holgiw/ESP32-netspeaker/stations/README.md

# Senderlisten / Station lists

## Deutsch

Fertige Listen für den Tab *Webradio*. Im Abschnitt *Senderlisten* bei *Fertige Liste* eine Liste wählen und *Von GitHub laden* drücken, oder die Datei herunterladen und mit *Liste laden* einlesen. **Das Laden ersetzt die ganze Senderliste**; vorher mit *Liste speichern* sichern. RSA wird nur dann vorn eingetragen, wenn die Senderliste vorher leer war; bei allen Änderungen danach wird er nicht wieder eingetragen (die Listen hier enthalten ihn nicht). Vorn stehen deine Favoriten (Tab *Webradio*), dann die Sender der Liste ohne Doppelte; was über die 30 Plätze hinausgeht, entfällt.

Die Auswahl im Tab stammt aus der Datei `index.txt` in diesem Ordner (eine Zeile je Liste: `name|Beschreibung deutsch|Beschreibung englisch`). **Eine neue Liste braucht kein neues Flashen:** Datei `name.txt` und eine Zeile in `index.txt` auf GitHub ablegen, dann erscheint sie nach dem Neuladen der Seite. Ohne Internet im Browser bleiben die vier ersten Listen im Auswahlfeld.

| Datei | Inhalt |
|---|---|
| `aac-auswahl` | 29 Sender: Sender als AAC/HE-AAC |
| `mp3-auswahl` | 29 Sender: Beliebte deutsche Sender als MP3 |
| `rock` | 25 Sender: Rock, Metal, Punk und Klassiker |
| `entspannung` | 24 Sender: Ruhe, Klassik, Jazz und Chillout |
| `schlager` | 24 Sender: Deutscher Schlager und Volksmusik |
| `country` | 24 Sender: Country, Bluegrass und Western |
| `folk` | 24 Sender: Folk, Irish, Celtic und Akustik |
| `jazz` | 24 Sender: Jazz, Smooth Jazz, Blues und Lounge |
| `klassik` | 24 Sender: Klassik, Oper und Barock |
| `pop-charts` | 24 Sender: Pop, Charts und Hitradios aus Deutschland |
| `jahrzehnte` | 24 Sender: Oldies, 60er bis 90er |
| `dance` | 24 Sender: Dance, Electro, House und Techno |
| `hiphop` | 24 Sender: Hip-Hop, Rap und R&B |
| `irland` | 24 Sender: Beliebte Sender aus Irland |
| `usa` | 24 Sender: Beliebte Sender aus den USA |
| `australien` | 24 Sender: Beliebte Sender aus Australien |
| `grossbritannien` | 24 Sender: Beliebte Sender aus Großbritannien |
| `frankreich` | 24 Sender: Beliebte Sender aus Frankreich |
| `weihnachten` | 24 Sender: Weihnachtslieder und Weihnachtsradios |

Alle Streams waren beim Anlegen erreichbar (Audiodaten abgerufen; die AAC-Sender zusätzlich auf dem Gerät abgespielt). Sender ändern ihre Adressen von Zeit zu Zeit; ein toter Eintrag lässt sich im Tab ersetzen.

## English

Ready-made lists for the *Webradio* tab. In the section *Senderlisten* pick a list at *Fertige Liste* and press *Von GitHub laden*, or download the file and read it in with *Liste laden*. **Loading replaces the whole station list**; save it first with *Liste speichern*. RSA is put at the front only if the station list was empty before; with all changes after that it is not entered again (the lists here do not contain it). Your favorites (*Webradio* tab) come first, then the stations of the list without duplicates; whatever exceeds the 30 slots is dropped.

The selection in the tab comes from the file `index.txt` in this folder (one line per list: `name|description German|description English`). **A new list needs no new flashing:** put the file `name.txt` and one line in `index.txt` on GitHub, and it appears after the page is reloaded. Without internet in the browser the first four lists stay in the selection field.

| File | Content |
|---|---|
| `aac-auswahl` | 29 stations: Stations as AAC/HE-AAC |
| `mp3-auswahl` | 29 stations: Popular German stations as MP3 |
| `rock` | 25 stations: Rock, metal, punk and classics |
| `entspannung` | 24 stations: Calm, classical, jazz and chillout |
| `schlager` | 24 stations: German Schlager and folk music |
| `country` | 24 stations: Country, bluegrass and western |
| `folk` | 24 stations: Folk, Irish, Celtic and acoustic |
| `jazz` | 24 stations: Jazz, smooth jazz, blues and lounge |
| `klassik` | 24 stations: Classical, opera and baroque |
| `pop-charts` | 24 stations: Pop, charts and hit radio from Germany |
| `jahrzehnte` | 24 stations: Oldies, 60s to 90s |
| `dance` | 24 stations: Dance, electro, house and techno |
| `hiphop` | 24 stations: Hip hop, rap and R&B |
| `irland` | 24 stations: Popular stations from Ireland |
| `usa` | 24 stations: Popular stations from the USA |
| `australien` | 24 stations: Popular stations from Australia |
| `grossbritannien` | 24 stations: Popular stations from the UK |
| `frankreich` | 24 stations: Popular stations from France |
| `weihnachten` | 24 stations: Christmas songs and Christmas radios |

All streams were reachable when the lists were made (audio data retrieved; the AAC stations were also played on the device). Stations change their addresses from time to time; a dead entry can be replaced in the tab.
