holgiw/ESP32-netspeaker/docs/screenshots/07-doku.jpg

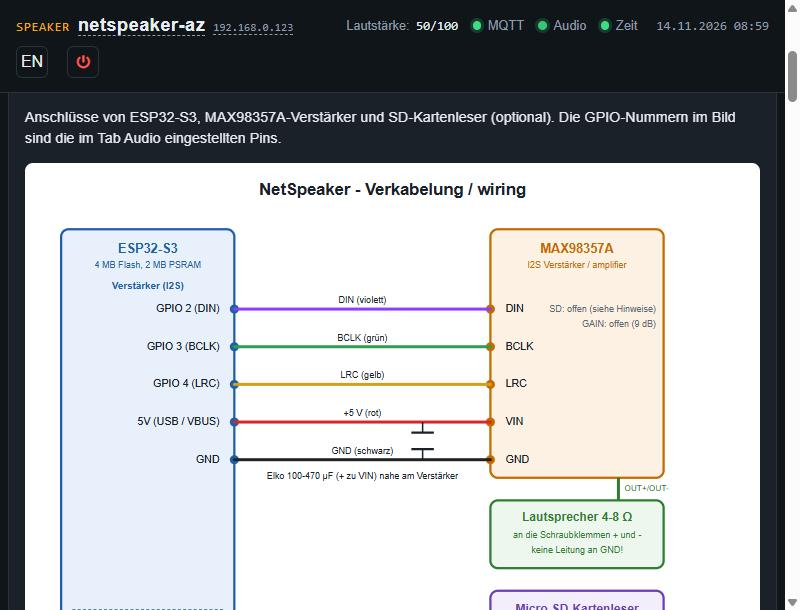
docs/screenshots/07-doku.jpg
