holgiw/ESP32-netspeaker/docs/screenshots/08-webradio-english.jpg

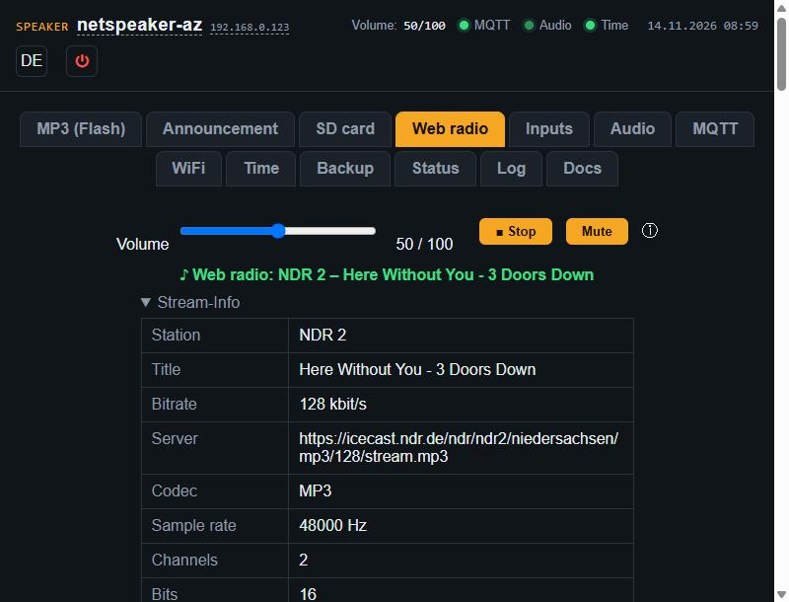
docs/screenshots/08-webradio-english.jpg
