holgiw/ESP32-netspeaker/docs/screenshots/09-sicherung.jpg

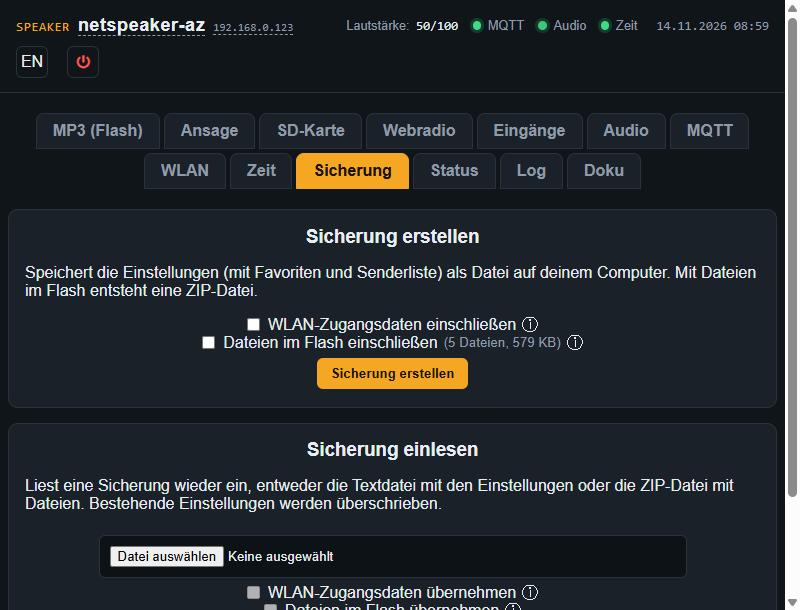
docs/screenshots/09-sicherung.jpg
