holgiw/ESP32-netspeaker/CHANGELOG.md

# Changelog

## 2026-11-14 - Version 1.6.11

**Deutsch**

- Neu: Das MQTT-Passwort steht jetzt in der Sicherung (verschlüsselt wie die WLAN-Passwörter und der VoiceRSS-Schlüssel, nur beim Export aus dem lokalen Netz) und wird beim Import wieder eingelesen, ebenfalls nur aus dem lokalen Netz. Es erscheint nur, wenn ein Benutzer und ein Passwort gespeichert sind.

**English**

- New: the MQTT password is now part of the backup (encrypted like the WiFi passwords and the VoiceRSS key, only when exporting from the local network) and is read again on import, also only from the local network. It appears only if a user and a password are stored.

## 2026-11-14 - Version 1.6.10

**Deutsch**

- Neu: Der VoiceRSS-Schlüssel steht jetzt in der Sicherung (verschlüsselt wie die WLAN-Passwörter, nur beim Export aus dem lokalen Netz) und wird beim Import wieder eingelesen. Das MQTT-Passwort bleibt weiter draußen.

**English**

- New: the VoiceRSS key is now part of the backup (encrypted like the WiFi passwords, only when exporting from the local network) and is read again on import. The MQTT password stays out.

## 2026-11-14 - Version 1.6.9

**Deutsch**

- Geändert: Die WLAN-Passwörter stehen in der Sicherung (Export mit `wifi=1`) nicht mehr im Klartext, sondern verschlüsselt (AES-256, Format `enc:<IV>:<Daten>`). Der Schlüssel steckt in der Firmware und ist in allen Geräten gleich, eine Sicherung lässt sich also auf jedem Gerät einspielen. Alte Sicherungen mit Klartext-Passwörtern lassen sich weiter einlesen.

**English**

- Changed: the WiFi passwords in the backup (export with `wifi=1`) are no longer in plain text but encrypted (AES-256, format `enc:<IV>:<data>`). The key is part of the firmware and the same in all devices, so a backup can be restored on any device. Old backups with plain-text passwords can still be imported.

## 2026-11-14 - Version 1.6.8

**Deutsch**

- Geändert: Die englische Übersetzung ist in die Firmware eingebaut und nach dem Flashen sofort da; `makeLangHeader.ps1` erzeugt sie beim Bauen aus `lang/en.json`. Das Hochladen und das Laden von GitHub entfallen samt der zugehörigen Aufrufe (`/upload?target=lang`, `POST /api/lang` mit `fetch`/`delete`); `/lang.json?l=en` und `GET /api/lang` bleiben. Gespeicherte Sprachdateien früherer Versionen löscht das Gerät beim Start.

**English**

- Changed: the English translation is built into the firmware and available right after flashing; `makeLangHeader.ps1` creates it from `lang/en.json` at build time. Uploading and loading from GitHub are gone together with the related calls (`/upload?target=lang`, `POST /api/lang` with `fetch`/`delete`); `/lang.json?l=en` and `GET /api/lang` stay. The device deletes stored language files of earlier versions at start.

## 2026-11-14 - Version 1.6.7

**Deutsch**

- Neu: Kommt ein MP3-Aufruf, während nur noch die zweite Datei läuft (die erste ist zu Ende), wird der neue Sound sofort die neue Hauptdatei, mit allen Effekten, und die zweite läuft ohne Lücke weiter. Ein dritter gleichzeitiger Sound wartet weiter in der Warteschlange.

**English**

- New: if an MP3 call arrives while only the second file is still running (the first has ended), the new sound immediately becomes the new main file, with all effects, and the second one keeps playing without a gap. A third simultaneous sound still waits in the queue.

## 2026-11-14 - Version 1.6.6

**Deutsch**

- Neu: Dateiaufrufe über REST und MQTT nehmen die Stereo-Position an: `pan` (`off`, `left` links, `right` rechts, `lr` links nach rechts, `rl` rechts nach links, `pp` hin und her) und `pansec` (Dauer eines Durchgangs in Sekunden), auch für Ordner. Ohne Angabe gilt die Einstellung im Tab *Ansage*. Die Knöpfe *URL* und *curl* in den Tabs *MP3 (Flash)* und *SD-Karte* kopieren `pan=off&pansec=3` mit.
- Neu: Eine gespeicherte Ansage mit Effektangaben im Namen (zum Beispiel `…_522f18df_halle34.mp3`) spielt beim direkten Abspielen als Datei mit diesen Werten (Hall, Echo, Bässe, Höhen, Wandern); `pan` und `pansec` des Aufrufs haben Vorrang. Normale Dateien bleiben ohne Hall und Echo.

**English**

- New: file calls via REST and MQTT accept the stereo position: `pan` (`off`, `left`, `right`, `lr` left to right, `rl` right to left, `pp` back and forth) and `pansec` (duration of one pass in seconds), also for folders. Without it the setting in the *Ansage* tab applies. The *URL* and *curl* buttons in the *MP3 (Flash)* and *SD-Karte* tabs copy `pan=off&pansec=3`.
- New: a saved announcement with effect values in its name (for example `…_522f18df_halle34.mp3`) plays with these values (reverb, echo, bass, treble, sweep) when played directly as a file; `pan` and `pansec` of the call take precedence. Normal files stay without reverb and echo.

## 2026-11-13 - Version 1.6.5

**Deutsch**

- Behoben: Endet die erste von zwei gleichzeitig laufenden Dateien früher, spielt die zweite bis zu ihrem Ende weiter (bisher wurde sie mit abgebrochen). Dabei läuft sie lückenlos weiter: die Audio-Bibliothek hält die Ausgabe nach dem Ende der ersten Datei mit Stille offen, bis die zweite fertig ist.

**English**

- Fixed: if the first of two files playing together ends earlier, the second one keeps playing to its end (before it was cut off). It continues without a gap: after the end of the first file the audio library keeps the output open with silence until the second one is finished.

## 2026-11-13 - Version 1.6.4

**Deutsch**

- Geändert: Im Flash gespeicherte Texte (*Text speichern* ohne SD-Karte) liegen jetzt im Unterordner `ansagen` des MP3-Ordners, nicht mehr zwischen den eigenen MP3-Dateien. Im Tab *MP3 (Flash)* erscheinen sie als `ansagen/…`; Abspielen, Löschen, Umbenennen, Sicherung und Wiederherstellen kennen den Unterordner. Ältere Texte im MP3-Ordner werden weiter gefunden.
- Neu: MP3-Dateien über REST oder MQTT laufen gleichzeitig übereinander statt nacheinander: kommt ein Aufruf, während schon eine Datei (oder ein Text über dem Radio) läuft, startet die zweite sofort auf der freien Mischspur, zum Beispiel Vogelgezwitscher mit einer Glocke darüber. Höchstens zwei Klänge zugleich (das Webradio zählt nicht mit), ein dritter wartet in der Warteschlange; Texte laufen weiter nacheinander. Beide Dateien laufen mit ihrer eigenen Lautstärke weiter, die laufende Datei wird nicht abgesenkt; nur ein Webradio senkt sich wie bei Ansagen nach der Einstellung *Radio bei* im Tab *Audio* (Texte über einer Datei senken diese weiter ab).
- Neu: Effekt *Wandern* im Tab *Ansage* (Karte *Klangeffekte*): der Ton wandert zwischen links und rechts (links → rechts, rechts → links, hin und her) mit einstellbarer *Dauer* (0,5 bis 20 s je Durchgang). Wirkt auf Ansagen und Dateien, nie auf Webradio; mit Hall und Klangreglern kombinierbar; hörbar nur im Stereo-Aufbau mit zwei Verstärkermodulen. REST `pan` (`off`, `lr`, `rl`, `pp`) und `pansec`, Export `panm`, `pand`; die Werte stehen auch im Dateinamen gespeicherter Texte (`_wl30`).
- Geändert: Die Knöpfe *URL* und *curl* (Tabs *MP3 (Flash)*, *SD-Karte*) sowie die REST-Aufrufe bei Sendern und Favoriten kopieren Beispielwerte für alle Parameter: `…/api/file?file=…&vol=60&shuffle=0&loop=0`, `…/api/station?n=3&vol=60`, `…/api/play` mit `vol=60`; bei Sendern und Favoriten zusätzlich die MQTT-Nutzlast als JSON.
- Geändert: Der Tab *Sprechen* heißt jetzt *Ansage* (Adresse `?tab=ansage`; `?tab=sprechen` aus alten Lesezeichen führt weiter dorthin). Die Tabs *MP3 (Flash)* und *SD-Karte* laden ihre Liste bei jedem Öffnen neu.
- Neu: Der Tab *MP3 (Flash)* zeigt die Dateien wie der Tab *SD-Karte*: Ordner als Zeilen (Unterordner `ansagen`) zum Öffnen, `..` zurück, je Ordner *▶ Ordner*, *🔀 Zufall*, *URL*, *curl* und Löschen, je Datei Abspielen, Herunterladen, *URL*, *curl*, Umbenennen, Löschen. Neue Routen `GET /api/flash?dir=`; ein Name mit `/` am Ende (`ansagen/`, `/`) spielt den Ordner, `/api/delete` löscht den Unterordner `ansagen` samt Inhalt.
- Neu: Das Log nennt bei jeder Ansage den Effekt (`announcement effect: …`); `/api/effect` zeigt mit `annMode` und `annLoad` die Werte der letzten Ansage.
- Behoben: Eine Datei, die über ein Radio gemischt wird (SD-Datei als Overlay), setzte die Effektwerte einer laufenden Ansage zurück.
- Behoben: Englische Texte: Doku-Karte *Sicherung* und ein Tooltip im SD-Tab waren unübersetzt; doppelte Einträge entfernt.

**English**

- Changed: texts saved in flash (*Text speichern* without an SD card) now lie in the subfolder `ansagen` of the MP3 folder, no longer between your own MP3 files. In the *MP3 (Flash)* tab they appear as `ansagen/…`; playing, deleting, renaming, backup and restore know the subfolder. Older texts in the MP3 folder are still found.
- New: MP3 files via REST or MQTT play on top of each other instead of one after another: if a call arrives while a file (or a text over the radio) is already running, the second starts at once on the free mix track, for example birdsong with a bell over it. At most two sounds at a time (the web radio does not count), a third waits in the queue; texts still run one after another. Both files keep playing at their own volume, the running file is not lowered; only a web radio is lowered like for announcements according to the setting *Radio bei* in the *Audio* tab (texts over a file still lower it).
- New: effect *Wandern* (sweep) in the *Ansage* tab (card *Klangeffekte*): the sound moves between left and right (left → right, right → left, back and forth) with an adjustable *Dauer* (duration, 0.5 to 20 s per pass). Acts on announcements and files, never on web radio; can be combined with reverb and tone control; audible only in the stereo setup with two amplifier modules. REST `pan` (`off`, `lr`, `rl`, `pp`) and `pansec`, export `panm`, `pand`; the values are also in the file name of saved texts (`_wl30`).
- Changed: the buttons *URL* and *curl* (tabs *MP3 (Flash)*, *SD card*) and the REST calls for stations and favorites copy example values for all parameters: `…/api/file?file=…&vol=60&shuffle=0&loop=0`, `…/api/station?n=3&vol=60`, `…/api/play` with `vol=60`; for stations and favorites also the MQTT payload as JSON.
- Changed: the tab *Sprechen* is now called *Ansage* (address `?tab=ansage`; `?tab=sprechen` from old bookmarks still leads there). The tabs *MP3 (Flash)* and *SD card* reload their list every time they are opened.
- New: the *MP3 (Flash)* tab shows the files like the *SD card* tab: folders as rows (subfolder `ansagen`) to open, `..` back, per folder *▶ Ordner*, *🔀 Zufall*, *URL*, *curl* and delete, per file play, download, *URL*, *curl*, rename, delete. New route `GET /api/flash?dir=`; a name ending in `/` (`ansagen/`, `/`) plays the folder, `/api/delete` deletes the subfolder `ansagen` with its content.
- New: the log names the effect for every announcement (`announcement effect: …`); `/api/effect` shows the values of the last announcement with `annMode` and `annLoad`.
- Fixed: a file mixed over a radio (SD file as overlay) reset the effect values of a running announcement.
- Fixed: English texts: the *Sicherung* docs card and a tooltip in the SD tab were untranslated; duplicate entries removed.

## 2026-11-13 - Version 1.6.3

**Deutsch**

- Geändert: Hall und Echo wirken nicht mehr auf abgespielte Dateien (zu hohe Rechenlast, besonders bei zwei Spuren), nur noch auf Ansagen; Klangregler und Wandern wirken weiter auch auf Dateien.
- Behoben: Zwei MP3-Dateien zugleich klangen abgehackt. Die Dekodier-Tasks der Mischspuren laufen jetzt auf dem zweiten Kern, und der Mischer lässt die Audio-Bibliothek in seinen Wartezeiten weiterlaufen; das Log meldet je Spur Aussetzer und Dekodierzeit (`[MIX] track N ended: …`).
- Geändert: Webradio läuft immer ohne Klangeffekt. Die Effekte wirken nur noch auf Ansagen und abgespielte Dateien. Der Haken *Auch auf Ansagen anwenden* und der Parameter `ann` entfallen.
- Neu: Ansagen über REST (`/api/say`) und MQTT (`/say`, JSON) haben den Parameter `fx` (Standard 1); mit `fx=0` läuft die einzelne Ansage ohne Klangeffekt, auch wenn der Text mit Effekt gespeichert ist. Mit `save=1` wird der Text dann trocken gespeichert.
- Neu: Hinweis zu Stereo in den Verkabelungsbildern und in der README: ein zweites MAX98357A-Modul am selben I2S-Bus, der SD-Pin wählt den Kanal (links direkt an VIN, rechts über etwa 470 kΩ an VIN, bei 5 V).
- Behoben: Die Hinweise zum SD-Pin des Verstärkers in den Verkabelungsbildern (Doku-Tab und README) waren ungenau. Jetzt steht dort die Pegeltabelle des MAX98357A (unter 0,16 V aus, 0,16–0,77 V Mono-Mix, 0,77–1,4 V rechter, über 1,4 V linker Kanal) und der Hinweis, dass ein offener SD-Pin je nach Modul Mono-Mix (Adafruit, 1 MΩ nach VIN) oder aus bedeutet.

**English**

- Changed: reverb and echo no longer act on played files (too much computing load, especially with two tracks), only on announcements; tone control and sweep still also act on files.
- Fixed: two MP3 files at the same time sounded choppy. The decoder tasks of the mix tracks now run on the second core, and the mixer lets the audio library keep running during its waiting times; the log reports dropouts and decode time per track (`[MIX] track N ended: …`).
- Changed: web radio always plays without sound effect. The effects now act only on announcements and played files. The checkbox *Auch auf Ansagen anwenden* and the parameter `ann` are removed.
- New: announcements via REST (`/api/say`) and MQTT (`/say`, JSON) have the parameter `fx` (default 1); with `fx=0` the single announcement plays without sound effect, even if the text is saved with an effect. With `save=1` the text is then saved dry.
- New: note about stereo in the wiring pictures and in the README: a second MAX98357A module on the same I2S bus, the SD pin selects the channel (left directly to VIN, right through about 470 kΩ to VIN, at 5 V).
- Fixed: the notes about the SD pin of the amplifier in the wiring pictures (Docs tab and README) were imprecise. They now give the voltage table of the MAX98357A (below 0.16 V off, 0.16–0.77 V mono mix, 0.77–1.4 V right, above 1.4 V left channel) and the note that an open SD pin means mono mix (Adafruit, 1 MΩ to VIN) or off depending on the module.

## 2026-11-13 - Version 1.6.2

**Deutsch**

- Neu: Tab *Sicherung*: Die Einstellungen (mit Favoriten und Senderliste) lassen sich als Datei sichern und wieder einlesen, wahlweise mit WLAN-Passwörtern (nur aus dem lokalen Netz) und mit den Dateien im Flash (MP3, auch gespeicherte Texte) als ZIP-Datei; die SD-Karte ist nie dabei. Beim Einlesen lassen sich WLAN und Dateien getrennt abwählen. Neue Routen: `GET /export?wifi=1`, `GET /api/fileget?file=…`; `/import` nimmt auch `pass1` bis `pass3`.
- Neu: Die Statusseite zeigt die Release-Nummer mit Link zum Release (`/api/status` hat `version`).
- Geändert: Export und Import sind nicht mehr als Symbole in der Statusleiste; sie stehen im Tab *Sicherung*.
- Behoben: Die Meldung nach dem Einlesen zeigte "Werte þrnommen" statt "übernommen". Ein unveränderter SD-Pin löst keinen Neustart-Hinweis mehr aus.

**English**

- New: *Sicherung* (backup) tab: the settings (with favorites and station list) can be saved to a file and read in again, optionally with WiFi passwords (only from the local network) and with the files in flash (MP3, including saved texts) as a ZIP file; the SD card is never included. When restoring, WiFi and files can be deselected separately. New routes: `GET /export?wifi=1`, `GET /api/fileget?file=…`; `/import` also accepts `pass1` to `pass3`.
- New: the status page shows the release number with a link to the release (`/api/status` has `version`).
- Changed: export and import are no longer icons in the status bar; they are in the *Sicherung* tab.
- Fixed: the message after restoring showed "Werte þrnommen" instead of "übernommen". An unchanged SD pin no longer triggers the restart hint.

## 2026-11-13 - Version 1.6.1

**Deutsch**

- Neu: Die grüne Leiste zeigt bei einer Ansage, woher der Text kommt: `♪ Ansage (VoiceRSS)`, `(gespeichert auf SD-Karte)`, `(gespeichert im Flash)` oder `(Zwischenspeicher)`. Das gilt auch, wenn die Ansage über ein Radio gemischt wird. Der Status liefert dazu `speechOn`, `speechSrc` und `speechSeq`.
- Geändert: Der Haken *Text speichern* im Tab *Sprechen* verschwindet erst nach der Ansage, nicht schon beim Absenden.

**English**

- New: the green bar shows where the text of an announcement comes from: `♪ Ansage (VoiceRSS)`, `(gespeichert auf SD-Karte)` (saved on SD card), `(gespeichert im Flash)` (saved in flash) or `(Zwischenspeicher)` (cache). This also applies when the announcement is mixed over a radio. The status provides `speechOn`, `speechSrc` and `speechSeq` for this.
- Changed: the checkbox *Text speichern* in the *Sprechen* tab is cleared only after the announcement, not when it is submitted.

## 2026-11-13 - Version 1.6.0

**Deutsch**

- Neu: **Klangeffekte** im Tab *Sprechen* (Karte *Klangeffekte*): Hall (*Zimmer*, *Halle*, *Kirche*), *Echo* und Klangregler (*Bässe* und *Höhen*, je ±12 dB), mit *Anteil* und dem Haken *Auch auf Ansagen anwenden*. Die Effekte wirken auf den ganzen Ausgang, gelten sofort und bleiben gespeichert. REST `GET`/`POST /api/effect` (`mode`, `wet`, `ann`, `bass`, `treble`; `GET` zeigt auch die Rechenlast `load`), Export `fxmode`, `fxwet`, `fxann`, `eqb`, `eqt`. Der Hall belastet den Audio-Kern mit rund 40 %, Echo etwa 6 %, die Klangregler etwa 3 %; der Speicher (rund 136 KB) liegt im PSRAM.
- Neu: Die Adresszeile zeigt den aktuellen Tab (`?tab=<name>`); Neuladen und Lesezeichen bleiben im Tab.
- Neu: *Text speichern* legt die aktuellen Effektwerte mit dem Text ab (im Dateinamen, zum Beispiel `Achtung_auf_Gleis_3_3fa9c2e1_halle40_b3_t-2.mp3`). Ein gespeicherter Text wird später mit genau diesen Werten über eine eigene Effekt-Instanz gespielt, unabhängig von den allgemeinen Einstellungen; Radio und Dateien behalten ihre. Speichert man denselben Text mit anderen Werten erneut, ersetzt die neue Datei die alte.
- Behoben: Die Dateiverwaltung im Flash kürzte Dateinamen über 40 Zeichen; gespeicherte Texte ließen sich dadurch nicht löschen oder abspielen. Die Grenze liegt jetzt bei 100 Zeichen.
- Behoben: Englische Texte zu mehreren Tooltips und Meldungen ergänzt.

**English**

- New: **sound effects** in the *Sprechen* (speak) tab (card *Klangeffekte*): reverb (*Zimmer* room, *Halle* hall, *Kirche* church), *Echo* and tone control (*Bässe* bass and *Höhen* treble, each ±12 dB), with *Anteil* (amount) and the checkbox *Auch auf Ansagen anwenden* (also apply to announcements). The effects act on the whole output, apply at once and are saved. REST `GET`/`POST /api/effect` (`mode`, `wet`, `ann`, `bass`, `treble`; `GET` also shows the processing load `load`), export `fxmode`, `fxwet`, `fxann`, `eqb`, `eqt`. The reverb loads the audio core with about 40 %, echo about 6 %, the tone control about 3 %; the memory (about 136 KB) lives in PSRAM.
- New: the address bar shows the current tab (`?tab=<name>`); reloading and bookmarks stay in the tab.
- New: *Text speichern* (save text) stores the current effect values with the text (in the file name, for example `Achtung_auf_Gleis_3_3fa9c2e1_halle40_b3_t-2.mp3`). A saved text is later played with exactly these values through an effect instance of its own, regardless of the general settings; radio and files keep theirs. Saving the same text again with other values replaces the old file with the new one.
- Fixed: the file management in flash shortened file names over 40 characters; saved texts could not be deleted or played because of this. The limit is now 100 characters.
- Fixed: English texts added for several tooltips and messages.

## 2026-11-13 - Version 1.5.3

**Deutsch**

- Geändert: Die Tabs der Weboberfläche werden einzeln nachgeladen (`/panel?tab=<name>`). Die Startseite enthält nur Rahmen, Statusleiste und den aktiven Tab; jeder weitere Tab holt sich beim ersten Anklicken seinen Inhalt. Das spart Arbeitsspeicher und Zeit beim Öffnen der Seite und belastet die Hauptschleife weniger.
- Neu: Genre *Weihnachten* bei *Von radio-browser laden* (Tab *Webradio*): holt die beliebtesten Weihnachtssender des gewählten Landes.
- Neu: Fertige Senderliste `weihnachten` (24 Sender mit Weihnachtsliedern) im Ordner `stations/`; sie erscheint nach dem Neuladen der Seite bei *Fertige Liste*, ohne neues Flashen.
- Neu: Einstellung *Ansagen auf der SD-Karte zwischenspeichern* (Tab *Audio*, Sprachausgabe, Standard aus): Ein von VoiceRSS geholter Text wird als MP3 im Ordner `/tts` der SD-Karte abgelegt (Name: Texthinweis und Prüfsumme, zum Beispiel `Achtung_auf_Gleis_3_3fa9c2e1.mp3`) und beim nächsten Mal von dort gespielt, auch ohne Internet. Höchstens 500 Dateien; Knopf *Zwischenspeicher leeren*, REST `GET`/`POST /api/ttscache`, Export `ttsc`. Im Log steht bei eingeschaltetem Zwischenspeicher, ob der Text aus dem Cache oder von VoiceRSS kommt. Im Tab *Sprechen* speichert der Haken *Text speichern* die Sprachdatei des nächsten Sprechens dauerhaft (bevorzugt SD-Karte, Ordner `/ansagen`, sonst Flash, sichtbar im Tab *MP3 (Flash)*) und entfernt sich danach selbst; gespeicherte Texte werden vor VoiceRSS verwendet (REST: `save=1` bei `/api/say`, MQTT-JSON `save`). Der Tab *SD-Karte* hat einen Knopf *Aktualisieren* und je Datei und Ordner die Knöpfe *URL* und *curl* zum Kopieren des REST-Aufrufs.

**English**

- Changed: the tabs of the web interface are loaded one by one (`/panel?tab=<name>`). The start page only contains the frame, the status bar and the active tab; every other tab fetches its content the first time it is clicked. This saves memory and time when opening the page and puts less load on the main loop.
- New: genre *Christmas* for *Von radio-browser laden* (*Webradio* tab): fetches the most popular Christmas stations of the chosen country.
- New: ready-made station list `weihnachten` (24 stations with Christmas songs) in the `stations/` folder; it appears after reloading the page under *Fertige Liste*, no flashing needed.
- New: setting *Cache announcements on the SD card* (*Audio* tab, speech output, default off): a text fetched from VoiceRSS is stored as MP3 in the folder `/tts` of the SD card (name: text hint and checksum, for example `Achtung_auf_Gleis_3_3fa9c2e1.mp3`) and played from there next time, even without internet. At most 500 files; button *Zwischenspeicher leeren* (clear cache), REST `GET`/`POST /api/ttscache`, export `ttsc`. With the cache on, the log shows whether the text comes from the cache or from VoiceRSS. In the *Sprechen* tab the checkbox *Text speichern* (save text) saves the speech file of the next utterance permanently (preferably SD card, folder `/ansagen`, otherwise flash, visible in the *MP3 (Flash)* tab) and clears itself afterwards; saved texts are used before VoiceRSS (REST: `save=1` on `/api/say`, MQTT JSON `save`). The *SD card* tab has a *Refresh* button and, for every file and folder, the buttons *URL* and *curl* to copy the REST call.

## 2026-11-11 - Version 1.5.2

**Deutsch**

- Behoben: Die englische Übersetzung (`en.json`) war im Tab *WLAN* und in der Karte *More calls* des Tabs *Doku* teilweise beschädigt (falsche Umlaute) und lückenhaft. Repariert; neu übersetzt sind "Verbunden mit", der Hinweis zu SSID und Passwort und die Länderliste.
- Behoben: Im Tab *Eingänge* stand "Sender zuräck" statt "Sender zurück" und im Platzhalter "Die Tär ist offen" statt "Die Tür ist offen".
- Hinweis: Die Sprachdatei wird beim Flashen nicht erneuert. Im Tab *Status* in der Karte *Sprache / Language* mit **Von GitHub laden** die neue `en.json` holen.

**English**

- Fixed: the English translation (`en.json`) was partly damaged (wrong umlauts) and incomplete in the *WiFi* tab and in the *More calls* card of the *Docs* tab. Repaired; newly translated are "Connected to", the hint about SSID and password and the list of countries.
- Fixed: in the *Inputs* tab "Sender zuräck" was shown instead of "Sender zurück" and the placeholder said "Die Tär ist offen" instead of "Die Tür ist offen".
- Note: flashing does not renew the language file. In the *Status* tab, card *Sprache / Language*, use **Von GitHub laden** to get the new `en.json`.

## 2026-11-11 - Version 1.5.1

**Deutsch**

- Behoben: In der Verkabelungsansicht (Tab *Doku*, README) stimmte die Pin-Reihenfolge des SD-Kartenlesers nicht. Jetzt: 3V3, CS, MOSI, SCK, MISO, GND; die vier Signalpins liegen den ESP-Pins GP13, GP12, GP11 und GP10 direkt gegenüber.

**English**

- Fixed: in the wiring view (*Doku* tab, README) the pin order of the SD card reader was wrong. Now: 3V3, CS, MOSI, SCK, MISO, GND; the four signal pins sit directly opposite the ESP pins GP13, GP12, GP11 and GP10.

## 2026-11-11 - Version 1.5.0

**Deutsch**

- Neu: Einstellung *Vorpuffer Webradio* (Tab *Audio*, 0 bis 30 Sekunden, Standard 5): Das Radio beginnt erst zu spielen, wenn so viele Sekunden Ton im Puffer liegen. Ein größerer Wert überbrückt kurze Aussetzer des Streams (Meldung `slow stream` im Log); dafür kommt der Ton nach dem Start eines Senders entsprechend später. Der Wert gilt sofort und steht im Export (`prebuf`).
- Behoben: Ein Webzugriff konnte die Hauptschleife und damit das Nachladen des Tons mehrere Sekunden anhalten (hörbar als `slow stream`). Log, Export, Favoriten- und Sender-Download und große JSON-Antworten werden jetzt in Stücken zu 1 KB gesendet; dazwischen lädt die Firmware den Audio-Puffer nach.
- Neu: Dauert ein Durchlauf der Hauptschleife länger als 500 ms, steht im Log `[LOOP] stall ... ms in <Schritt>` (Suche nach Blockaden).
- Geändert: Der Tab *WLAN* ist wie bei der Uhr aufgebaut: Status "Verbunden mit", Hostname mit eigenem Speichern-Knopf, `Netzwerke neu scannen` (die Suche läuft im Hintergrund und blockiert den Ton nicht; die Auswahllisten zeigen Signalstärke und Verschlüsselung), alle belegten Plätze plus ein leerer, je Platz `Verbinden` (bringt das Netz an die erste Stelle, Neustart) und `Löschen`, beides mit Rückfrage und nur aus dem lokalen Netz, Hinweis im Access-Point-Modus. Leere Plätze rücken beim Speichern nach oben. Neue Routen: `/sethostname`, `/deletewifi`, `/api/connectWifi`, `/api/scanwifi`, `/api/rescanwifi`.
- Geändert: **Stumm** (REST, MQTT, Pin) gilt jetzt für Webradio, Text-Ansagen (Uhrzeit, Mail ...) und MP3 von der SD-Karte. MP3 aus dem Flash bleiben hörbar. Vorher blieben auch Text-Ansagen hörbar.
- Neu: Im Tab *Doku* und in der README steht zusätzlich eine Verkabelungsansicht mit den Bauteilen (`verkabelung_ansicht.svg`): links Verstärker und Lautsprecher, rechts SD-Kartenleser, in der Mitte der Waveshare ESP32-S3-Zero.

**English**

- New: setting *Web radio prebuffer* (*Audio* tab, 0 to 30 seconds, default 5): the radio only starts playing when this many seconds of sound are in the buffer. A larger value bridges short dropouts of the stream (message `slow stream` in the log); the sound comes correspondingly later after a station starts. The value applies at once and is part of the export (`prebuf`).
- Fixed: a web request could hold the main loop, and with it the refilling of the sound, for several seconds (audible as `slow stream`). Log, export, favorites and station downloads and large JSON answers are now sent in pieces of 1 KB; in between the firmware refills the audio buffer.
- New: if one pass of the main loop takes longer than 500 ms, the log shows `[LOOP] stall ... ms in <step>` (hunting for blockades).
- Changed: the *WiFi* tab is built like the one of the clock: status "Connected to", hostname with its own Save button, `Rescan networks` (the scan runs in the background and does not block the sound; the selection lists show signal strength and encryption), all used slots plus one empty one, per slot `Connect` (moves the network to the first place, restart) and `Delete`, both with a prompt and only from the local network, a hint in access point mode. Empty slots move up when saving. New routes: `/sethostname`, `/deletewifi`, `/api/connectWifi`, `/api/scanwifi`, `/api/rescanwifi`.
- Changed: **mute** (REST, MQTT, pin) now applies to web radio, text announcements (time, mail ...) and MP3 from the SD card. MP3 from the flash stay audible. Before, text announcements stayed audible as well.
- New: the *Doku* tab and the README now also show a wiring view with the components (`verkabelung_ansicht.svg`): amplifier and speaker on the left, SD card reader on the right, the Waveshare ESP32-S3-Zero in the middle.

## 2026-11-06 - Version 1.4.13

**Deutsch**

- Neu: Die Pins (Tab Pins) können jetzt auch das Radio steuern: Radio starten (zuletzt gespielter Sender), Sender vor, Sender zurück, Lauter, Leiser (Schrittweite im Feld Lautstärke, Standard 5), Stumm (umschalten) und Stopp. Über REST: `type=radio|next|prev|volup|voldown|mute|stop`.
- Geändert: Die Tabelle im Tab Pins zeigt nur Pins mit Aktion und darunter eine Zeile mit Auswahl des nächsten freien GPIO. Ein gemeinsamer Speichern-Knopf oben rechts speichert alle Änderungen; danach kann der nächste freie Pin gewählt werden. "Keine Aktion" entfernt einen Pin aus der Liste. Bei "Keine Aktion" und bei Steuer-Aktionen sind nicht benötigte Felder ausgeblendet; bei Lauter/Leiser steht die Schrittweite 5 schon im Feld, mit ⓘ-Hinweis.

**English**

- New: the pins can now also control the radio: start radio (last played station), next station, previous station, louder, quieter (step size in the volume field, default 5), mute (toggle) and stop. Via REST: `type=radio|next|prev|volup|voldown|mute|stop`.
- Changed: the table in the Pins tab shows only pins with an action, followed by one row to pick the next free GPIO. One common Save button at the top right saves all changes; afterwards the next free pin can be chosen. "No action" removes a pin from the list. Fields that are not needed are hidden for "No action" and for control actions; for Louder/Quieter the step 5 is already in the field, with an ⓘ hint.

## 2026-11-06 - Version 1.4.12

**Deutsch**

- Behoben: Die NTP-Servernamen standen nur in lokalen Variablen, der SNTP-Dienst merkt sich aber nur den Zeiger. Dadurch fragte das Gerät später Müll oder einen leeren Namen im DNS ab (Abfragen ohne Domain im Pi-hole, etwa alle 22 Sekunden) und die Zeitsynchronisation war unzuverlässig. Die Namen liegen jetzt in dauerhaften Puffern.

**English**

- Fixed: the NTP server names only lived in local variables, but the SNTP service keeps just the pointer. As a result the device later asked the DNS for garbage or an empty name (queries without a domain in Pi-hole, about every 22 seconds) and time synchronisation was unreliable. The names now live in persistent buffers.

## 2026-11-05 - Version 1.4.11

**Deutsch**

- Favoriten löschen: Statt der Checkbox *Löschen freigeben* fragt jeder ✕-Knopf in der Favoritenliste einzeln nach ("Favorit ... löschen?"). Die REST-Schnittstelle bleibt unverändert.

**English**

- Deleting favorites: instead of the checkbox *Löschen freigeben*, every ✕ button in the favorites list asks individually ("Delete favorite ...?"). The REST interface is unchanged.

## 2026-11-05 - Version 1.4.10

**Deutsch**

- Der voreingestellte Sender wird nur noch dann eingetragen, wenn die Senderliste leer ist (neues Gerät); bei allen Änderungen danach wird er nicht wieder eingetragen, auch nicht beim Laden einer Liste oder nach dem Löschen. Die Listen in `stations/` enthalten ihn nicht mehr (jetzt 24 bis 29 Sender).

**English**

- The preset station is now entered only if the station list is empty (new device); with all changes after that it is not entered again, neither when a list is loaded nor after deleting. The lists in `stations/` no longer contain it (now 24 to 29 stations).

## 2026-11-05 - Version 1.4.9

**Deutsch**

- Neu im Tab *Audio* (Karte *Sprachausgabe (VoiceRSS)*): Knopf *Stimme testen*. Er spricht einen kurzen Beispielsatz in der gewählten Sprache, Stimme und mit dem eingestellten Tempo, auch ohne vorher zu speichern (der API-Schlüssel muss gespeichert sein).

**English**

- New in the *Audio* tab (card *Sprachausgabe (VoiceRSS)*): button *Stimme testen* (test voice). It speaks a short example sentence in the chosen language and voice and at the set tempo, even without saving first (the API key has to be saved).

## 2026-11-04 - Version 1.4.8

**Deutsch**

- Favoriten löschen ist abgesichert: Die ✕-Knöpfe in der Favoritenliste sind erst nach dem Haken *Löschen freigeben* bedienbar; nach jedem gelöschten Favoriten springt der Haken zurück. Die REST-Schnittstelle bleibt unverändert.
- Neu im Tab *Webradio* (Bereich *Senderlisten*): *Sender meines Landes* mit Länder- und Genre-Auswahl und dem Knopf *Von radio-browser laden*. Der Browser holt die beliebtesten Sender des Landes aus radio-browser.info (nur MP3 oder AAC, zuletzt erreichbar, höchstens 30, Namen auf 24 Byte gekürzt) und schickt sie als Senderliste an das Gerät; Die Favoriten stehen danach vorn.
- Stumm: Wird stumm geschaltet, während ein Webradio noch lädt, oder läuft gerade Sprache oder eine Flash-MP3, gilt der Zustand sofort; vorher blendete das Radio danach unnötig hörbar ein oder aus.
- Beispiele für openHAB (Schalter *Stumm*) und Node-RED (Knopf *Stumm umschalten*) ergänzt; in der README steht für `…/volume` jetzt der Bereich 0–100.

**English**

- Deleting favorites is protected: the ✕ buttons in the favorites list only work after ticking *Löschen freigeben* (allow delete); after every deleted favorite the checkbox jumps back. The REST interface is unchanged.
- New in the *Webradio* tab (section *Senderlisten*): *Sender meines Landes* (stations of my country) with a country and genre selection and the button *Von radio-browser laden*. The browser fetches the most popular stations of the country from radio-browser.info (only MP3 or AAC, reachable last time, at most 30, names shortened to 24 bytes) and sends them to the device as a station list; The favorites are at the front afterwards.
- Mute: if mute is switched while a web radio is still loading, or speech or a flash MP3 is playing, the state applies at once; before, the radio faded in or out audibly afterwards without need.
- Examples for openHAB (switch *Stumm*) and Node-RED (button *Stumm umschalten*) added; the README now gives the range 0–100 for `…/volume`.

## 2026-11-04 - Version 1.4.7

**Deutsch**

- Neu: MP3-Dateien im Gerät (Tab *MP3 (Flash)*) lassen sich umbenennen: Knopf ✎ in der Dateiliste, REST `POST /api/rename` (`file`, `to`; ".mp3" wird bei Bedarf angehängt). Pins, die diese Datei abspielen, folgen dem neuen Namen; läuft die Datei gerade, wird sie gestoppt.
- Geändert: **Stumm** wirkt jetzt nur noch auf Webradio und MP3 von der SD-Karte (auch als Mischspur über dem Radio). Ansagen (Sprache) und MP3-Dateien aus dem Flash bleiben bei Stumm hörbar, z. B. ein Klingelton, während das Radio wegen eines Anrufs stumm ist. Vorher wirkte Stumm als letzte Verstärkung auf alles.

**English**

- New: MP3 files in the device (tab *MP3 (Flash)*) can be renamed: button ✎ in the file list, REST `POST /api/rename` (`file`, `to`; ".mp3" is appended if missing). Pins that play this file follow the new name; if the file is playing it is stopped.
- Changed: **Mute** now acts only on web radio and MP3 from the SD card (also as a mix track over the radio). Announcements (speech) and MP3 files from the flash stay audible while muted, e.g. a ring tone while the radio is muted because of a phone call. Before, mute acted as a last gain on everything.

## 2026-11-04 - Version 1.4.6

**Deutsch**

- Behoben: Das MQTT-Thema `<Basis>/mute` wurde beim Verbinden nicht abonniert, Stumm-Befehle per MQTT (und der Schalter in Home Assistant oder openHAB) blieben wirkungslos; REST `/api/mute` und die Tasten in der Oberfläche funktionierten schon.

**English**

- Fixed: the MQTT topic `<base>/mute` was not subscribed when connecting, so mute commands via MQTT (and the switch in Home Assistant or openHAB) had no effect; REST `/api/mute` and the buttons in the web UI already worked.

## 2026-11-04 - Version 1.4.5

**Deutsch**

- Neu: Stumm-Taste. *Stopp* und *Stumm* stehen jetzt hinter dem Lautstärkeregler ganz oben in den Tabs *MP3 (Flash)*, *Sprechen*, *SD-Karte* und *Webradio* (die Knöpfe in den Zeilen *Läuft gerade*, *Sprechen* und *URL abspielen* entfallen). *Stumm* blendet den Ton sanft auf 0 aus und wieder ein (Dauer: die Lautstärke-Rampe, mindestens 300 ms); die eingestellte Lautstärke bleibt unverändert. REST `/api/mute` (`on=1|0`, `toggle=1`, ohne Angabe nur Zustand), MQTT `<Basis>/mute` (`on`, `off`, `toggle`) mit Zustand in `<Basis>/muted`, `muted` in `/api/status` und `/api/volume`, Schalter *Stumm* in Home Assistant.
- Die Favoriten werden per MQTT gemeldet: `<Basis>/favorites` (retained, JSON `{"max":40,"favorites":[{"n":1,"name":"…","url":"…"}]}`), beim Verbinden und nach jeder Änderung der Liste; eine Anfrage an `<Basis>/list` sendet Senderliste und Favoriten erneut. Ein Favorit lässt sich mit seiner URL über `<Basis>/play` abspielen. Damit können Hausautomationen (z. B. openHAB) die Favoriten anzeigen.

**English**

- New: mute button. *Stopp* and *Stumm* are now behind the volume slider at the very top of the tabs *MP3 (Flash)*, *Sprechen*, *SD-Karte* and *Webradio* (the buttons in the rows *Läuft gerade*, *Sprechen* and *URL abspielen* are gone). *Stumm* fades the sound out to 0 gently and back in (duration: the volume ramp, at least 300 ms); the set volume stays unchanged. REST `/api/mute` (`on=1|0`, `toggle=1`, without a parameter only the state), MQTT `<base>/mute` (`on`, `off`, `toggle`) with the state in `<base>/muted`, `muted` in `/api/status` and `/api/volume`, switch *Stumm* in Home Assistant.
- The favorites are reported via MQTT: `<base>/favorites` (retained, JSON `{"max":40,"favorites":[{"n":1,"name":"…","url":"…"}]}`), when connecting and after every change of the list; a request to `<base>/list` sends the station list and the favorites again. A favorite can be played with its URL via `<base>/play`. Home automations (e.g. openHAB) can show the favorites this way.

## 2026-11-01 - Version 1.4.4

**Deutsch**

- Der Ton beim Start spielt immer mit Lautstärke 50, unabhängig von der allgemeinen Lautstärke (auch bei Lautstärke 0).
- Favoriten gingen nach einem Neustart verloren, weil der knappe NVS-Speicher der Einstellungen voll war; sie liegen jetzt in einer Datei im Dateisystem (`/favorites.dat`), Favoriten einer älteren Firmware werden beim ersten Start übernommen. `/api/status` meldet `nvsUsed` und `nvsFree` (Einträge im NVS).
- Neu im Tab *Audio*: *Webradio-Lautstärke angleichen* (Standard: aus) mit *Zielpegel*; das Gerät führt die Verstärkung des Webradios langsam nach, damit laute und leise Sender ähnlich klingen. `/api/status` meldet `agcDb`; Export und Import kennen `agc` und `agcdb`.
- Neu im Tab *Webradio*: eine Favoritenliste (bis zu 40 Sender) (anlegen mit dem Knopf *+* in der Senderliste), Anhören, Entfernen und *Als Senderliste übernehmen*. REST `/api/favorites`, `/api/favoriteadd`, `/api/favoritedelete`, `/api/favoritestolist`. Der gerade laufende Sender ist in der Favoritenliste mit ♪ und fett markiert. Die Favoriten stehen im Export der Einstellungen und lassen sich mit *Favoriten speichern* / *Favoriten laden* als eigene Datei sichern (`/favorites.txt`, `POST /importfavorites`).
- Favoriten stehen nach dem Laden einer Senderliste (Datei oder GitHub) vorn in der Senderliste: erst die Favoriten, dann die Sender der Liste ohne Doppelte. In der Senderliste hat jeder Platz einen Knopf *+*, der den Sender zu den Favoriten legt.
- Jeder Platz der Senderliste und jeder Favorit hat einen Knopf *API*, der den Aufruf per REST (`/api/station?n=Platz` bzw. `?name=`, bei Favoriten `/api/play`) und per MQTT (Thema `<Basis>/station` mit Platznummer oder Name, bei Favoriten `<Basis>/play` mit der URL) anzeigt und kopierbar macht; er ersetzt den Knopf *URL*.

**English**

- The start tone always plays at volume 50, regardless of the general volume (even at volume 0).
- Favorites were lost after a restart because the scarce NVS memory of the settings was full; they now live in a file in the file system (`/favorites.dat`), favorites of an older firmware are taken over at the first start. `/api/status` reports `nvsUsed` and `nvsFree` (entries in the NVS).
- New in the *Audio* tab: *Match web radio volume* (default: off) with *target level*; the device slowly follows the gain of the web radio so loud and quiet stations sound alike. `/api/status` reports `agcDb`; export and import know `agc` and `agcdb`.
- New in the *Webradio* tab: a favorites list (up to 40 stations) (add with the *+* button in the station list), listening, removing and *Als Senderliste übernehmen* (use as station list). REST `/api/favorites`, `/api/favoriteadd`, `/api/favoritedelete`, `/api/favoritestolist`. The station that is playing right now is marked with ♪ and bold in the favorites list. The favorites are part of the settings export and can be saved / loaded as a file of their own with *Favoriten speichern* / *Favoriten laden* (`/favorites.txt`, `POST /importfavorites`).
- After a station list (file or GitHub) is loaded the favorites are at the front of the station list: first the favorites, then the stations of the list without duplicates. Every slot in the station list has a *+* button that puts the station into the favorites.
- Every slot of the station list and every favorite has an *API* button that shows the call via REST (`/api/station?n=slot` or `?name=`, for favorites `/api/play`) and via MQTT (topic `<base>/station` with slot number or name, for favorites `<base>/play` with the URL) and makes it copyable; it replaces the *URL* button.

## 2026-11-01 - Version 1.4.3

**Deutsch**

- AAC-Aussetzer bei geöffneter Weboberfläche behoben: Die Audio-Bibliothek läuft jetzt auch zwischen den Teilen der Webseite, in der Dateiliste und in der Senderliste; die Belegung von LittleFS und SD-Karte wird nur alle 15 s neu gelesen (und nach Löschen oder Hochladen), weil `usedBytes()` die Schleife bis zu mehrere Hundert Millisekunden anhält. `/api/status` meldet zusätzlich `decErr` (Dekodierfehler).
- Nach dem Laden einer Senderliste (Datei oder GitHub) bleibt die Seite im Tab *Webradio*.
- Der Lautstärkeregler steht ganz oben in den Tabs *MP3*, *Sprechen*, *SD-Karte* und *Webradio*; alle vier zeigen denselben Wert.
- Die Senderlisten in `stations/` haben jetzt je mehr als 20 Sender. Neue Listen nach Genre (`schlager`, `country`, `folk`, `jazz`, `klassik`, `pop-charts`, `jahrzehnte`, `dance`, `hiphop`) und Land (`irland`, `usa`, `australien`, `grossbritannien`, `frankreich`).
- Die Auswahl *Fertige Liste* im Tab *Webradio* kommt aus `stations/index.txt` auf GitHub (vom Browser geladen): Neue Listen erscheinen ohne neues Flashen. Ohne Internet im Browser bleiben die ersten vier Listen.

**English**

- Fixed AAC dropouts while the web interface is open: the audio library now also runs between the parts of the web page, in the file list and in the station list; the usage of LittleFS and the SD card is re-read only every 15 s (and after deleting or uploading), because `usedBytes()` holds up the loop for up to several hundred milliseconds. `/api/status` also reports `decErr` (decoder errors).
- After a station list is loaded (file or GitHub) the page stays on the *Webradio* tab.
- The volume slider is at the very top of the tabs *MP3*, *Sprechen*, *SD-Karte* and *Webradio*; all four show the same value.
- The station lists in `stations/` now have more than 20 stations each. New lists by genre (`schlager`, `country`, `folk`, `jazz`, `klassik`, `pop-charts`, `jahrzehnte`, `dance`, `hiphop`) and country (`irland`, `usa`, `australien`, `grossbritannien`, `frankreich`).
- The selection *Fertige Liste* in the *Webradio* tab comes from `stations/index.txt` on GitHub (loaded by the browser): new lists appear without flashing again. Without internet in the browser the first four lists remain.

## 2026-10-31 - Version 1.4.2

**Deutsch**

- Tab *Webradio*: Die Listenknöpfe stehen jetzt in einem eigenen Abschnitt *Senderlisten* mit den Zeilen *Eigene Liste* (speichern, laden) und *Fertige Liste* (Auswahl und *Von GitHub laden*).
- AAC-Sender stockten etwas: Die Firmware wird jetzt auf Geschwindigkeit statt auf Größe übersetzt (`-O2`), und die Hauptschleife ruft die Audio-Bibliothek zweimal je Durchlauf auf, damit der Ausgabepuffer nach einem Webzugriff (40 bis 60 ms) gleich wieder gefüllt wird. `/api/status` meldet dazu `audioLoopMs`, `loopMs`, `bufKb` und `bufMinKb` (längste Zeit von `audio->loop()` und der Schleife in den letzten 5 s, Füllstand des Eingangspuffers).

**English**

- *Webradio* tab: the list buttons are now in their own section *Senderlisten* (station lists) with the rows *Eigene Liste* (own list: save, load) and *Fertige Liste* (ready-made list: selection and *Von GitHub laden*).
- AAC stations stuttered a little: the firmware is now compiled for speed instead of size (`-O2`), and the main loop calls the audio library twice per pass so that the output buffer is refilled right after a web request (40 to 60 ms). `/api/status` now reports `audioLoopMs`, `loopMs`, `bufKb` and `bufMinKb` (longest time of `audio->loop()` and of the loop in the last 5 s, fill level of the input buffer).

## 2026-10-31 - Version 1.4.1

**Deutsch**

- Fertige Senderlisten im Ordner `stations/`: `mp3-auswahl` (die bisherigen 30 Sender), `aac-auswahl` (15 AAC/HE-AAC-Sender), `rock` und `entspannung`. Im Tab *Webradio* lädt *Liste von GitHub laden* eine davon (REST `POST /api/stationlist` mit `list=`); das ersetzt die gespeicherte Liste.

**English**

- Ready-made station lists in the folder `stations/`: `mp3-auswahl` (the former 30 stations), `aac-auswahl` (15 AAC/HE-AAC stations), `rock` and `entspannung`. In the *Webradio* tab *Liste von GitHub laden* (load list from GitHub) loads one of them (REST `POST /api/stationlist` with `list=`); this replaces the stored list.

## 2026-10-31 - Version 1.4.0

**Deutsch**

- **Achtung beim Update per USB:** Die App-Partition ist von 2 auf 3 MB gewachsen (Schema *Huge APP*), das Dateisystem von 1,9 auf 0,9 MB geschrumpft. Beim ersten Flashen werden **MP3-Dateien im Flash und die Sprachdatei `en.json` gelöscht**; danach neu hochladen (MQTT-, WLAN- und andere Einstellungen bleiben). Die SD-Karte ist nicht betroffen.
- AAC ist wieder da, auch HE-AAC/AAC+ (SBR und PS): Webradios in AAC spielen jetzt, zum Beispiel die lokalen Nostalgie-Sender und bigFM.
- Home Assistant: Im Tab *MQTT* schaltet *Home Assistant Discovery* (REST `ha=1`) die automatische Anmeldung per MQTT-Discovery ein. Status, Titel, Lautstärke, Ansage, Stopp und Senderauswahl erscheinen als Entitäten des Geräts.
- Beispiele für Node-RED (`docs/integration/node-red-flow.json`) und openHAB (`docs/integration/openhab/`).
- Uhrzeit: Liefert der SNTP-Dienst des Stacks 25 s nach dem Verbinden keine Zeit (in einem Netz kam sie gar nicht), fragt das Gerät alle 15 s einen der eingetragenen NTP-Server direkt per UDP ab und stellt die Uhr selbst.

**English**

- **Attention when updating via USB:** the app partition grew from 2 to 3 MB (scheme *Huge APP*), the file system shrank from 1.9 to 0.9 MB. On the first flash the **MP3 files in the flash and the language file `en.json` are deleted**; upload them again afterwards (MQTT, WiFi and other settings stay). The SD card is not affected.
- AAC is back, including HE-AAC/AAC+ (SBR and PS): web radios in AAC now play, for example the local Nostalgie stations and bigFM.
- Home Assistant: in the *MQTT* tab *Home Assistant Discovery* (REST `ha=1`) switches on the automatic registration via MQTT discovery. Status, title, volume, announcement, stop and station selection appear as entities of the device.
- Examples for Node-RED (`docs/integration/node-red-flow.json`) and openHAB (`docs/integration/openhab/`).
- Clock: if the SNTP service of the stack delivers no time 25 s after connecting (in one network it never came), the device queries one of the entered NTP servers directly via UDP every 15 s and sets the clock itself.

## 2026-10-30 - Version 1.3.9

**Deutsch**

- Der Opus-Dekoder ist ausgebaut: Die Firmware wird um rund 160 KB kleiner (1,93 statt 2,09 MB) und lässt wieder Platz für Neues. Webradios und Dateien im Opus-Format spielen nicht mehr; MP3 und Vorbis laufen wie bisher.
- Zwei Mischspuren: Läuft eine SD-Datei über dem Radio, kommt eine Flash-MP3 oder ein Text auf eine zweite Spur darüber. SD-Datei und Radio werden abgesenkt und spielen danach weiter; die SD-Datei wird nicht mehr durch die Ansage ersetzt.
- Die Tabs stehen in der Reihenfolge der Rangfolge: MP3 (Flash), Sprechen, SD-Karte, Webradio, danach die übrigen. Beim Öffnen der Seite ist der erste Tab, MP3 (Flash), aktiv.

**English**

- The Opus decoder is removed: the firmware gets about 160 KB smaller (1.93 instead of 2.09 MB) and leaves room for new features again. Web radios and files in Opus format no longer play; MP3 and Vorbis work as before.
- Two mix tracks: if an SD file runs over the radio, a flash MP3 or a text goes onto a second track above it. SD file and radio are lowered and continue afterwards; the SD file is no longer replaced by the announcement.
- The tabs follow the playback priority: MP3 (Flash), Sprechen, SD-Karte, Webradio, then the others. When the page opens, the first tab, MP3 (Flash), is active.

## 2026-10-30 - Version 1.3.8

**Deutsch**

- Rangfolge der Wiedergabe von hoch nach niedrig: 1. MP3 aus dem Flash, 2. Sprechen, 3. MP3 von der SD-Karte, 4. Webradio. Flash-MP3 und Sprechen spielen nacheinander in der Reihenfolge des Aufrufs und senken SD-Datei und Radio ab; ein Text springt nicht mehr vor eine Flash-MP3, die allein läuft. Läuft eine SD-Datei als Mischspur über dem Radio, ersetzt eine Flash-MP3 oder ein Text diese Spur (kurz ausgeblendet), das Radio bleibt abgesenkt und kehrt danach zurück.
- Absturz behoben: Der erste Namensabruf nach dem Start (zum Beispiel beim ersten Senderstart) konnte das Gerät mit einem Fehler in `sys_untimeout` neu starten, wenn gerade die Zeitabfrage lief. Jetzt wird vor der Zeitabfrage einmal abgerufen.

**English**

- Playback priority from high to low: 1. MP3 from the flash, 2. speech, 3. MP3 from the SD card, 4. web radio. Flash MP3 and speech play one after the other in the order of the calls and lower the SD file and the radio; a text no longer jumps ahead of a flash MP3 that plays alone. If an SD file runs as a mix layer over the radio, a flash MP3 or a text replaces that layer (faded out briefly), the radio stays lowered and returns afterwards.
- Crash fixed: the first name lookup after the start (for example the first station start) could restart the device with an error in `sys_untimeout` if the time query was running at that moment. Now one lookup is done before the time query.

## 2026-10-30 - Version 1.3.7

**Deutsch**

- Webradio: bis zu 30 statt 15 gespeicherte Plätze (Tab *Webradio*, REST `/api/station`, MQTT `…/station`, Eingänge). Bereits gespeicherte Plätze bleiben erhalten; der MQTT-Puffer ist für die längere Senderliste auf 8 KB gewachsen.
- Senderliste sichern und laden: Im Tab *Webradio* speichern *Liste speichern* und *Liste laden* die Liste als Textdatei (`/stations.txt`, `POST /importstations`); das Laden ersetzt die ganze Liste.
- Eine MP3-Datei aus dem Flash, die während einer Datei der SD-Karte aufgerufen wird, startet sofort: Die SD-Datei wird abgesenkt (wie bei einer Ansage), die Flash-Datei läuft darüber und danach wird die SD-Datei wieder aufgeblendet. Bisher wartete sie, bis die SD-Datei zu Ende war. Auch beim Sprechen sinkt das Radio oder die Datei jetzt schon beim Aufruf und nicht erst, wenn der Text geladen ist; die Ansage ist dadurch früher zu hören.
- Dateisuche: Ein Dateiname ohne `sd:` (REST und MQTT) wird zuerst im Flash gesucht, dann auf der SD-Karte (Pfad ab Wurzel).

**English**

- Web radio: up to 30 instead of 15 stored slots (*Webradio* tab, REST `/api/station`, MQTT `…/station`, inputs). Already stored slots are kept; the MQTT buffer grew to 8 KB for the longer station list.
- Saving and loading the station list: in the *Webradio* tab *Liste speichern* (save list) and *Liste laden* (load list) store the list as a text file (`/stations.txt`, `POST /importstations`); loading replaces the whole list.
- An MP3 file from the flash called while a file of the SD card is playing starts right away: the SD file is lowered (like for an announcement), the flash file plays over it and afterwards the SD file is faded back up. Before, it waited until the SD file had ended. Speaking works the same way: the radio or file is lowered when the call comes in, not only when the text has been loaded, so the announcement is heard earlier.
- File lookup: a file name without `sd:` (REST and MQTT) is looked up in the flash first and then on the SD card (path from the root).

## 2026-10-30 - Version 1.3.6

**Deutsch**

- MQTT: bis zu 5 zusätzliche Abos (Gruppen-Topics) im Tab *MQTT*, Standard `netspeaker/all`, immer ein leeres Feld sichtbar. Das Gerät nimmt unter `<Topic>/#` dieselben Befehle an wie unter dem Basis-Topic (`say`, `play`, `url`, `file`, `station`, `list`, `stop`, `volume`, `restart`), so erreicht ein Befehl mehrere Geräte. Export und Import der Einstellungen enthalten die Felder (`mq_g1` bis `mq_g5`); per REST setzt `/api/mqtt` sie mit `group1` bis `group5` und liefert sie als `groups`. Doku-Seite, README und `en.json` sind ergänzt.
- Sprachdatei von GitHub laden: Das Eingabefeld ist mit `en.json` vorbelegt und breiter; ein angehängtes `.json` wird vor dem Laden entfernt.
- Das Repository-ZIP enthält die Firmware in `build_netspeaker/esp32s3/`; das Werkzeug-ZIP enthält den Lizenztext von `esptool`.

**English**

- MQTT: up to 5 additional subscriptions (group topics) in the *MQTT* tab, default `netspeaker/all`, one empty field always shown. Under `<topic>/#` the device accepts the same commands as under the base topic (`say`, `play`, `url`, `file`, `station`, `list`, `stop`, `volume`, `restart`), so one command reaches several devices. Export and import of the settings contain the fields (`mq_g1` to `mq_g5`); via REST `/api/mqtt` sets them with `group1` to `group5` and returns them as `groups`. Documentation page, README and `en.json` are updated.
- Loading a language file from GitHub: the input field is prefilled with `en.json` and wider; a trailing `.json` is removed before loading.
- The repository ZIP contains the firmware in `build_netspeaker/esp32s3/`; the tools ZIP contains the license text of `esptool`.

## 2026-10-30 - Version 1.3.5

**Deutsch**

- Das ZIP des Repositorys reicht zum Flashen: Fehlt `esptool.exe` (keine Arduino IDE), lädt `voicesetup.ps1` es aus `netspeaker_flash.zip` des neuesten Releases (SHA-256 geprüft, neu: `netspeaker_flash.sha256`) und legt es neben das Skript. Das Repository-ZIP enthält jetzt auch die Firmware in `build_netspeaker/esp32s3/` (ohne `merged.bin`, die liegt am Release). `netspeaker_flash.zip` enthält zusätzlich den Lizenztext von `esptool` (`esptool-LICENSE.txt`, GPL-2.0+); die README ist angepasst. Die Firmware ist unverändert.
- `build_netspeaker/cleanup_history.ps1` entfernt die Firmware nach einem neuen Build aus allen älteren Commits (nur der neueste Commit behält sie), damit das Repository nicht um ~2 MB je Version wächst.

**English**

- The ZIP of the repository is enough for flashing: if `esptool.exe` is missing (no Arduino IDE), `voicesetup.ps1` downloads it from `netspeaker_flash.zip` of the newest release (SHA-256 checked, new: `netspeaker_flash.sha256`) and puts it next to the script. The repository ZIP now also contains the firmware in `build_netspeaker/esp32s3/` (without `merged.bin`, which is attached to the release). `netspeaker_flash.zip` additionally contains the `esptool` license text (`esptool-LICENSE.txt`, GPL-2.0+); the README is adjusted. The firmware is unchanged.
- `build_netspeaker/cleanup_history.ps1` removes the firmware from all older commits after a new build (only the newest commit keeps it), so the repository does not grow by ~2 MB per version.

## 2026-10-30 - Version 1.3.4

**Deutsch**

- Flash-Werkzeuge wie bei der Uhr: `flashESP.bat` und `voicesetup.ps1` liegen jetzt im Ordner `build_netspeaker/` des Repositorys (nur die Werkzeuge, die Binärdateien bleiben ausgeschlossen). Fehlt ein lokaler Build, lädt `flashESP.bat` das Paket `netspeaker-esp32s3.zip` vom neuesten Release und prüft die SHA-256-Summe. Neu: `publish_builds.ps1` erzeugt die Pakete (`netspeaker-esp32s3.zip`, `.sha256` und `netspeaker_flash.zip` mit `esptool.exe`) und lädt sie mit `-Upload` ins Release. Neuer README-Abschnitt *Fertige Firmware flashen*. Die Firmware ist unverändert.

**English**

- Flash tools as with the clock: `flashESP.bat` and `voicesetup.ps1` now live in the folder `build_netspeaker/` of the repository (only the tools, the binaries stay excluded). Without a local build `flashESP.bat` downloads the package `netspeaker-esp32s3.zip` from the newest release and checks the SHA-256 sum. New: `publish_builds.ps1` creates the packages (`netspeaker-esp32s3.zip`, `.sha256` and `netspeaker_flash.zip` with `esptool.exe`) and uploads them to the release with `-Upload`. New README section *Flashing the finished firmware*. The firmware is unchanged.

## 2026-10-30 - Version 1.3.3

**Deutsch**

- `flashAll.bat` fragt nach dem Flashen eines Geräts am USB auch das WLAN ab (Netze zur Auswahl, WLAN des PCs mit gespeichertem Passwort zum Übernehmen), wie bisher nur `flashESP.bat`; mit `-Yes` entfällt die Frage. Die README beschreibt die WLAN-Einrichtung beim Flashen. Die Firmware ist unverändert.

**English**

- `flashAll.bat` now also asks for the WiFi after flashing a device on USB (networks to choose from, the WiFi of the PC with its stored password to take over), as only `flashESP.bat` did before; with `-Yes` the question is skipped. The README describes setting up the WiFi while flashing. The firmware is unchanged.

## 2026-10-30 - Version 1.3.2

**Deutsch**

- Tab *Sprechen*: Was gerade läuft (Sender oder Datei, mit Fortschrittsbalken und Stopp-Knopf) steht jetzt oben wie in den anderen Tabs.
- Tab *Zeit*: Bis zu 5 NTP-Server; es wird immer ein leeres Feld mit angezeigt. Das Gerät fragt die ersten drei belegten und wechselt nach 45 s ohne Zeit zu den weiteren. Export und Import enthalten `ntp1` bis `ntp5`.
- Die Tabs *SD-Karte* und *MP3 (Flash)* zeigen den belegten Speicher einheitlich oben unter der Überschrift: „Belegt X von Y (Z %)“ mit einem Balken.
- Sprachdateien lassen sich vom Projekt auf GitHub laden (Karte *Sprache / Language* im Tab *Status*, Knopf *Von GitHub laden*; `fetch=en` bei `/api/lang`). Die Adresse ist fest, nur der Sprachcode kommt von außen. Übersetzte HTML-Teile werden im Browser auf Hervorhebungen (`code`, `em`, `strong`, `b`, `kbd`) beschränkt.
- Screenshots der Weboberfläche im Ordner `docs/screenshots/` und in der README. Die englische Sprachdatei übersetzt jetzt auch die Zeilen der Stream-Info (Station, Title, Description, Sample rate, Channels …).

**English**

- *Sprechen* tab: what is playing right now (station or file, with progress bar and stop button) is now shown at the top like in the other tabs.
- *Zeit* tab: up to 5 NTP servers; one empty field is always shown. The device asks the first three used ones and switches to the others after 45 s without time. Export and import contain `ntp1` to `ntp5`.
- The *SD-Karte* and *MP3 (Flash)* tabs show the used memory in the same way at the top under the heading: "Belegt X von Y (Z %)" with a bar.
- Language files can be loaded from the project on GitHub (card *Sprache / Language* in the *Status* tab, button *Von GitHub laden*; `fetch=en` at `/api/lang`). The address is fixed, only the language code comes from outside. Translated HTML parts are limited in the browser to emphasis tags (`code`, `em`, `strong`, `b`, `kbd`).
- Screenshots of the web interface in the folder `docs/screenshots/` and in the README. The English language file now also translates the rows of the stream info (Station, Title, Description, Sample rate, Channels …).

## 2026-10-30 - Version 1.3.1

**Deutsch**

- Das Schreiben des Logs in die Datei schaltet sich nach einer einstellbaren Zeit selbst aus (Tab *Log*, Standard 60 Minuten, 0 = nie), damit der Flash geschont wird. Die Zeit läuft ab dem Einschalten oder ab dem Start des Geräts; im Log steht eine Zeile `[LOG] … switched off automatically`.
- MQTT: Im Tab *MQTT* lassen sich optional Benutzer und Passwort für den Broker eintragen; leer = ohne Anmeldung. Das Passwort wird nicht angezeigt, nicht exportiert und nie über die API ausgegeben; ein leeres Feld behält das gespeicherte. `/api/mqtt` nimmt optional `user` und `pass`.
- Tab *Eingänge*: „GPIO 47“ und der Zustand werden nicht mehr umgebrochen.
- GPIO 33-37 gelten als freie Pins (Tab *Audio*, Tab *Eingänge*), weil der ESP32-S3FH4R2 Quad-PSRAM hat und diese Pins nur bei Octal-PSRAM belegt sind. Welche Pins das Board herausführt, hängt vom Board ab.
- Tab *Eingänge*: Als Aktion lässt sich auch ein gespeicherter Webradio-Sender wählen (Auswahl der gespeicherten Sender, Name oder Platznummer); `type=station` in `/api/pins`.
- Tab *MQTT* kompakter: Broker und Port stehen in einer Zeile, Benutzer und Passwort in der nächsten.
- Doku ergänzt und berichtigt: Die Lautstärke geht überall von 0 bis 100 (statt 0-21); neu sind die Karten *Eingänge (Pins)* und *Sprachen*, die Felder von `/api/status` (Fortschritt, Stream-Info, `gainDb`) und die JSON-Formen von MQTT `/url` und `/file`.

**English**

- Writing the log to the file switches itself off after an adjustable time (*Log* tab, default 60 minutes, 0 = never) to spare the flash. The time runs from switching on or from the start of the device; the log gets a line `[LOG] … switched off automatically`.
- MQTT: in the *MQTT* tab a user and password for the broker can optionally be entered; empty = no login. The password is not shown, not exported and never output by the API; an empty field keeps the saved one. `/api/mqtt` optionally takes `user` and `pass`.
- *Eingänge* tab: "GPIO 47" and the state are no longer wrapped.
- GPIO 33-37 count as free pins (*Audio* tab, *Eingänge* tab), because the ESP32-S3FH4R2 has quad PSRAM and these pins are only taken with octal PSRAM. Which pins the board brings out depends on the board.
- *Eingänge* tab: a saved web radio station can now also be chosen as the action (list of the saved stations, name or slot number); `type=station` in `/api/pins`.
- *MQTT* tab more compact: broker and port are in one line, user and password in the next.
- Docs completed and corrected: the volume goes from 0 to 100 everywhere (instead of 0-21); new are the cards *Eingänge (Pins)* and *Sprachen*, the fields of `/api/status` (progress, stream info, `gainDb`) and the JSON forms of MQTT `/url` and `/file`.

## 2026-10-29 - Version 1.3.0

**Deutsch**

- Die Weboberfläche lässt sich in weiteren Sprachen anzeigen. Eine Sprachdatei (`lang/en.json` für Englisch) wird im Tab *Status* in der Karte *Sprache / Language* hochgeladen, liegt im Speicher des Geräts und wird im Browser angewendet; in der Statuszeile wechselt ein Knopf (EN/DE) die Sprache. Die Firmware wird dafür nur um wenige KB größer, die Übersetzung selbst braucht keinen Platz in der App-Partition. Anleitung und Prüfwerkzeug für fehlende Übersetzungen: `lang/README.md`.
- Nicht eingestellte Pins (alle zugelassenen außer Verstärker, SD-Karte, Strapping-Pins und Status-LED) bekommen einen Pull-up (High), damit offene Pins nicht schweben.
- Neuer Tab *Eingänge*: Je freiem Pin lässt sich eine Aktion festlegen; bei einer MP3-Datei bietet eine Auswahl die Dateien im Flash und auf der SD-Karte an. Bekommt der Pin Kontakt nach GND (zum Beispiel durch eine Taste), spielt das Gerät eine Ansage (VoiceRSS) oder eine MP3-Datei, einen Ordner der SD-Karte oder eine URL. REST: `/api/pins`.
- Der Fortschrittsbalken unter dem Namen wird bei Webradio ausgeblendet, weil ein Stream keine Länge hat.
- Im Tab *Sprechen* steht neben dem Lautstärkeregler der Wert (zum Beispiel 60 / 100); er folgt dem Regler und der tatsächlichen Lautstärke.
- Tab *Status*: Die SD-Karte zeigt jetzt Zustand, Größe, belegt (mit Prozent), frei, ob sie eingeschaltet ist und die vier Pins (CS, SCK, MOSI, MISO).

**English**

- The web interface can be shown in further languages. A language file (`lang/en.json` for English) is uploaded in the *Status* tab, in the card *Sprache / Language*, is stored in the memory of the device and applied in the browser; a button (EN/DE) in the status bar switches the language. The firmware only grows by a few KB, the translation itself needs no space in the app partition. Instructions and a tool for finding missing translations: `lang/README.md`.
- Pins that are not configured (all allowed ones except amplifier, SD card, strapping pins and status LED) get a pull-up (high) so that open pins do not float.
- New tab *Eingänge*: an action can be set per free pin; for an MP3 file a list offers the files in flash and on the SD card. When the pin gets contact to GND (for example through a button), the device plays an announcement (VoiceRSS) or an MP3 file, a folder of the SD card or a URL. REST: `/api/pins`.
- The progress bar under the name is hidden for web radio, because a stream has no length.
- In the *Sprechen* tab the value is shown next to the volume slider (for example 60 / 100); it follows the slider and the actual volume.
- *Status* tab: the SD card now shows state, size, used (with percent), free, whether it is enabled and the four pins (CS, SCK, MOSI, MISO).

## 2026-10-29 - Version 1.2.1

**Deutsch**

- Der Titel eines Webradios wird erst angezeigt (und für die Titelregel gemeldet), wenn die dazu gehörende Musik zu hören ist: Er wird um die Dauer des gepufferten Tons verzögert. Im Log steht bei jedem neuen Titel die Verzögerung (`[TITLE] ... shown in ... ms`).
- Titelregel: Mit *höchstens … s* im Tab *Audio* endet die angehobene Lautstärke nach einer festen Zeit (zum Beispiel 210 s), weil ein Sender das Ende eines Titels nicht meldet und Werbung danach sonst laut bleibt. 0 = bis zum nächsten Titel (Standard).
- Der Tab *MP3* heißt jetzt *MP3 (Flash)*, zur Abgrenzung von der SD-Karte. In der Statuszeile steht als Marke jetzt *SPEAKER* statt *VOICE*.
- *Stream-Info* zeigt zusätzlich Codec, Abtastrate und Kanäle; sie stehen auch im Status als `codec`, `rate`, `ch` und `bits`.
- Kurzer Ton („buub“) beim Start in der eingestellten Lautstärke; nach einem Neustart per MQTT, nach eigenen Neustarts des Geräts (WLAN lange weg, Speicher knapp), nach einem Absturz und im abgesicherten Modus bleibt er aus. Haken *Kurzer Ton beim Start* im Tab *Audio* (Standard: an).

**English**

- The title of a web radio is only shown (and passed to the title rule) when the matching music is audible: it is delayed by the duration of the buffered sound. The log shows the delay for every new title (`[TITLE] ... shown in ... ms`).
- Title rule: with *höchstens … s* in the *Audio* tab the raised volume ends after a fixed time (for example 210 s), because a station does not report the end of a title and ads after it would otherwise stay loud. 0 = until the next title (default).
- The tab *MP3* is now called *MP3 (Flash)*, to tell it apart from the SD card. The brand in the status bar is now *SPEAKER* instead of *VOICE*.
- *Stream-Info* additionally shows codec, sample rate and channels; they are also in the status as `codec`, `rate`, `ch` and `bits`.
- Short tone ("buub") at the start at the set volume; it stays off after a restart via MQTT, after restarts the device triggers itself (WiFi lost for long, low memory), after a crash and in safe mode. Checkbox *Kurzer Ton beim Start* in the *Audio* tab (default: on).

## 2026-10-29 - Version 1.2.0

**Deutsch**

- Eine Ansage stoppt eine laufende MP3-Datei (auch aus einem Ordner der SD-Karte) nicht mehr, sondern wird leise darübergemischt; die Datei läuft abgesenkt weiter. Voraussetzung ist der Haken *Radio unter Ansagen weiterlaufen lassen* im Tab *Audio*. Mehrere Ansagen laufen nacheinander und kommen vor den wartenden Dateien dran.
- Bei laufender MP3-Datei zeigt die Oberfläche unter dem Namen einen Fortschrittsbalken (Position und Länge in der Statusabfrage: `pos`, `dur` in Sekunden). Zufall und Ordner-Knopf gibt es nun auch im Hauptverzeichnis der SD-Karte.
- MP3-Dateien werden beim Start ein- und am Ende ausgeblendet (Dauer: *Radio aus-/einblenden*); Ansagen werden nie ein- oder ausgeblendet.
- MP3-Dateien werden in der Lautstärke angeglichen: Beim ersten Abspielen misst das Gerät im Hintergrund die Lautheit der Datei und speichert den Ausgleich (`/loudness.bin`); Ansagen und Radio bleiben unverändert. Haken *MP3-Lautstärke angleichen* im Tab *Audio* (Standard: an).
- Tab *Webradio*: aufklappbarer Bereich *Stream-Info* mit Sender, Titel, Genre, Beschreibung, Webseite, Logo-Adresse, Bitrate und Server, soweit der Sender sie liefert; die Werte stehen auch im Status.

**English**

- An announcement no longer stops a running MP3 file (including one from a folder of the SD card): it is mixed quietly over it and the file keeps playing, lowered. This needs the checkbox *Radio unter Ansagen weiterlaufen lassen* in the *Audio* tab. Several announcements play one after another and come before the waiting files.
- While an MP3 file plays, the web interface shows a progress bar under the name (position and length in the status query: `pos`, `dur` in seconds). Random and the folder button are now also available in the root of the SD card.
- MP3 files fade in at the start and out at the end (duration: *Radio aus-/einblenden*); announcements are never faded in or out.
- The volume of MP3 files is matched: on the first play the device measures the loudness of the file in the background and stores the correction (`/loudness.bin`); announcements and radio stay unchanged. Checkbox *MP3-Lautstärke angleichen* in the *Audio* tab (default: on).
- *Webradio* tab: collapsible *Stream-Info* area with station, title, genre, description, website, logo address, bitrate and server as far as the station delivers them; the values are also in the status.

## 2026-10-29 - Version 1.1.0

**Deutsch**

- Ordner der SD-Karte spielen mit `shuffle=1` in zufälliger Reihenfolge: jede Datei einmal je Sitzung, die Reihenfolge ist jedes Mal eine andere und beginnt nie mit der Datei der letzten Sitzung dieses Ordners. `loop=1` (Häkchen *Endlos*) startet danach eine neue, neu gemischte Runde ohne die zuletzt gespielte Datei am Anfang. Knopf *Zufall* im Tab *SD-Karte*, Parameter in REST und MQTT (JSON).
- Ordner werden jetzt einzeln nachgeladen statt auf einmal in die Warteschlange gelegt: es gibt keine Grenze von 8 Dateien mehr.
- Ansagen und Dateien werden nie mehr ein- oder ausgeblendet, auch nicht ohne Radio; nur das Radio blendet weiterhin aus, ein und wird abgesenkt.

**English**

- Folders of the SD card play in random order with `shuffle=1`: every file once per session, the order is different every time and never starts with the file the last session of this folder started with. `loop=1` (checkbox *Endlos*) then starts a new, reshuffled round without the file played last at the start. Button *Zufall* in the *SD-Karte* tab, parameters in REST and MQTT (JSON).
- Folders are now fed in one file at a time instead of all at once into the queue: the limit of 8 files is gone.
- Announcements and files are never faded in or out any more, not even without radio; only the radio still fades out, fades in and is ducked.

## 2026-10-28 - Version 1.0.0

**Deutsch**

- Erste Veröffentlichung als **NetSpeaker**: Netzwerk-Lautsprecher für den ESP32-S3 (4 MB Flash, 2 MB PSRAM) mit MAX98357A.
- Ansagen per VoiceRSS, Webradio, MP3-Dateien im Gerät und von der optionalen SD-Karte (mit Dateimanager).
- Ansagen und Dateien laufen in einer Warteschlange; mit Webradio werden sie über das abgesenkte Radio gemischt, ohne Radio ein- und ausgeblendet.
- Lautstärke 0-100 mit sanften Änderungen, Titelregel mit mehreren Stichworten, Autostart und Wiederherstellen des letzten Zustands.
- Weboberfläche (Tabs Sprechen, Webradio, SD-Karte, MP3, Audio, MQTT, WLAN, Zeit, Status, Log, Doku) mit ``-Hinweisen und Verkabelungsplan, HTTP-API und MQTT.
- Export und Import der Einstellungen ohne WLAN-Passwörter und ohne API-Schlüssel; die Exportdatei trägt den Hostnamen im Namen.
- Lizenz GPL-3.0, Drittkomponenten in der README.

**English**

- First release as **NetSpeaker**: network speaker for the ESP32-S3 (4 MB flash, 2 MB PSRAM) with MAX98357A.
- Announcements via VoiceRSS, web radio, MP3 files in the device and from the optional SD card (with file manager).
- Announcements and files run in a queue; with web radio they are mixed over the ducked radio, without radio they fade in and out.
- Volume 0-100 with smooth changes, title rule with several keywords, autostart and restoring the last state.
- Web interface (tabs Sprechen, Webradio, SD-Karte, MP3, Audio, MQTT, WLAN, Zeit, Status, Log, Doku) with `` hints and wiring diagram, HTTP API and MQTT.
- Export and import of the settings without WiFi passwords and without API key; the export file carries the hostname in its name.
- License GPL-3.0, third-party components in the README.
