holgiw/ESP32-netspeaker/netspeaker.ino

// NetSpeaker: Texte per VoiceRSS ansagen und MP3 abspielen (ESP32-S3 + MAX98357A I2S-Verstaerker).
// NetSpeaker: speak texts via VoiceRSS and play MP3 (ESP32-S3 + MAX98357A I2S amplifier).
//
// Board: ESP32-S3 mit 4 MB Flash und 2 MB PSRAM. Flash 4MB, Partitionsschema "No OTA (2MB APP/2MB SPIFFS)",
// PSRAM (QSPI) und USB CDC On Boot aktivieren. Es gibt keine OTA-Partition, Updates nur per USB.
// Board: ESP32-S3 with 4 MB flash and 2 MB PSRAM. Flash 4MB, partition scheme "No OTA (2MB APP/2MB SPIFFS)",
// enable PSRAM (QSPI) and USB CDC On Boot. There is no OTA partition, updates only via USB.
//
// Bibliotheken: "ESP32-audioI2S" von schreibfaul1 (Version 4.0.0; audio->loop() muss regelmaessig aus loop() laufen)
// und "PubSubClient" von Nick O'Leary.
// Libraries: "ESP32-audioI2S" by schreibfaul1 (version 4.0.0; audio->loop() must run regularly from loop())
// and "PubSubClient" by Nick O'Leary.
//
// Verdrahtung / wiring: BCLK -> GPIO3, LRC -> GPIO4, DIN -> GPIO2 (aenderbar / changeable), VIN -> 5 V, GND -> GND.

#include <WiFi.h>
#include <WiFiUdp.h>
#include <WiFiClientSecure.h>
#include <WebServer.h>
#include <ESPmDNS.h>
#include <Preferences.h>
#include <nvs_flash.h>
#include <LittleFS.h>
#include <SPI.h>
#include <SD.h>
#include <algorithm>
#include <vector>
#include <HTTPClient.h>
#include <PubSubClient.h>
#include <Audio.h>
#include <atomic>
#include "mp3_decoder/mp3_decoder.h"
#include <esp_task_wdt.h>
#include <mbedtls/aes.h>
#include <mbedtls/sha256.h>
#include <driver/i2s_std.h>
#include <time.h>

#include "config.h"
#include "effects.h"

// ---------------------------------------------------------------------------
// Einstellungen / settings

struct Settings {
    String host;
    String ssid[3];
    String pass[3];
    String ntp[5];
    String tz;
    String vkey;
    String vlang;
    String vvoice;
    String vfmt;
    String mqttServer;
    String mqttUser;
    String mqttPass;
    String mqttBase;
    String mqttGroup[5];
    bool haDisc;
    int vrate;
    int vol;
    int bclk;
    int lrc;
    int din;
    int mqttPort;
    bool logEnabled;
    int logAutoMin;
    String radioName[RADIO_SLOTS];
    String radioUrl[RADIO_SLOTS];
    int radioVol[RADIO_SLOTS];
    int fadeMs;
    int switchFadeMs;
    bool autoStart;
    bool bootTone;
    bool mixAnn;
    bool loudNorm;
    bool radioAgc;
    int agcDb;
    int prebufSec;
    bool ttsCache;
    int fxMode;
    int fxWet;
    int eqBass;
    int eqTreble;
    int panMode;
    int panDs;
    int duckPct;
    int volRampMs;
    bool resumeLast;
    String lastUrl;
    int lastVol;
    bool sdOn;
    int sdCs;
    int sdSck;
    int sdMosi;
    int sdMiso;
    String titleMatch;
    int titleVol;
    int titleMaxS;
};

Settings cfg;

// Laengste Zeit (Millisekunden) von audio->loop() und von einem ganzen Durchlauf der Hauptschleife in den letzten 5 s; steht in /api/status.
// Longest time (milliseconds) of audio->loop() and of a whole pass of the main loop in the last 5 s; shown in /api/status.

volatile uint32_t diagAudioMs = 0;
volatile uint32_t diagLoopMs = 0;
volatile uint32_t diagBufMinKb = 0;
volatile uint32_t diagBufKb = 0;
volatile uint32_t diagDecErr = 0;
Preferences prefs;

// ---------------------------------------------------------------------------
// Laufzeitzustand / runtime state

enum PlayState { PS_IDLE, PS_LOADING, PS_PLAYING };
// Eine Mischspur: Ringpuffer, Zeiger und Zustand (siehe Mischer weiter unten); Spur 0 = Datei der SD-Karte ueber dem Radio, Spur 1 = Ansage.
// One mix track: ring buffer, pointers and state (see mixer further down); track 0 = file of the SD card over the radio, track 1 = announcement.

#define MIX_LAYER 0
#define MIX_ANN 1

static inline void audioPump();

struct MixTrack {
    int16_t* ring = nullptr;
    std::atomic<uint32_t> wr{0};
    std::atomic<uint32_t> rd{0};
    volatile bool active = false;
    volatile bool inUse = false;
    volatile bool producerDone = false;
    volatile bool abortFlag = false;
    volatile bool taskRunning = false;
    volatile bool drained = false;
    volatile bool inHook = false;
    volatile uint32_t srcRate = 0;
    volatile uint32_t outRate = 44100;
    volatile uint32_t phase = 0;
    volatile int32_t gainQ15 = 0;
    int32_t baseGainQ15 = 0;
    String path;
    bool onSd = false;
    int vol = 0;
    volatile bool muteIt = false;
    volatile uint32_t underFrames = 0;   // Frames ohne Daten (Aussetzer) / frames without data (dropouts)
    volatile uint32_t maxDecUs = 0;      // laengste Dekodierzeit eines Frames / longest decode time of a frame
    volatile uint32_t maxRdUs = 0;       // laengstes Lesen aus der Datei (mit Warten auf die Sperre) / longest read from the file (including waiting for the lock)
    volatile uint32_t firstUnderAt = 0;  // Zeitpunkt des ersten Aussetzers / time of the first dropout
    bool pending = false;
    unsigned long activateAt = 0;
    uint32_t lastRd = 0;
    unsigned long lastProgress = 0;
};

enum PendingType { PEND_NONE, PEND_SAY, PEND_URL, PEND_FILE, PEND_STOP };

struct Pending {
    PendingType type = PEND_NONE;
    String text;
    String lang;
    String voice;
    int rate = 99;
    int vol = -1;
    bool resume = false;
    bool force = false;
    bool save = false;
    bool noFx = false;   // Ansage ohne Klangeffekt / announcement without sound effect
    int pan = -1;        // Stereo-Position einer Datei: -1 allgemeine Einstellung, 0 aus, 1 lr, 2 rl, 3 pp, 4 links, 5 rechts / stereo position of a file: -1 general setting, 0 off, 1 lr, 2 rl, 3 pp, 4 left, 5 right
    int panDs = -1;      // Dauer eines Durchgangs in 0,1 s, -1 allgemeine Einstellung / duration of one pass in 0.1 s, -1 general setting
};

// Fundort einer Sprachdatei (steht hier oben, damit die automatischen Funktionsdeklarationen den Typ kennen).
// Location of a speech file (placed up here so the automatic function declarations know the type).

struct TtsLoc {
    int kind;
    String path;
    String suffix;   // Effektangaben im Dateinamen hinter der Pruefsumme, zum Beispiel _halle40_b3_t-2 / effect part of the file name behind the checksum
};

// Effektwerte einer Ansage (Hall/Echo/Klangregler) und die eigene Effekt-Instanz fuer gespeicherte Texte.
// Effect values of an announcement (reverb/echo/tone control) and the own effect instance for saved texts.

struct FxParams {
    int mode;
    int wet;
    int bass;
    int treble;
    int pan = 0;      // Wandern: 0 aus, 1 links->rechts, 2 rechts->links, 3 hin und her / sweep
    int panDs = 30;   // Dauer eines Durchgangs in 0,1 s / duration of one pass in 0.1 s
};

FxEngine annFx;

// Herkunft der zuletzt gesprochenen Ansage (voicerss, sd, flash, cache) und Zaehler, der bei jeder Ansage steigt; die Statusanzeige nutzt beides.
// Source of the announcement spoken last (voicerss, sd, flash, cache) and a counter that rises with every announcement; the status display uses both.

String speechFrom;
volatile uint32_t speechSeq = 0;

// Meldung, wenn ein Text nicht gespeichert werden konnte; die Seite zeigt sie als roten Hinweis (Zaehler zaehlt jede neue Meldung).
// Message when a text could not be saved; the page shows it as a red banner (the counter counts every new message).

String ttsSaveErr;
uint32_t ttsSaveErrN = 0;

Pending pending;

// Eintrag einer Ordnerliste der SD-Karte und aufgeloester Dateiname; die Typen stehen oben, weil die Arduino-IDE Funktionsprototypen vor die Funktionen setzt.
// Entry of a folder list of the SD card and a resolved file name; the types are up here because the Arduino IDE puts function prototypes before the functions.

struct SdEntry {
    String name;
    bool dir;
    uint32_t size;
};

struct FileRef {
    bool ok = false;
    bool sd = false;
    String path;
    String shown;
};

// Warteschlange fuer Ansagen und MP3-Dateien: sie werden nacheinander abgespielt, Stopp leert sie.
// Queue for announcements and MP3 files: they are played one after another, stop empties it.

Pending annQueue[ANN_QUEUE_LEN];
int annCount = 0;

bool annPush(const Pending& p) {
    if (annCount >= ANN_QUEUE_LEN) return false;
    annQueue[annCount++] = p;
    return true;
}

bool annTake(int idx, Pending& out) {
    if (idx < 0 || idx >= annCount) return false;
    out = annQueue[idx];
    for (int i = idx + 1; i < annCount; i++) annQueue[i - 1] = annQueue[i];
    annCount--;
    annQueue[annCount] = Pending();
    return true;
}

bool annPop(Pending& out) {
    if (annCount == 0) return false;
    out = annQueue[0];
    for (int i = 1; i < annCount; i++) annQueue[i - 1] = annQueue[i];
    annCount--;
    annQueue[annCount] = Pending();
    return true;
}

// Ordner-Sitzung: die MP3-Dateien eines Ordners der SD-Karte werden nacheinander in die Warteschlange gegeben, sobald sie leer ist. Mit shuffle
// ist die Reihenfolge je Sitzung zufaellig und jede Datei kommt einmal vor; mit loop beginnt danach eine neue Runde.
// Folder session: the MP3 files of a folder on the SD card are put into the queue one after another as soon as it is empty. With shuffle the
// order is random per session and every file appears once; with loop a new round starts afterwards.

struct DirSession {
    bool active = false;
    bool shuffle = false;
    bool loop = false;
    int vol = -1;
    int pan = -1;
    int panDs = -1;
    String dir;
    std::vector<String> names;
    size_t pos = 0;
    String lastPlayed;
    unsigned long lastFeed = 0;
};

DirSession dirSess;

void annClear() {
    for (int i = 0; i < ANN_QUEUE_LEN; i++) annQueue[i] = Pending();
    annCount = 0;
    dirSess.active = false;
    dirSess.names.clear();
}
volatile PlayState playState = PS_IDLE;
volatile bool silenceCarrier = false;   // Ausgabe laeuft mit Stille weiter, solange die zweite Datei allein spielt / output keeps running with silence while the second file plays alone
String lastError;
unsigned long playStartMillis = 0;
bool voiceBusy = false;
bool voiceEver = false;
bool voiceLastOk = false;

bool fsReady = false;
bool apActive = false;
unsigned long lastMqttTry = 0;

// Verbindungsueberwachung: Zaehler und Zeitpunkte fuer WLAN und MQTT.
// Connection supervision: counters and timestamps for WiFi and MQTT.

volatile bool gotIpFlag = false;
volatile uint8_t lastDisconnectReason = 0;
unsigned long wifiLostAt = 0;
unsigned long wifiNextTry = 0;
unsigned long wifiBackoff = WIFI_BACKOFF_START_MS;
unsigned long wifiTryStart = 0;
unsigned long wifiReconnects = 0;
int wifiTryIdx = -1;
unsigned long mqttBackoff = MQTT_BACKOFF_START_MS;
unsigned long mqttReconnects = 0;
bool mqttWasConnected = false;
IPAddress mqttIp;
bool mqttIpValid = false;
String mqttIpFor;
unsigned long loadStartMillis = 0;

// Webradio, das laufen soll: wird nach einem Abriss automatisch neu verbunden (nur Live-Streams, nicht nach Stopp).
// Web radio that should be running: reconnected automatically after a drop (live streams only, not after a stop).

String wantRadioUrl;
String lastRadioUrl;
int wantRadioVol = -1;
bool wantRadioLive = true;
bool streamWaitingReady = false;
unsigned long streamWaitSince = 0;
uint32_t streamLastFill = 0;
int streamStalls = 0;
unsigned long radioRetryAt = 0;
unsigned long radioRetryDelay = RADIO_RETRY_START_MS;

// Selbstschutz.
// Self protection.

bool safeMode = false;
int bootCrashes = 0;
bool bootMarkedStable = false;
unsigned long heapLowSince = 0;
bool mqttEverConnected = false;
String lastPublishedState;

SemaphoreHandle_t logMutex = nullptr;
WebServer webserver(80);
Audio* audio = nullptr;
WiFiClient mqttNet;
PubSubClient mqttClient(mqttNet);

// ---------------------------------------------------------------------------
// Log / log

// Die serielle Ausgabe laeuft immer; in die Logdatei wird nur geschrieben, wenn das Log eingeschaltet ist (Standard: aus).
// The serial output always runs; the log file is written only when logging is switched on (default: off).

void logLine(const String& msg) {
    char stamp[40];
    time_t now = time(nullptr);

    // Ohne gueltige Zeit (vor dem ersten NTP-Abgleich) zaehlt die Zeit seit dem Start.
    // Without a valid time (before the first NTP sync) the time since boot is used.

    if (now > 1700000000L) {
        struct tm timeinfo;
        localtime_r(&now, &timeinfo);
        strftime(stamp, sizeof(stamp), "[%Y-%m-%d %H:%M:%S", &timeinfo);
        snprintf(stamp + strlen(stamp), sizeof(stamp) - strlen(stamp), ".%03lu] ", millis() % 1000);
    } else {
        snprintf(stamp, sizeof(stamp), "[%lu ms] ", millis());
    }
    String line = String(stamp) + msg;
    Serial.println(line);
    if (!cfg.logEnabled || !fsReady || !logMutex) return;
    if (xSemaphoreTake(logMutex, pdMS_TO_TICKS(200)) != pdTRUE) return;
    File f = LittleFS.open(LOG_FILE, FILE_APPEND);
    if (f) {
        if (f.size() > LOG_MAX_BYTES) {
            f.close();
            LittleFS.remove(LOG_OLD_FILE);
            LittleFS.rename(LOG_FILE, LOG_OLD_FILE);
            f = LittleFS.open(LOG_FILE, FILE_WRITE);
        }
        if (f) {
            f.println(line);
            f.close();
        }
    }
    xSemaphoreGive(logMutex);
}

void clearLogFiles() {
    if (!fsReady || !logMutex) return;
    if (xSemaphoreTake(logMutex, pdMS_TO_TICKS(500)) != pdTRUE) return;
    LittleFS.remove(LOG_FILE);
    LittleFS.remove(LOG_OLD_FILE);
    xSemaphoreGive(logMutex);
}
// ---------------------------------------------------------------------------
// Hilfsfunktionen / helpers

String defaultHost() {
    uint64_t mac = ESP.getEfuseMac();
    char buf[8];
    snprintf(buf, sizeof(buf), "%02x%02x%02x", (unsigned)((mac >> 24) & 0xff), (unsigned)((mac >> 32) & 0xff), (unsigned)((mac >> 40) & 0xff));
    return String(PROJECT_NAME) + "-" + buf;
}

// Hostname bereinigen: Kleinbuchstaben, nur a-z 0-9 und Bindestrich, hoechstens 31 Zeichen, leer = Standardname.
// Clean the hostname: lower case, only a-z 0-9 and hyphen, at most 31 characters, empty = default name.

String cleanHost(String s) {
    s.toLowerCase();
    String out;
    for (size_t i = 0; i < s.length() && out.length() < 31; i++) {
        char c = s[i];
        if ((c >= 'a' && c <= 'z') || (c >= '0' && c <= '9') || c == '-') out += c;
    }
    while (out.startsWith("-")) out.remove(0, 1);
    while (out.endsWith("-")) out.remove(out.length() - 1);
    if (out.isEmpty()) return defaultHost();
    return out;
}

String urlEncode(const String& s) {
    String out;
    char buf[4];
    for (size_t i = 0; i < s.length(); i++) {
        uint8_t c = (uint8_t)s[i];
        if ((c >= 'a' && c <= 'z') || (c >= 'A' && c <= 'Z') || (c >= '0' && c <= '9') || c == '-' || c == '_' || c == '.' || c == '~') {
            out += (char)c;
        } else {
            snprintf(buf, sizeof(buf), "%%%02X", c);
            out += buf;
        }
    }
    return out;
}

String jsonEscape(const String& s) {
    String out;
    for (size_t i = 0; i < s.length(); i++) {
        char c = s[i];
        if (c == '"' || c == '\\') {
            out += '\\';
            out += c;
        } else if (c == '\n') {
            out += "\\n";
        } else if ((uint8_t)c >= 0x20) {
            out += c;
        }
    }
    return out;
}

bool timeIsValid() {
    return time(nullptr) > 1700000000L;
}

// Minimaler JSON-Leser fuer flache Objekte: liefert den Wert zu key (Text oder Zahl), leer wenn der Schluessel fehlt.
// Minimal JSON reader for flat objects: returns the value for key (text or number), empty if the key is missing.

String jsonGet(const String& body, const String& key) {
    int k = body.indexOf("\"" + key + "\"");
    if (k < 0) return "";
    int colon = body.indexOf(':', k + key.length() + 2);
    if (colon < 0) return "";
    int p = colon + 1;
    while (p < (int)body.length() && (body[p] == ' ' || body[p] == '\t' || body[p] == '\n' || body[p] == '\r')) p++;
    String out;
    if (p < (int)body.length() && body[p] == '"') {
        for (p++; p < (int)body.length() && body[p] != '"'; p++) {
            if (body[p] == '\\' && p + 1 < (int)body.length()) {
                p++;
                out += body[p] == 'n' ? '\n' : body[p];
            } else {
                out += body[p];
            }
        }
    } else {
        for (; p < (int)body.length() && body[p] != ',' && body[p] != '}'; p++) out += body[p];
        out.trim();
    }
    return out;
}
// GPIO 33-37 sind nur frei, wenn kein Octal-PSRAM verbaut ist (der ESP32-S3FH4R2 hat Quad-PSRAM); 26-32 gehoeren dem Flash und PSRAM.
// GPIO 33-37 are only free if no octal PSRAM is fitted (the ESP32-S3FH4R2 has quad PSRAM); 26-32 belong to flash and PSRAM.

bool pinAllowed(int pin) {
#if !defined(CONFIG_SPIRAM_MODE_OCT)
    if (pin >= 33 && pin <= 37) return true;
#endif
    return (pin >= 1 && pin <= 18) || pin == 21 || (pin >= 38 && pin <= 42) || pin == 47 || pin == 48;
}

// Alle zugelassenen Pins, die nicht eingestellt sind (Verstaerker, SD-Karte), keine Strapping-Pins sind und nicht die Status-LED tragen,
// bekommen einen Pull-up (High), damit offene Pins nicht schweben.
// All allowed pins that are not configured (amplifier, SD card), are no strapping pins and do not carry the status LED get a pull-up (high)
// so that open pins do not float.

bool pinIdle(int pin) {
    if (!pinAllowed(pin) || pin == 0 || pin == 3 || pin == 45 || pin == 46) return false;
    int used[] = {cfg.din, cfg.bclk, cfg.lrc, cfg.sdCs, cfg.sdSck, cfg.sdMosi, cfg.sdMiso, -1, -1};
    int n = 7;
#if defined(RGB_BUILTIN)
    int led = RGB_BUILTIN;
    if (led >= SOC_GPIO_PIN_COUNT) led -= SOC_GPIO_PIN_COUNT;
    used[n++] = led;
#endif
#if defined(LED_BUILTIN)
    used[n++] = LED_BUILTIN;
#endif
    for (int i = 0; i < n; i++) {
        if (used[i] == pin) return false;
    }
    return true;
}

void idlePins() {
    for (int pin = 1; pin <= 48; pin++) {
        if (pinIdle(pin)) pinMode(pin, INPUT_PULLUP);
    }
}

// Eingaenge: Ein freier Pin (Pull-up) loest eine Aktion aus, sobald er Kontakt nach GND bekommt (zum Beispiel durch eine Taste).
// Die Aktion ist eine Ansage (VoiceRSS) oder eine MP3-Datei bzw. URL; sie kommt wie ein Aufruf per REST in die Warteschlange.
// Inputs: A free pin (pull-up) triggers an action as soon as it gets contact to GND (for example through a button).
// The action is an announcement (VoiceRSS) or an MP3 file or URL; it enters the queue like a call via REST.

String pinType[49];
String pinText[49];
int pinVol[49];

void loadPinActions() {
    for (int pin = 1; pin <= 48; pin++) {
        if (!pinAllowed(pin)) continue;
        pinType[pin] = prefs.getString(("pt" + String(pin)).c_str(), "");
        pinText[pin] = prefs.getString(("px" + String(pin)).c_str(), "");
        pinVol[pin] = prefs.getInt(("pv" + String(pin)).c_str(), -1);
    }
}

String commandSay(const String& textIn, const String& lang, const String& voice, int rate, int vol, bool save = false, bool useFx = true);
String commandPlayFile(const String& nameIn, int vol, bool shuffle, bool loop);
String commandPlayUrl(const String& urlIn, int vol);
String commandPlayStation(const String& selIn, int vol);
bool pinTypeIsControl(const String& t);
String commandPinControl(const String& type, const String& x, int vol);

void pinWatch() {
    static unsigned long lastScan = 0, lowSince[49], lastFire = 0;
    static bool armed[49];
    if (millis() - lastScan < 10) return;
    lastScan = millis();
    for (int pin = 1; pin <= 48; pin++) {
        if (pinType[pin].isEmpty() || !pinIdle(pin)) continue;
        if (digitalRead(pin) != LOW) {
            lowSince[pin] = 0;
            armed[pin] = true;
            continue;
        }
        if (!armed[pin]) continue;
        if (lowSince[pin] == 0) {
            lowSince[pin] = millis();
            continue;
        }
        if (millis() - lowSince[pin] < 40) continue;
        armed[pin] = false;
        if (millis() - lastFire < 300) continue;
        lastFire = millis();
        String err;
        const String& x = pinText[pin];
        if (pinTypeIsControl(pinType[pin])) err = commandPinControl(pinType[pin], x, pinVol[pin]);
        else if (pinType[pin] == "say") err = commandSay(x, "", "", 99, pinVol[pin]);
        else if (pinType[pin] == "station") err = commandPlayStation(x, pinVol[pin]);
        else if (x.startsWith("http://") || x.startsWith("https://")) err = commandPlayUrl(x, pinVol[pin]);
        else err = commandPlayFile(x, pinVol[pin], false, false);
        logLine("[PIN] GPIO " + String(pin) + " to GND -> " + pinType[pin] + " \"" + x + "\"" + (err.length() > 0 ? ": " + err : String()));
    }
}

String mqttBaseTopic() {
    if (cfg.mqttBase.length() > 0) return cfg.mqttBase;
    return String(PROJECT_NAME) + "/" + cfg.host;
}

// Gruppen-Topic i (0-4) ohne abschliessendes "/" oder "#"; leer, wenn nicht gesetzt, ungueltig (+, #) oder gleich dem Basis-Topic.
// Group topic i (0-4) without a trailing "/" or "#"; empty if unset, invalid (+, #) or equal to the base topic.

String mqttGroupTopic(int i) {
    String g = cfg.mqttGroup[i];
    g.trim();
    while (g.endsWith("#") || g.endsWith("/")) g.remove(g.length() - 1);
    if (g.indexOf('+') >= 0 || g.indexOf('#') >= 0 || g == mqttBaseTopic()) return String();
    return g;
}

// ---------------------------------------------------------------------------
// Einstellungen laden und speichern / load and save settings

void loadSettings() {
    prefs.begin(PROJECT_NVS, false);

    // Frueher lag die Lautstaerke auf der Skala 0 bis 21; gespeicherte Werte einmalig auf 0 bis VOLUME_MAX umrechnen.
    // The volume used to be on the scale 0 to 21; convert stored values once to 0 to VOLUME_MAX.

    int storedScale = prefs.getInt("vscale", 21);
    if (storedScale != VOLUME_MAX && storedScale > 0) {
        const char* volKeys[] = {"vol", "tvol"};
        for (int k = 0; k < 2; k++) {
            if (prefs.isKey(volKeys[k])) prefs.putInt(volKeys[k], (prefs.getInt(volKeys[k], 0) * VOLUME_MAX + storedScale / 2) / storedScale);
        }
        for (int i = 1; i <= RADIO_SLOTS; i++) {
            String key = "rv" + String(i);
            int old = prefs.getInt(key.c_str(), -1);
            if (old >= 0) prefs.putInt(key.c_str(), (old * VOLUME_MAX + storedScale / 2) / storedScale);
        }
        prefs.putInt("vscale", VOLUME_MAX);
    }

    // Gespeicherten Hostnamen mit ungueltigen Zeichen einmalig korrigieren und zurueckschreiben.
    // Correct a stored hostname with invalid characters once and write it back.

    String stored = prefs.getString("host", "");
    if (stored.length() > 0) {
        String cleaned = cleanHost(stored);
        if (cleaned != stored) {
            prefs.putString("host", cleaned);
            logLine("[Hostname] invalid characters corrected: \"" + stored + "\" -> \"" + cleaned + "\"");
            stored = cleaned;
        }
    }
    cfg.host = stored.length() > 0 ? stored : defaultHost();
    for (int i = 0; i < 3; i++) {
        cfg.ssid[i] = prefs.getString(("ssid" + String(i + 1)).c_str(), "");
        cfg.pass[i] = prefs.getString(("pass" + String(i + 1)).c_str(), "");
    }
    cfg.ntp[0] = prefs.getString("ntp1", "pool.ntp.org");
    cfg.ntp[1] = prefs.getString("ntp2", "time.google.com");
    for (int i = 2; i < 5; i++) cfg.ntp[i] = prefs.getString(("ntp" + String(i + 1)).c_str(), "");
    cfg.tz = prefs.getString("tz", "CET-1CEST,M3.5.0,M10.5.0/3");
    cfg.vkey = prefs.getString("vkey", "");
    cfg.vlang = prefs.getString("vlang", "de-de");
    cfg.vvoice = prefs.getString("vvoice", "");
    cfg.vfmt = prefs.getString("vfmt", "22khz_16bit_mono");
    cfg.vrate = prefs.getInt("vrate", 0);
    cfg.vol = constrain(prefs.getInt("vol", 57), 0, VOLUME_MAX);
    cfg.bclk = prefs.getInt("bclk", DEFAULT_PIN_BCLK);
    cfg.lrc = prefs.getInt("lrc", DEFAULT_PIN_LRC);
    cfg.din = prefs.getInt("din", DEFAULT_PIN_DIN);
    cfg.mqttServer = prefs.getString("mq_srv", "");
    cfg.mqttUser = prefs.getString("mq_usr", "");
    cfg.mqttPass = prefs.getString("mq_pw", "");
    cfg.mqttPort = prefs.getInt("mq_port", 1883);
    cfg.mqttBase = prefs.getString("mq_base", "");
    cfg.mqttGroup[0] = prefs.getString("mq_g1", String(PROJECT_NAME) + "/all");
    for (int i = 1; i < 5; i++) cfg.mqttGroup[i] = prefs.getString(("mq_g" + String(i + 1)).c_str(), "");
    cfg.haDisc = prefs.getBool("mq_ha", false);
    cfg.logEnabled = prefs.getBool("log", false);
    cfg.logAutoMin = constrain(prefs.getInt("logmin", 60), 0, 1440);
    cfg.fadeMs = constrain(prefs.getInt("fade", FADE_DEFAULT_MS), 0, FADE_MAX_MS);
    cfg.switchFadeMs = constrain(prefs.getInt("swfade", SWITCH_FADE_DEFAULT_MS), 0, FADE_MAX_MS);
    cfg.autoStart = prefs.getBool("autostart", false);
    cfg.bootTone = prefs.getBool("btone", true);
    cfg.ttsCache = prefs.getBool("ttsc", false);
    cfg.fxMode = constrain(prefs.getInt("fxmode", 0), 0, 4);
    cfg.fxWet = constrain(prefs.getInt("fxwet", 30), 0, 100);
    cfg.eqBass = constrain(prefs.getInt("eqb", 0), -12, 12);
    cfg.eqTreble = constrain(prefs.getInt("eqt", 0), -12, 12);
    cfg.panMode = constrain(prefs.getInt("panm", 0), 0, 3);
    cfg.panDs = constrain(prefs.getInt("pand", 30), 5, 200);
    cfg.mixAnn = prefs.getBool("mix", true);
    cfg.loudNorm = prefs.getBool("loud", true);
    cfg.radioAgc = prefs.getBool("agc", false);
    cfg.agcDb = constrain(prefs.getInt("agcdb", -18), -30, -10);
    cfg.prebufSec = constrain(prefs.getInt("prebuf", 5), 0, 30);
    cfg.duckPct = constrain(prefs.getInt("duck", 35), 0, 100);
    cfg.volRampMs = constrain(prefs.getInt("vramp", VOLUME_RAMP_DEFAULT_MS), 0, VOLUME_RAMP_MAX_MS);
    cfg.resumeLast = prefs.getBool("rlast", false);
    cfg.lastUrl = prefs.getString("rsurl", "");
    cfg.lastVol = prefs.getInt("rsvol", -1);
    cfg.sdOn = prefs.getBool("sdon", true);
    cfg.sdCs = prefs.getInt("sdcs", DEFAULT_SD_CS);
    cfg.sdSck = prefs.getInt("sdsck", DEFAULT_SD_SCK);
    cfg.sdMosi = prefs.getInt("sdmosi", DEFAULT_SD_MOSI);
    cfg.sdMiso = prefs.getInt("sdmiso", DEFAULT_SD_MISO);
    cfg.titleMatch = prefs.getString("tmatch", "Cambodia");
    cfg.titleVol = constrain(prefs.getInt("tvol", 86), 0, VOLUME_MAX);
    cfg.titleMaxS = constrain(prefs.getInt("tmax", 0), 0, 3600);
    for (int i = 0; i < RADIO_SLOTS; i++) {
        cfg.radioName[i] = prefs.getString(("rn" + String(i + 1)).c_str(), "");
        cfg.radioUrl[i] = prefs.getString(("ru" + String(i + 1)).c_str(), "");
        cfg.radioVol[i] = prefs.getInt(("rv" + String(i + 1)).c_str(), -1);
    }

    // Ist die Senderliste leer (Platz 1 leer), wird sie mit dem Standardsender vorbelegt.
    // If the station list is empty (slot 1 empty), it is preset with the default station.

    prefs.remove("rsadel");
    if (cfg.radioUrl[0].isEmpty()) {
        cfg.radioName[0] = DEFAULT_STATION_NAME;
        cfg.radioUrl[0] = DEFAULT_STATION_URL;
    }
}

// ---------------------------------------------------------------------------
// Wiedergabe / playback

void publishStatus(bool force = false);
void publishFavorites(bool force = false);
void onAudioEvent(Audio::msg_t m);
void mixStopAll();

// Die Audio-Bibliothek ruft den Rueckruf aus ihrem eigenen Task auf. Dort wird nur in eine Warteschlange geschrieben,
// die Hauptschleife arbeitet die Ereignisse ab; so greifen nie zwei Tasks auf Strings, MQTT oder den Zustand zu.
// The audio library calls the callback from its own task. There it only writes to a queue, the main loop handles the
// events; this way two tasks never touch strings, MQTT or the state at the same time.

#define AUDIO_EVT_QUEUE_LEN 40

struct AudioEvt {
    uint8_t type;
    char text[168];
};

QueueHandle_t audioEvtQueue = nullptr;

// Das Audio-Objekt belegt viel internen RAM und wird nur zum Abspielen angelegt; sonst fehlt der Platz fuer die TLS-Verbindung.
// The audio object uses a lot of internal RAM and exists only while playing; otherwise there is no room for the TLS connection.

int currentVolume = 57;
unsigned long volChangedAt = 0;
int lastPublishedVol = -1;
int lastPublishedGeneral = -1;

// MQTT-Neustart: Zeitpunkt des angeforderten Neustarts (0 = keiner) und Zeitpunkt des letzten Abonnierens.
// MQTT restart: time of the requested restart (0 = none) and time of the last subscribe.

unsigned long restartAt = 0;
unsigned long mqttSubscribedAt = 0;
const unsigned long MQTT_RESTART_IGNORE_MS = 3000;

// Laeuft ein Webradio und kommt eine Ansage oder Datei, merken wir uns Stream und Lautstaerke und setzen den Stream danach fort.
// If a web radio is playing and an announcement or file arrives, we remember stream and volume and resume the stream afterwards.

String streamUrl;
bool streamActive = false;

// Was gerade laeuft: nowKind ist "radio", "file", "speech" oder leer; nowName/nowTitle kommen aus den Stream-Metadaten.
// What is playing right now: nowKind is "radio", "file", "speech" or empty; nowName/nowTitle come from the stream metadata.

String nowKind;
String nowFile;
String nowName;
String nowTitle;
String nowGenre;
String nowDesc;
String nowWeb;
String nowLogo;
String nowHost;
uint32_t nowBitrate = 0;

// Titel des Senders kommen mit dem Datenstrom, die Musik dazu spielt erst, wenn der Eingangspuffer abgespielt ist. Darum wird ein neuer Titel
// um die Dauer des gepufferten Tons verzoegert angezeigt (und fuer die Titelregel gemeldet).
// Titles of the station come with the data stream, the music for them plays only when the input buffer has been played. So a new title is shown
// (and passed on to the title rule) delayed by the duration of the buffered sound.

#define TITLE_Q_LEN 4
struct TitlePend {
    String text;
    unsigned long due;
};
TitlePend titleQ[TITLE_Q_LEN];
int titleQn = 0;
String lastPublishedNow;
String resumeUrl;
int resumeVolume = 57;

// Einblenden nach der Fortsetzung: wartet auf "stream ready", steigt dann in fadeMs von 0 auf fadeInTarget.
// Fade-in after the resume: waits for "stream ready", then rises from 0 to fadeInTarget within fadeMs.

bool fadeInWaiting = false;
bool fadeInActive = false;
unsigned long fadeInStart = 0;
int fadeInTarget = 0;
int fadeInMs = 700;
// Sanftes Aendern der Radio-Lautstaerke (Ducking): Start, Ziel und Dauer; die Schritte macht rampStep() in der Hauptschleife.
// Gentle change of the radio volume (ducking): start, target and duration; rampStep() makes the steps in the main loop.

struct VolRamp {
    bool on = false;
    int from = 0;
    int to = 0;
    int now = 0;
    unsigned long t0 = 0;
    int ms = 0;
};
VolRamp volRamp;

// Der Radio-Pegel ist wegen einer laufenden Ansage abgesenkt.
// The radio level is lowered because of a running announcement.

bool mixDucked = false;
unsigned long mixDuckAt = 0;

void ensureAudio() {
    if (audio) return;
    audio = new Audio();
    Audio::audio_info_callback = onAudioEvent;
    audio->setPinout(pinAllowed(cfg.bclk) ? cfg.bclk : DEFAULT_PIN_BCLK, pinAllowed(cfg.lrc) ? cfg.lrc : DEFAULT_PIN_LRC, pinAllowed(cfg.din) ? cfg.din : DEFAULT_PIN_DIN);
    audio->setVolumeSteps(VOLUME_MAX * VOL_FINE);
    audio->setVolume(currentVolume * VOL_FINE);
    audio->setPrebufferSec(cfg.prebufSec);
    volRamp.on = false;
    volRamp.now = currentVolume * VOL_FINE;
    logLine("[AUDIO] created, free heap " + String(ESP.getFreeHeap()));
}

void releaseAudio() {
    mixStopAll();
    if (!audio) return;
    audio->stopSong();
    delete audio;
    audio = nullptr;
    if (audioEvtQueue) xQueueReset(audioEvtQueue);
    logLine("[AUDIO] released, free heap " + String(ESP.getFreeHeap()));
}

bool titleBoost = false;
unsigned long titleBoostSince = 0;
int titleSavedVol = 0;
int titleBoostVol = 0;

void applyVolume(int v);

// Beendet eine Lautstaerke-Anhebung durch die Titelregel.
// Ends a volume raise made by the title rule.

void titleBoostEnd() {
    if (!titleBoost) return;
    titleBoost = false;
    applyVolume(titleSavedVol);
}

void applyVolume(int v) {
    if (v < 0) v = 0;
    if (v > VOLUME_MAX) v = VOLUME_MAX;
    currentVolume = v;
    volChangedAt = millis();
    if (streamActive && nowKind == "radio" && !mixDucked) wantRadioVol = v;
    volRamp.on = false;
    volRamp.now = v * VOL_FINE;
    if (audio) audio->setVolume(v * VOL_FINE);
}

// Ziel in feinen Einheiten (Lautstaerke mal VOL_FINE).
// Target in fine units (volume times VOL_FINE).

void volRampTo(int to, int ms) {
    if (!audio) return;
    volRamp.from = volRamp.now;
    volRamp.now = volRamp.from;
    volRamp.to = to;
    volRamp.ms = ms;
    volRamp.t0 = millis();
    volRamp.on = true;
}

void volRampStep() {
    if (!volRamp.on) return;
    if (!audio) {
        volRamp.on = false;
        return;
    }
    unsigned long dt = millis() - volRamp.t0;
    int v = volRamp.to;
    if (volRamp.ms > 0 && dt < (unsigned long)volRamp.ms) v = volRamp.from + (int)((long)(volRamp.to - volRamp.from) * (long)dt / volRamp.ms);
    if (v != volRamp.now) {
        volRamp.now = v;
        audio->setVolume(v);
    }
    if (dt >= (unsigned long)volRamp.ms) volRamp.on = false;
}

// Aendert die Lautstaerke sanft: bei laufendem Ton wandert sie in ms (Standard cfg.volRampMs) zum neuen Wert, sonst gilt der Wert sofort.
// Waehrend einer Ansage bleibt das Radio entsprechend abgesenkt, beim Einblenden wird nur das Ziel geaendert.
// Changes the volume gently: while sound is playing it moves to the new value within ms (default cfg.volRampMs), otherwise the value applies at once.
// During an announcement the radio stays lowered accordingly, during a fade-in only the target changes.

void applyVolumeSmooth(int v, int ms = -1) {
    if (v < 0) v = 0;
    if (v > VOLUME_MAX) v = VOLUME_MAX;
    if (ms < 0) ms = cfg.volRampMs;
    if (ms > VOLUME_RAMP_MAX_MS) ms = VOLUME_RAMP_MAX_MS;
    if (fadeInWaiting || fadeInActive) {
        fadeInTarget = v;
        return;
    }
    if (!audio || playState != PS_PLAYING) {
        applyVolume(v);
        return;
    }
    currentVolume = v;
    volChangedAt = millis();
    if (streamActive && nowKind == "radio" && !mixDucked) wantRadioVol = v;
    volRampTo(mixDucked ? v * VOL_FINE * cfg.duckPct / 100 : v * VOL_FINE, ms);
}

// Anzeigename des Streams: gespeicherter Name des Platzes, sonst der Sendername aus den Metadaten, sonst der Host der URL.
// Display name of the stream: stored name of the slot, otherwise the station name from the metadata, otherwise the host of the URL.

String stationDisplayName() {
    for (int i = 0; i < RADIO_SLOTS; i++) {
        if (cfg.radioUrl[i].length() > 0 && cfg.radioUrl[i] == streamUrl && cfg.radioName[i].length() > 0) return cfg.radioName[i];
    }
    if (nowName.length() > 0) return nowName;
    String host = streamUrl;
    int p = host.indexOf("://");
    if (p >= 0) host = host.substring(p + 3);
    int slash = host.indexOf('/');
    if (slash >= 0) host = host.substring(0, slash);
    return host;
}

String nowText() {
    if (playState == PS_IDLE || nowKind.isEmpty()) return "";
    if (nowKind == "radio") return stationDisplayName() + (nowTitle.length() > 0 ? " - " + nowTitle : "");
    if (nowKind == "file") return nowFile;
    return "Ansage";
}

void queueResumeIfNeeded() {
    if (resumeUrl.isEmpty() || pending.type != PEND_NONE || annCount > 0) return;
    pending.type = PEND_URL;
    pending.text = resumeUrl;
    pending.vol = -1;
    pending.resume = true;
    pending.force = false;
    logLine("[PLAY] resuming stream " + resumeUrl);
}

// Im Leerlauf gilt wieder die allgemeine Lautstaerke, ausser eine Fortsetzung oder ein neuer Befehl wartet schon.
// When idle the general volume applies again, unless a resume or a new command is already waiting.

void settleVolume() {
    if (pending.type == PEND_NONE && resumeUrl.isEmpty() && annCount == 0 && currentVolume != cfg.vol) applyVolume(cfg.vol);
}

void setIdle() {
    silenceCarrier = false;
    mixStopAll();
    titleBoostEnd();
    streamWaitingReady = false;
    playState = PS_IDLE;
    nowKind = "";
    publishStatus();
    queueResumeIfNeeded();
    settleVolume();
}

void stopPlayback() {
    silenceCarrier = false;
    mixStopAll();
    titleBoostEnd();
    if (audio) audio->stopSong();
    if (audioEvtQueue) xQueueReset(audioEvtQueue);
    streamActive = false;
    streamWaitingReady = false;
    nowKind = "";
    playState = PS_IDLE;
}

void failPlayback(const String& msg) {
    lastError = msg;
    logLine("[PLAY] " + msg);
    nowKind = "";
    playState = PS_IDLE;
    publishStatus(true);
    queueResumeIfNeeded();
    settleVolume();
}

// SD-Karte (SPI): Dateien der Karte werden mit "sd:/Ordner/Datei.mp3" angesprochen, ein Name mit "/" am Ende bedeutet den ganzen Ordner.
// SD card (SPI): files of the card are addressed as "sd:/folder/file.mp3", a name ending in "/" means the whole folder.

SPIClass sdSpi(FSPI);
SemaphoreHandle_t sdMutex = nullptr;
bool sdReady = false;
String sdState = "off";

// Bindet die Karte (neu) ein; ohne Karte oder bei ausgeschaltetem SD bleibt sdReady falsch, alles andere laeuft weiter.
// Mounts the card (again); without a card or with SD switched off sdReady stays false, everything else keeps running.

void sdStopAll();

bool sdMount() {
    sdStopAll();
    if (sdMutex) xSemaphoreTake(sdMutex, pdMS_TO_TICKS(3000));
    if (sdReady) SD.end();
    sdReady = false;
    sdSpi.end();
    if (!cfg.sdOn) {
        sdState = "off";
    } else {
        sdSpi.begin(cfg.sdSck, cfg.sdMiso, cfg.sdMosi, cfg.sdCs);
        if (SD.begin(cfg.sdCs, sdSpi, 16000000) && SD.cardType() != CARD_NONE) {
            sdReady = true;
            const char* t = SD.cardType() == CARD_SD ? "SD" : (SD.cardType() == CARD_SDHC ? "SDHC" : "card");
            sdState = String(t);
            logLine("[SD] " + sdState + " mounted, " + String((unsigned long)(SD.cardSize() / 1048576ULL)) + " MB");
        } else {
            SD.end();
            sdSpi.end();
            sdState = "no card";
            logLine("[SD] no card or mount failed (CS " + String(cfg.sdCs) + ", SCK " + String(cfg.sdSck) + ", MOSI " + String(cfg.sdMosi) + ", MISO " + String(cfg.sdMiso) + ")");
        }
    }
    if (sdMutex) xSemaphoreGive(sdMutex);
    idlePins();
    return sdReady;
}

// Listet einen Ordner der Karte (nur Ordner und MP3-Dateien), Ordner zuerst, dann nach Name.
// Lists a folder of the card (only folders and MP3 files), folders first, then by name.

bool sdListDir(String dir, std::vector<SdEntry>& out) {
    if (!sdReady) return false;
    if (!dir.startsWith("/")) dir = "/" + dir;
    if (dir.length() > 1 && dir.endsWith("/")) dir.remove(dir.length() - 1);
    if (dir.indexOf("..") >= 0 || dir.length() > 160) return false;
    if (xSemaphoreTake(sdMutex, pdMS_TO_TICKS(2000)) != pdTRUE) return false;
    File d = SD.open(dir.c_str());
    bool ok = d && d.isDirectory();
    if (ok) {
        File e = d.openNextFile();
        while (e && (int)out.size() < SD_LIST_MAX) {
            String n = String(e.name());
            n = n.substring(n.lastIndexOf('/') + 1);
            bool isDir = e.isDirectory();
            bool show = !n.startsWith(".") && n != "System Volume Information";
            if (show && !isDir) {
                String l = n;
                l.toLowerCase();
                show = l.endsWith(".mp3");
            }
            if (show) out.push_back(SdEntry{n, isDir, (uint32_t)e.size()});
            e.close();
            esp_task_wdt_reset();
            e = d.openNextFile();
        }
        if (e) e.close();
    }
    if (d) d.close();
    xSemaphoreGive(sdMutex);
    std::sort(out.begin(), out.end(), [](const SdEntry& a, const SdEntry& b) {
        if (a.dir != b.dir) return a.dir;
        String x = a.name, y = b.name;
        x.toLowerCase();
        y.toLowerCase();
        return x < y;
    });
    return ok;
}

// Namen auf der Karte: Umlaute werden umschrieben, Leerzeichen werden zu Unterstrichen, sonst nur Buchstaben, Ziffern und . - _ ( ).
// Dateien muessen auf .mp3 enden (zu lange Namen behalten die Endung); leer = nicht erlaubt.
// Names on the card: umlauts are transliterated, spaces become underscores, otherwise only letters, digits and . - _ ( ).
// Files must end in .mp3 (names that are too long keep the extension); empty = not allowed.

String sdCleanName(const String& name, bool isFile) {
    String out;
    for (size_t i = 0; i < name.length() && out.length() < 120; i++) {
        uint8_t c = (uint8_t)name[i];
        if (c == 0xC3 && i + 1 < name.length()) {
            uint8_t d = (uint8_t)name[++i];
            if (d == 0xA4) out += "ae";
            else if (d == 0xB6) out += "oe";
            else if (d == 0xBC) out += "ue";
            else if (d == 0x84) out += "Ae";
            else if (d == 0x96) out += "Oe";
            else if (d == 0x9C) out += "Ue";
            else if (d == 0x9F) out += "ss";
            continue;
        }
        if ((c >= 'a' && c <= 'z') || (c >= 'A' && c <= 'Z') || (c >= '0' && c <= '9') || c == '.' || c == '-' || c == '_' || c == '(' || c == ')') out += (char)c;
        else if (c == ' ') out += '_';
    }
    while (out.startsWith(".")) out.remove(0, 1);
    if (isFile) {
        String l = out;
        l.toLowerCase();
        if (!l.endsWith(".mp3")) return "";
        if (out.length() > 100) out = out.substring(0, 96) + ".mp3";
    } else if (out.length() > 60) {
        out = out.substring(0, 60);
    }
    return out;
}

bool sdPathOk(const String& p) {
    return p.startsWith("/") && p.length() <= 160 && p.indexOf("..") < 0 && p.indexOf("//") < 0 && p.indexOf('\\') < 0;
}

// Ordner samt Inhalt loeschen; der Aufrufer haelt die Sperre.
// Delete a folder together with its content; the caller holds the lock.

bool sdRemoveTree(const String& path, int depth) {
    if (depth > 8) return false;
    File d = SD.open(path.c_str());
    if (!d) return false;
    if (!d.isDirectory()) {
        d.close();
        return SD.remove(path.c_str());
    }
    std::vector<String> names;
    File e = d.openNextFile();
    while (e) {
        String n = String(e.name());
        names.push_back(n.substring(n.lastIndexOf('/') + 1));
        e.close();
        esp_task_wdt_reset();
        e = d.openNextFile();
    }
    d.close();
    bool ok = true;
    for (size_t i = 0; i < names.size(); i++) {
        ok = sdRemoveTree(path + "/" + names[i], depth + 1) && ok;
        esp_task_wdt_reset();
    }
    return SD.rmdir(path.c_str()) && ok;
}

// Loest einen Dateinamen aus einem Befehl auf: "sd:/Pfad.mp3" liegt auf der Karte, alles andere im Ordner /mp3 des Geraets.
// Resolves a file name from a command: "sd:/path.mp3" is on the card, everything else in the /mp3 folder of the device.

FileRef resolveFile(String name) {
    FileRef r;
    name.trim();
    if (name.startsWith("sd:")) {
        r.sd = true;
        name.remove(0, 3);
        if (!name.startsWith("/")) name = "/" + name;
        r.path = name;
        r.shown = "sd:" + name;
        String l = name;
        l.toLowerCase();
        if (!sdReady || name.indexOf("..") >= 0 || name.length() > 160 || !l.endsWith(".mp3")) return r;
        if (xSemaphoreTake(sdMutex, pdMS_TO_TICKS(1000)) == pdTRUE) {
            r.ok = SD.exists(name.c_str());
            xSemaphoreGive(sdMutex);
        }
        return r;
    }
    String plain = name;
    if (plain.startsWith("/")) plain.remove(0, 1);
    if (name.startsWith("/")) name.remove(0, 1);
    if (name.startsWith("mp3/")) name.remove(0, 4);
    r.path = String(MP3_DIR) + "/" + name;
    r.shown = name;
    r.ok = fsReady && !name.isEmpty() && name.indexOf("..") < 0 && LittleFS.exists(r.path);

    // Ein Name ohne "sd:" wird zuerst im Flash gesucht, dann auf der SD-Karte (Pfad ab Wurzel).
    // A name without "sd:" is looked up in the flash first, then on the SD card (path from the root).

    if (!r.ok && sdReady && !plain.isEmpty()) {
        FileRef s = resolveFile("sd:/" + plain);
        if (s.ok) return s;
    }
    return r;
}

// Lautstaerke-Angleichung der MP3-Dateien (nicht der Ansagen): Beim ersten Abspielen misst ein Hintergrund-Task die Lautheit der ganzen
// Datei (Bloecke zu 400 ms, Gate wie bei EBU R128, aber ohne K-Filter) und merkt sich den Ausgleich in /loudness.bin; er wirkt als Faktor
// vor der Ausgabe. Das Ziel ist ein Pegel von LOUD_TARGET_DB, der Spitzenwert bleibt unter -1 dBFS.
// Loudness matching of the MP3 files (not of announcements): on the first play a background task measures the loudness of the whole file
// (blocks of 400 ms, gate as in EBU R128 but without the K filter) and stores the correction in /loudness.bin; it acts as a factor before
// the output. The goal is a level of LOUD_TARGET_DB, the peak stays below -1 dBFS.

#define LOUD_TARGET_DB -16.0f
#define LOUD_MAX_ENTRIES 400
#define LOUD_FILE "/loudness.bin"

struct LoudRec {
    uint32_t key;
    int32_t db10;
};

std::vector<LoudRec> loudCache;
bool loudCacheLoaded = false;
volatile bool fileGainOn = false;
volatile bool agcActive = false;
volatile bool muted = false;
volatile int32_t muteGainQ15 = 32768;
volatile bool agcResetReq = false;
volatile float agcGainShown = 0.0f;
volatile int32_t fileGainQ15 = 32768;
float fileGainCurDb = 0.0f;
float fileGainTargetDb = 0.0f;
bool fileGainKnown = false;
uint32_t loudCurKey = 0;
volatile bool loudBusy = false;
volatile bool loudDone = false;
String loudJobPath;
bool loudJobSd = false;
uint32_t loudJobKey = 0;
bool loudResultOk = false;
int loudResultDb10 = 0;
float loudResultRms = 0;
float loudResultPeak = 0;
bool loudPend = false;
String loudPendPath;
bool loudPendSd = false;
uint32_t loudPendKey = 0;

uint32_t loudKey(const String& path, bool sd, size_t size) {
    uint32_t h = 2166136261UL;
    for (size_t i = 0; i < path.length(); i++) h = (h ^ (uint8_t)path[i]) * 16777619UL;
    return (h ^ (uint32_t)size) * 16777619UL + (sd ? 1 : 0);
}

int32_t loudQ15(float db) {
    return (int32_t)(powf(10.0f, db / 20.0f) * 32768.0f);
}

void loudLoad() {
    if (loudCacheLoaded || !fsReady) return;
    loudCacheLoaded = true;
    File f = LittleFS.open(LOUD_FILE, FILE_READ);
    if (!f) return;
    LoudRec r;
    while (f.read((uint8_t*)&r, sizeof(r)) == sizeof(r)) loudCache.push_back(r);
    f.close();
}

bool loudFind(uint32_t key, int& db10) {
    loudLoad();
    for (size_t i = 0; i < loudCache.size(); i++) {
        if (loudCache[i].key == key) {
            db10 = loudCache[i].db10;
            return true;
        }
    }
    return false;
}

void loudAdd(uint32_t key, int db10) {
    loudLoad();
    bool found = false;
    for (size_t i = 0; i < loudCache.size(); i++) {
        if (loudCache[i].key == key) {
            loudCache[i].db10 = db10;
            found = true;
        }
    }
    if (!found) {
        if (loudCache.size() >= LOUD_MAX_ENTRIES) loudCache.erase(loudCache.begin());
        LoudRec r;
        r.key = key;
        r.db10 = db10;
        loudCache.push_back(r);
    }
    if (!fsReady) return;
    File f = LittleFS.open(LOUD_FILE, FILE_WRITE);
    if (!f) return;
    for (size_t i = 0; i < loudCache.size(); i++) f.write((const uint8_t*)&loudCache[i], sizeof(LoudRec));
    f.close();
}

int loudRead(File& f, bool sd, uint8_t* buf, size_t len) {
    if (sd) xSemaphoreTake(sdMutex, portMAX_DELAY);
    int n = f.read(buf, len);
    if (sd) xSemaphoreGive(sdMutex);
    return n;
}

void loudSeek(File& f, bool sd, uint32_t pos) {
    if (sd) xSemaphoreTake(sdMutex, portMAX_DELAY);
    f.seek(pos);
    if (sd) xSemaphoreGive(sdMutex);
}

void loudTask(void*) {
    String path = loudJobPath;
    bool sd = loudJobSd;
    File f = sd ? SD.open(path.c_str(), FILE_READ) : LittleFS.open(path, FILE_READ);
    uint8_t* in = (uint8_t*)malloc(MIX_IN_BYTES);
    int32_t* out = (int32_t*)malloc(1152 * 2 * sizeof(int32_t));
    MP3Decoder* dec = nullptr;
    std::vector<float> blocks;
    float peak = 0;
    if (f && in && out && audio) {
        dec = new MP3Decoder(*audio);
        if (!dec->init()) {
            delete dec;
            dec = nullptr;
        }
    }
    if (dec) {
        uint8_t hdr[10];
        if (loudRead(f, sd, hdr, 10) == 10 && memcmp(hdr, "ID3", 3) == 0) {
            uint32_t sz = ((uint32_t)(hdr[6] & 0x7f) << 21) | ((uint32_t)(hdr[7] & 0x7f) << 14) | ((uint32_t)(hdr[8] & 0x7f) << 7) | (uint32_t)(hdr[9] & 0x7f);
            loudSeek(f, sd, 10 + sz);
        } else {
            loudSeek(f, sd, 0);
        }
        int have = 0;
        bool eof = false;
        int errors = 0;
        uint32_t blockLen = 0;
        uint32_t inBlock = 0;
        double acc = 0;
        int frameCount = 0;
        while (audio) {
            if (have < MIX_REFILL_BELOW && !eof) {
                int n = loudRead(f, sd, in + have, MIX_IN_BYTES - have);
                if (n <= 0) eof = true;
                else have += n;
            }
            if (have < 4) break;
            int32_t sync = dec->findSyncWord(in, have);
            if (sync < 0) {
                have = 0;
                if (eof) break;
                continue;
            }
            if (sync > 0) {
                memmove(in, in + sync, have - sync);
                have -= sync;
            }
            int32_t left = have;
            int32_t res = dec->decode(in, &left, out);
            int used = have - left;
            if (res == 0) {
                uint32_t frames = dec->getOutputSamples();
                if (frames > 1152) frames = 1152;
                if (blockLen == 0 && frames > 0) blockLen = dec->getSampleRate() * 4 / 10;
                for (uint32_t i = 0; i < frames && blockLen > 0; i++) {
                    float l = (float)(out[2 * i] >> 16) / 32768.0f;
                    float r = (float)(out[2 * i + 1] >> 16) / 32768.0f;
                    float a = fabsf(l) > fabsf(r) ? fabsf(l) : fabsf(r);
                    if (a > peak) peak = a;
                    acc += 0.5 * ((double)l * l + (double)r * r);
                    if (++inBlock >= blockLen) {
                        blocks.push_back((float)(acc / blockLen));
                        acc = 0;
                        inBlock = 0;
                    }
                }
                errors = 0;
            } else if (++errors > 100) {
                break;
            }
            if (used <= 0) used = 1;
            if (used > have) used = have;
            have -= used;
            if (have > 0) memmove(in, in + used, have);
            if ((++frameCount & 3) == 0) vTaskDelay(1);
        }
    }
    if (dec) delete dec;
    if (f) f.close();
    free(in);
    free(out);

    // Gate: absolut -60 dBFS, relativ 10 dB unter dem Mittel der Bloecke ueber dem absoluten Gate.
    // Gate: absolute -60 dBFS, relative 10 dB below the mean of the blocks above the absolute gate.

    loudResultOk = false;
    if (blocks.size() >= 3 && peak > 0.0001f) {
        double sum = 0;
        int n = 0;
        for (size_t i = 0; i < blocks.size(); i++) {
            if (blocks[i] > 1e-6f) {
                sum += blocks[i];
                n++;
            }
        }
        if (n > 0) {
            double mean1 = sum / n, sum2 = 0;
            int n2 = 0;
            for (size_t i = 0; i < blocks.size(); i++) {
                if (blocks[i] > 1e-6f && blocks[i] > mean1 * 0.1) {
                    sum2 += blocks[i];
                    n2++;
                }
            }
            double mean = n2 > 0 ? sum2 / n2 : mean1;
            float rmsDb = 10.0f * log10f((float)mean);
            float peakDb = 20.0f * log10f(peak);
            float gain = LOUD_TARGET_DB - rmsDb;
            if (gain > -peakDb - 1.0f) gain = -peakDb - 1.0f;
            if (gain > 12.0f) gain = 12.0f;
            if (gain < -18.0f) gain = -18.0f;
            loudResultDb10 = (int)lroundf(gain * 10.0f);
            loudResultRms = rmsDb;
            loudResultPeak = peakDb;
            loudResultOk = true;
        }
    }
    loudDone = true;
    loudBusy = false;
    vTaskDelete(nullptr);
}

void loudStartJob(const String& path, bool sd, uint32_t key) {
    loudJobPath = path;
    loudJobSd = sd;
    loudJobKey = key;
    loudDone = false;
    loudBusy = true;
    if (xTaskCreatePinnedToCore(loudTask, "loudness", 12288, nullptr, 1, nullptr, 0) != pdPASS) loudBusy = false;
}

void loudRequest(const String& path, bool sd, uint32_t key) {
    if (loudBusy || loudDone) {
        loudPend = true;
        loudPendPath = path;
        loudPendSd = sd;
        loudPendKey = key;
        return;
    }
    loudStartJob(path, sd, key);
}

// Beim Start einer Datei: bekannten Ausgleich sofort setzen, sonst im Hintergrund messen; Ansagen und Radio bleiben ohne Ausgleich.
// At the start of a file: set a known correction at once, otherwise measure in the background; announcements and radio stay uncorrected.

void loudBegin(const String& path, bool sd) {
    fileGainOn = false;
    fileGainQ15 = 32768;
    fileGainCurDb = 0.0f;
    fileGainTargetDb = 0.0f;
    fileGainKnown = false;
    loudCurKey = 0;
    if (!cfg.loudNorm) return;
    File f = sd ? SD.open(path.c_str(), FILE_READ) : LittleFS.open(path, FILE_READ);
    size_t size = f ? f.size() : 0;
    if (f) f.close();
    if (size == 0) return;
    loudCurKey = loudKey(path, sd, size);
    int db10 = 0;
    if (loudFind(loudCurKey, db10)) {
        fileGainTargetDb = db10 / 10.0f;
        fileGainCurDb = fileGainTargetDb;
        fileGainQ15 = loudQ15(fileGainCurDb);
        fileGainOn = true;
        fileGainKnown = true;
        logLine("[LOUD] " + path + ": gain " + String(fileGainCurDb, 1) + " dB (stored)");
    } else {
        loudRequest(path, sd, loudCurKey);
    }
}

// Laeuft in der Hauptschleife: Ergebnis des Messens uebernehmen, den Ausgleich sanft nachfuehren, ausserhalb einer Datei abschalten.
// Runs in the main loop: take over the result of the measurement, follow the correction gently, switch off outside of a file.

void loudWatch() {
    if (loudDone && !loudBusy) {
        loudDone = false;
        if (loudResultOk) {
            loudAdd(loudJobKey, loudResultDb10);
            logLine("[LOUD] " + loudJobPath + ": level " + String(loudResultRms, 1) + " dBFS, peak " + String(loudResultPeak, 1) + " dBFS, gain " + String(loudResultDb10 / 10.0f, 1) + " dB");
            if (loudJobKey == loudCurKey && cfg.loudNorm) {
                fileGainTargetDb = loudResultDb10 / 10.0f;
                fileGainKnown = true;
                fileGainOn = true;
            }
        } else {
            logLine("[LOUD] " + loudJobPath + ": not measurable");
        }
    }
    if (!loudBusy && !loudDone && loudPend) {
        loudPend = false;
        loudStartJob(loudPendPath, loudPendSd, loudPendKey);
    }
    bool fileNow = nowKind == "file" && playState == PS_PLAYING;
    if (!fileNow || !cfg.loudNorm) {
        if (fileGainOn) {
            fileGainOn = false;
            fileGainQ15 = 32768;
            fileGainCurDb = 0.0f;
        }
        return;
    }
    static unsigned long last = 0;
    if (millis() - last < 40) return;
    last = millis();
    float d = fileGainTargetDb - fileGainCurDb;
    if (fabsf(d) < 0.01f) return;
    if (d > 0.25f) d = 0.25f;
    if (d < -0.25f) d = -0.25f;
    fileGainCurDb += d;
    fileGainQ15 = loudQ15(fileGainCurDb);
}

// Ein- und Ausblenden einer MP3-Datei (nicht einer Ansage), die ohne Radio ueber den Audio-Weg laeuft. Die Dauer ist die Einstellung
// "Radio aus-/einblenden", bei kurzen Dateien hoechstens ein Viertel der geschaetzten Laenge.
// Fade-in and fade-out of an MP3 file (not of an announcement) that plays through the audio path without radio. The duration is the
// setting "Radio aus-/einblenden", for short files at most a quarter of the estimated length.

int fileFadeMs = 0;
bool fileFadeOutDone = false;

void fileFadePrepare(const String& path, bool sd) {
    fileFadeOutDone = false;
    fileFadeMs = 0;
    if (cfg.fadeMs <= 0 || !audio) return;
    File f = sd ? SD.open(path.c_str(), FILE_READ) : LittleFS.open(path, FILE_READ);
    size_t size = f ? f.size() : 0;
    if (f) f.close();
    int ms = cfg.fadeMs;
    if (size > 0) {
        int cap = (int)(size / 16) / 4;
        if (cap < 80) cap = 80;
        if (ms > cap) ms = cap;
    }
    fileFadeMs = ms;
    audio->setVolume(0);
    volRamp.on = false;
    volRamp.now = 0;
}

void fileFadeStart() {
    if (fileFadeMs > 0 && audio) volRampTo(currentVolume * VOL_FINE, fileFadeMs);
}

void fileFadeWatch() {
    if (fileFadeMs <= 0 || fileFadeOutDone || !audio || playState != PS_PLAYING || nowKind != "file") return;
    if (millis() - playStartMillis < 300) return;
    uint32_t size = audio->getFileSize();
    uint32_t pos = audio->getAudioFilePosition();
    uint32_t bitrate = audio->getBitRate();
    if (size == 0 || bitrate < 8000) return;
    if (pos < size / 2) return;
    uint32_t bytesLeft = size > pos ? size - pos : 0;
    uint32_t remainMs = (uint32_t)((uint64_t)bytesLeft * 8000ULL / bitrate);
    if (remainMs <= (uint32_t)fileFadeMs) {
        fileFadeOutDone = true;
        volRampTo(0, remainMs > 60 ? (int)remainMs : 60);
    }
}

static void startFileImpl(String name, bool keepMix) {
    FileRef r = resolveFile(name);
    if (!r.ok) {
        failPlayback(String(r.sd && !sdReady ? "SD card not available: " : "File not found: ") + r.path);
        return;
    }
    String path = r.path;
    if (keepMix) {   // laufende Mischspur und Ausgabe bleiben / the running mix track and the output stay
        silenceCarrier = false;
        titleBoostEnd();
    } else {
        stopPlayback();
    }
    lastError = "";
    ensureAudio();
    fileFadePrepare(path, r.sd);
    fs::FS& useFs = r.sd ? (fs::FS&)SD : (fs::FS&)LittleFS;
    if (keepMix ? audio->connecttoFSkeep(useFs, path.c_str()) : audio->connecttoFS(useFs, path.c_str())) {
        fileFadeStart();
        loudBegin(path, r.sd);
        playStartMillis = millis();
        playState = PS_PLAYING;
        nowKind = "file";
        nowFile = r.shown;
        logLine("[PLAY] file " + (r.sd ? "sd:" : String()) + path);
        publishStatus(true);
    } else {
        failPlayback("Cannot play file " + path);
    }
}

void startFile(String name) {
    startFileImpl(name, false);
}

void startUrl(const String& url) {
    resumeUrl = "";
    if (!url.startsWith("http://") && !url.startsWith("https://")) {
        failPlayback("URL must start with http:// or https://");
        return;
    }
    if (WiFi.status() != WL_CONNECTED) {
        failPlayback("No WiFi connection");
        return;
    }
    stopPlayback();
    lastError = "";
    playState = PS_LOADING;
    loadStartMillis = millis();
    publishStatus(true);
    ensureAudio();
    if (audio->connecttohost(url.c_str())) {
        playStartMillis = millis();
        playState = PS_PLAYING;
        streamUrl = url;
        streamActive = true;
        streamWaitingReady = true;
        streamWaitSince = millis();
        streamLastFill = 0;
        nowKind = "radio";
        agcResetReq = true;
        nowName = "";
        nowTitle = "";
        nowGenre = "";
        nowDesc = "";
        nowWeb = "";
        nowLogo = "";
        nowHost = "";
        nowBitrate = 0;
        titleQn = 0;
        titleBoost = false;
        logLine("[PLAY] url " + url);
        publishStatus(true);
    } else {
        failPlayback("Cannot open URL");
    }
}

// Laedt den Sprachtext von VoiceRSS als MP3 nach TTS_FILE. VoiceRSS meldet Fehler (falscher Schluessel, Limit) als Text
// "ERROR: ..." mit HTTP 200, deshalb wird der Dateianfang geprueft.

// Downloads the speech from VoiceRSS as MP3 to TTS_FILE. VoiceRSS reports errors (wrong key, limit) as text
// "ERROR: ..." with HTTP 200, so the start of the file is checked.

bool downloadSpeech(const String& url, String& errorOut) {
    WiFiClientSecure client;
    client.setInsecure();
    HTTPClient http;

    // HTTP/1.0 vermeidet "chunked"-Antworten; so laesst sich die Datei selbst lesen, mit Zeitlimit und Watchdog.
    // HTTP/1.0 avoids "chunked" responses; this way the file can be read by hand, with a deadline and the watchdog.

    http.useHTTP10(true);
    http.setTimeout(TTS_HTTP_TIMEOUT_MS);
    http.setConnectTimeout(TTS_HTTP_TIMEOUT_MS);
    if (!http.begin(client, url)) {
        errorOut = "HTTP begin failed";
        return false;
    }
    esp_task_wdt_reset();
    int code = http.GET();
    esp_task_wdt_reset();
    if (code != HTTP_CODE_OK) {
        errorOut = "VoiceRSS HTTP " + String(code) + (code < 0 ? " (" + http.errorToString(code) + ")" : "");
        http.end();
        return false;
    }
    LittleFS.remove(TTS_FILE);
    File f = LittleFS.open(TTS_FILE, FILE_WRITE);
    if (!f) {
        errorOut = "Cannot write " TTS_FILE;
        http.end();
        return false;
    }
    int total = http.getSize();
    NetworkClient* stream = http.getStreamPtr();
    // Der Puffer liegt auf dem Heap: der Stapel der Hauptschleife wird beim TLS-Verbindungsaufbau schon stark gebraucht.
    // The buffer lives on the heap: the stack of the main loop is already heavily used during the TLS handshake.

    uint8_t* buf = (uint8_t*)malloc(1024);
    if (!buf) {
        errorOut = "Out of memory";
        f.close();
        http.end();
        return false;
    }
    size_t written = 0;
    unsigned long start = millis();
    unsigned long lastData = millis();
    bool ok = true;
    while (http.connected() || stream->available() > 0) {
        esp_task_wdt_reset();
        int avail = stream->available();
        if (avail > 0) {
            int n = stream->readBytes(buf, avail > 1024 ? 1024 : avail);
            if (n <= 0) continue;
            if (f.write(buf, n) != (size_t)n) {
                errorOut = "Flash full or write error";
                ok = false;
                break;
            }
            written += n;
            lastData = millis();
            if (written > TTS_MAX_BYTES) {
                errorOut = "Response too large";
                ok = false;
                break;
            }
            if (total >= 0 && written >= (size_t)total) break;
        } else {
            if (total >= 0 && written >= (size_t)total) break;
            if (millis() - lastData > TTS_HTTP_TIMEOUT_MS) {
                errorOut = "Download stalled";
                ok = false;
                break;
            }
            delay(5);
        }
        if (millis() - start > TTS_DEADLINE_MS) {
            errorOut = "Download too slow";
            ok = false;
            break;
        }
    }
    free(buf);
    f.close();
    http.end();
    esp_task_wdt_reset();
    if (!ok) return false;
    if (written == 0) {
        errorOut = "Empty response";
        return false;
    }
    File r = LittleFS.open(TTS_FILE, FILE_READ);
    char head[96];
    size_t n = r ? r.readBytes(head, sizeof(head) - 1) : 0;
    if (r) r.close();
    head[n] = 0;
    if (n >= 5 && strncmp(head, "ERROR", 5) == 0) {
        errorOut = String(head);
        errorOut.trim();
        return false;
    }
    return true;
}

// Baut die Anfrage-URL fuer VoiceRSS aus Text, Sprache, Stimme und Geschwindigkeit.
// Builds the request URL for VoiceRSS from text, language, voice and rate.

String buildSpeechUrl(const Pending& p) {
    String lang = p.lang.length() > 0 ? p.lang : cfg.vlang;
    String voice = p.voice.length() > 0 ? p.voice : cfg.vvoice;
    int rate = p.rate != 99 ? p.rate : cfg.vrate;
    if (rate < -10) rate = -10;
    if (rate > 10) rate = 10;
    String url = "https://api.voicerss.org/?key=" + urlEncode(cfg.vkey) + "&hl=" + urlEncode(lang) + "&r=" + String(rate) +
                 "&c=MP3&f=" + urlEncode(cfg.vfmt) + "&src=" + urlEncode(p.text);
    if (voice.length() > 0) url += "&v=" + urlEncode(voice);
    logLine("[VOICERSS] free heap " + String(ESP.getFreeHeap()) + ", request lang=" + lang + " voice=" + voice + " chars=" + String(p.text.length()));
    return url;
}

// Gespeicherte Ansagen und Zwischenspeicher: Eine einmal von VoiceRSS geholte Sprachdatei kann lokal liegen und wird dann ohne VoiceRSS-Anfrage gespielt.
// Der Dateiname besteht aus einem Hinweis auf den Text und einer Pruefsumme ueber Text, Sprache, Stimme, Tempo und Format
// (zum Beispiel Achtung_auf_Gleis_3_3fa9c2e1.mp3). Gesucht wird in dieser Reihenfolge: gespeicherte Texte auf der SD-Karte (/ansagen),
// gespeicherte Texte im Flash (im Ordner der MP3-Dateien) und, wenn eingeschaltet, der Zwischenspeicher der SD-Karte (/tts).
// Saved announcements and cache: a speech file fetched once from VoiceRSS can be kept locally and is then played without a VoiceRSS request.
// The file name consists of a hint about the text and a checksum over text, language, voice, rate and format
// (for example Achtung_auf_Gleis_3_3fa9c2e1.mp3). The search order is: saved texts on the SD card (/ansagen), saved texts in flash
// (in the folder of the MP3 files) and, if switched on, the cache of the SD card (/tts).

#define TTS_CACHE_DIR "/tts"
#define TTS_CACHE_MAX 500
#define TTS_SAVE_DIR "/ansagen"
#define TTS_FLASH_SUB "ansagen"   // Unterordner im Flash: /mp3/ansagen / subfolder in flash: /mp3/ansagen
#define TTS_FLASH_RESERVE 65536UL

static String ttsBase(const Pending& p) {
    String lang = p.lang.length() > 0 ? p.lang : cfg.vlang;
    String voice = p.voice.length() > 0 ? p.voice : cfg.vvoice;
    int rate = p.rate != 99 ? p.rate : cfg.vrate;
    if (rate < -10) rate = -10;
    if (rate > 10) rate = 10;
    String key = lang + "|" + voice + "|" + String(rate) + "|" + cfg.vfmt + "|" + p.text;
    uint32_t h = 2166136261UL;
    for (size_t i = 0; i < key.length(); i++) {
        h ^= (uint8_t)key[i];
        h *= 16777619UL;
    }
    char hex[9];
    snprintf(hex, sizeof(hex), "%08x", (unsigned)h);
    String hint = sdCleanName(p.text.substring(0, 60), false);
    hint.replace(".", "");
    if (hint.length() > 40) hint = hint.substring(0, 40);
    while (hint.endsWith("_") || hint.endsWith("-")) hint.remove(hint.length() - 1);
    while (hint.startsWith("_") || hint.startsWith("-")) hint.remove(0, 1);
    if (hint.isEmpty()) hint = "speech";
    return hint + "_" + String(hex);
}

static String ttsName(const Pending& p) {
    return ttsBase(p) + ".mp3";
}

// Effektwerte im Dateinamen: _halle40_b3_t-2 (Effekt mit Anteil, Bass, Hoehen); ohne Effekt und ohne Klangregler bleibt der Name ohne Zusatz.
// Effect values in the file name: _halle40_b3_t-2 (effect with amount, bass, treble); without effect and tone control the name has no addition.

static const char* const FX_NAMES[] = {"aus", "zimmer", "halle", "kirche", "echo"};

static String ttsFxSuffix(const FxParams& f) {
    if (f.mode == 0 && f.bass == 0 && f.treble == 0 && f.pan == 0) return "";
    String s = String("_") + FX_NAMES[f.mode];
    if (f.mode != 0) s += String(f.wet);
    if (f.bass != 0) s += "_b" + String(f.bass);
    if (f.treble != 0) s += "_t" + String(f.treble);
    if (f.pan >= 1 && f.pan <= 3) s += String("_w") + String("lrp"[f.pan - 1]) + String(f.panDs);
    return s;
}

static FxParams ttsFxParse(const String& suf) {
    FxParams f{0, 0, 0, 0};
    int i = 0;
    while (i < (int)suf.length()) {
        int e = suf.indexOf('_', i + 1);
        if (e < 0) e = suf.length();
        String tok = suf.substring(i + 1, e);
        i = e;
        if (tok.length() >= 2 && tok[0] == 'b' && (isdigit(tok[1]) || tok[1] == '-')) {
            f.bass = constrain(tok.substring(1).toInt(), -12, 12);
        } else if (tok.length() >= 2 && tok[0] == 't' && (isdigit(tok[1]) || tok[1] == '-')) {
            f.treble = constrain(tok.substring(1).toInt(), -12, 12);
        } else if (tok.length() >= 3 && tok[0] == 'w' && (tok[1] == 'l' || tok[1] == 'r' || tok[1] == 'p') && isdigit(tok[2])) {
            f.pan = tok[1] == 'l' ? 1 : (tok[1] == 'r' ? 2 : 3);
            f.panDs = constrain(tok.substring(2).toInt(), 5, 200);
        } else {
            for (int m = 0; m < 5; m++) {
                String n = FX_NAMES[m];
                if (tok.startsWith(n)) {
                    f.mode = m;
                    f.wet = constrain(tok.substring(n.length()).toInt(), 0, 100);
                    break;
                }
            }
        }
    }
    return f;
}

static void ttsSaveFail(const String& de, const String& logEn) {
    ttsSaveErr = de;
    ttsSaveErrN++;
    logLine("[VOICERSS] " + logEn);
}

// Die Effektwerte, die ein jetzt gespeicherter Text bekommt: die aktuellen Einstellungen, ohne Effekt bei fx=0.
// The effect values a text saved now gets: the current settings, without effect for fx=0.

static FxParams fxGlobalParams() {
    return FxParams{cfg.fxMode, cfg.fxWet, cfg.eqBass, cfg.eqTreble, cfg.panMode, cfg.panDs};
}

// Effektwerte fuer Dateien: wie die allgemeinen, aber ohne Hall und Echo (zu rechenintensiv, vor allem mit zwei Spuren); Klangregler und Wandern gelten.
// Effect values for files: like the general ones, but without reverb and echo (too computing-intensive, especially with two tracks); tone control and sweep apply.

static FxParams fxFileParams() {
    FxParams f = fxGlobalParams();
    f.mode = 0;
    f.wet = 0;
    return f;
}

// Effektwerte einer Datei mit den Werten des Aufrufs (pan, pansec) statt der allgemeinen Stereo-Einstellung.
// Effect values of a file with the values of the call (pan, pansec) instead of the general stereo setting.

// Effektwerte aus dem Namen einer gespeicherten Ansage (Name_<8 Zeichen Pruefsumme>_halle40_b3.mp3); false, wenn der Name keine Effektangaben hat.
// Effect values from the name of a saved announcement (Name_<8 characters checksum>_halle40_b3.mp3); false if the name has no effect values.

static bool fileNameFx(const String& name, FxParams& out) {
    String n = name.substring(name.lastIndexOf('/') + 1);
    String l = n;
    l.toLowerCase();
    if (!l.endsWith(".mp3")) return false;
    n = n.substring(0, n.length() - 4);
    for (int i = (int)n.length() - 9; i >= 0; i--) {
        if (n[i] != '_') continue;
        bool hex = true;
        for (int k = 1; k <= 8; k++) {
            if (!isxdigit((unsigned char)n[i + k])) hex = false;
        }
        if (!hex || (i + 9 < (int)n.length() && n[i + 9] != '_')) continue;
        String suf = n.substring(i + 9);
        if (suf.isEmpty()) return false;
        out = ttsFxParse(suf);
        return true;
    }
    return false;
}

static FxParams fxFileParamsFor(const Pending& p) {
    FxParams f = fxFileParams();
    FxParams nm{0, 0, 0, 0};
    if (fileNameFx(p.text, nm)) f = nm;
    if (p.pan >= 0) f.pan = p.pan;
    if (p.panDs >= 0) f.panDs = p.panDs;
    return f;
}

static FxParams ttsFxCurrent(const Pending& p) {
    return p.noFx ? FxParams{0, 0, 0, 0} : fxGlobalParams();
}

// Stellt die Effekt-Instanz der Ansagen auf die Werte der naechsten Ansage ein.
// Sets the effect instance of the announcements to the values of the next announcement.

static void annSetParams(const FxParams& f) {
    annFx.mode = f.mode;
    annFx.wet = f.wet;
    annFx.bass = f.bass;
    annFx.treble = f.treble;
    annFx.pan = f.pan;
    annFx.panDs = f.panDs;
    annFx.flush();
}

static bool ttsCacheOn() {
    return cfg.ttsCache && sdReady;
}

static bool ttsSdHas(const String& path) {
    if (!sdReady) return false;
    if (xSemaphoreTake(sdMutex, pdMS_TO_TICKS(2000)) != pdTRUE) return false;
    bool ok = SD.exists(path.c_str());
    xSemaphoreGive(sdMutex);
    return ok;
}

// Fundort einer Sprachdatei: 0 = nirgends, 1 = gespeichert auf der Karte, 2 = gespeichert im Flash, 3 = Zwischenspeicher der Karte.
// Location of a speech file: 0 = nowhere, 1 = saved on the card, 2 = saved in flash, 3 = cache of the card.

// Sucht eine gespeicherte Datei mit dem Namensanfang base: base.mp3 oder base_<Effektangaben>.mp3; liefert den ganzen Namen oder leer.
// Looks for a saved file starting with the name base: base.mp3 or base_<effect values>.mp3; returns the whole name or empty.

static String ttsFindSaved(bool sd, const String& dir, const String& base) {
    String found;
    if (sd) {
        if (!sdReady) return "";
        if (xSemaphoreTake(sdMutex, pdMS_TO_TICKS(2000)) != pdTRUE) return "";
    } else if (!fsReady) {
        return "";
    }
    File d = sd ? SD.open(dir.c_str()) : LittleFS.open(dir);
    if (d && d.isDirectory()) {
        File e = d.openNextFile();
        while (e) {
            String n = String(e.name());
            n = n.substring(n.lastIndexOf('/') + 1);
            e.close();
            String l = n;
            l.toLowerCase();
            if (n.startsWith(base) && l.endsWith(".mp3") && n.length() > base.length() && (n[base.length()] == '.' || n[base.length()] == '_')) {
                found = n;
                break;
            }
            esp_task_wdt_reset();
            e = d.openNextFile();
        }
    }
    if (d) d.close();
    if (sd) xSemaphoreGive(sdMutex);
    return found;
}

static TtsLoc ttsLocate(const Pending& p) {
    TtsLoc r{0, "", ""};
    String base = ttsBase(p);
    String n = ttsFindSaved(true, TTS_SAVE_DIR, base);
    if (!n.isEmpty()) return TtsLoc{1, String(TTS_SAVE_DIR) + "/" + n, n.substring(base.length(), n.length() - 4)};
    String fdir = String(MP3_DIR) + "/" + TTS_FLASH_SUB;
    n = ttsFindSaved(false, fdir, base);
    if (!n.isEmpty()) return TtsLoc{2, fdir + "/" + n, n.substring(base.length(), n.length() - 4)};

    // Aeltere Texte liegen noch im Ordner der MP3-Dateien selbst.
    // Older texts still lie in the folder of the MP3 files itself.

    n = ttsFindSaved(false, MP3_DIR, base);
    if (!n.isEmpty()) return TtsLoc{2, String(MP3_DIR) + "/" + n, n.substring(base.length(), n.length() - 4)};
    if (cfg.ttsCache) {
        String c = String(TTS_CACHE_DIR) + "/" + ttsName(p);
        if (ttsSdHas(c)) return TtsLoc{3, c, ""};
    }
    return r;
}

// Kopiert eine Datei zwischen Flash und Karte; bei der Karte haelt der Aufrufer die Sperre.
// Copies a file between flash and card; for the card the caller holds the lock.

static size_t ttsCopy(File& src, File& dst) {
    uint8_t* buf = (uint8_t*)malloc(1024);
    if (!buf) return 0;
    size_t total = 0;
    while (src.available()) {
        int n = src.read(buf, 1024);
        if (n <= 0) break;
        if (dst.write(buf, n) != (size_t)n) {
            total = 0;
            break;
        }
        total += n;
        esp_task_wdt_reset();
    }
    free(buf);
    return total;
}

static bool ttsRestore(const TtsLoc& loc) {
    bool sd = loc.kind == 1 || loc.kind == 3;
    if (sd && xSemaphoreTake(sdMutex, pdMS_TO_TICKS(3000)) != pdTRUE) return false;
    size_t n = 0;
    File src = sd ? SD.open(loc.path.c_str(), FILE_READ) : LittleFS.open(loc.path, FILE_READ);
    if (src) {
        LittleFS.remove(TTS_FILE);
        File dst = LittleFS.open(TTS_FILE, FILE_WRITE);
        if (dst) {
            n = ttsCopy(src, dst);
            dst.close();
        }
        src.close();
    }
    if (sd) xSemaphoreGive(sdMutex);
    if (n == 0) {
        LittleFS.remove(TTS_FILE);
        return false;
    }
    const char* from = loc.kind == 1 ? "saved text on SD card" : (loc.kind == 2 ? "saved text in flash" : "cache");
    logLine("[VOICERSS] from " + String(from) + " " + loc.path.substring(loc.path.lastIndexOf('/') + 1));
    return true;
}

// Haelt hoechstens TTS_CACHE_MAX Dateien: die aeltesten (nach Schreibzeit) werden geloescht; der Aufrufer haelt die Sperre.
// Keeps at most TTS_CACHE_MAX files: the oldest ones (by write time) are deleted; the caller holds the lock.

static void ttsCachePrune() {
    struct Ent {
        String name;
        time_t t;
    };
    std::vector<Ent> list;
    File d = SD.open(TTS_CACHE_DIR);
    if (!d || !d.isDirectory()) {
        if (d) d.close();
        return;
    }
    File e = d.openNextFile();
    while (e && list.size() < 2000) {
        if (!e.isDirectory()) {
            String n = String(e.name());
            list.push_back(Ent{n.substring(n.lastIndexOf('/') + 1), e.getLastWrite()});
        }
        e.close();
        esp_task_wdt_reset();
        e = d.openNextFile();
    }
    if (e) e.close();
    d.close();
    if ((int)list.size() <= TTS_CACHE_MAX) return;
    std::sort(list.begin(), list.end(), [](const Ent& a, const Ent& b) { return a.t < b.t; });
    int drop = (int)list.size() - TTS_CACHE_MAX;
    for (int i = 0; i < drop; i++) {
        SD.remove((String(TTS_CACHE_DIR) + "/" + list[i].name).c_str());
        esp_task_wdt_reset();
    }
    logLine("[VOICERSS] cache pruned, " + String(drop) + " old files removed");
}

// Legt TTS_FILE auf der Karte ab: im Zwischenspeicher (dir = /tts) oder als gespeicherten Text (dir = /ansagen).
// Stores TTS_FILE on the card: in the cache (dir = /tts) or as a saved text (dir = /ansagen).

static bool ttsStoreSd(const String& dir, const String& name, bool prune) {
    if (!sdReady) return false;
    String path = dir + "/" + name;
    if (xSemaphoreTake(sdMutex, pdMS_TO_TICKS(3000)) != pdTRUE) return false;
    bool ok = false;
    File src = LittleFS.open(TTS_FILE, FILE_READ);
    if (src) {
        if (!SD.exists(dir.c_str())) SD.mkdir(dir.c_str());
        SD.remove(path.c_str());
        File dst = SD.open(path.c_str(), FILE_WRITE);
        size_t n = 0;
        if (dst) {
            n = ttsCopy(src, dst);
            dst.close();
        }
        if (n == 0) {
            SD.remove(path.c_str());
        } else {
            ok = true;
            if (prune) ttsCachePrune();
        }
        src.close();
    }
    xSemaphoreGive(sdMutex);
    return ok;
}

static void ttsCacheStore(const Pending& p) {
    if (!ttsCacheOn()) return;
    String name = ttsName(p);
    if (ttsStoreSd(TTS_CACHE_DIR, name, true)) logLine("[VOICERSS] stored in cache " + name);
    else logLine("[VOICERSS] could not store in cache");
}

// Speichert den Text dauerhaft: bevorzugt auf der SD-Karte, sonst im Flash (Unterordner ansagen der MP3-Dateien, sichtbar im Tab MP3 (Flash)).
// Saves the text permanently: preferably on the SD card, otherwise in flash (subfolder ansagen of the MP3 files, visible in the MP3 (Flash) tab).

static void ttsSaveText(const Pending& p, const FxParams& fxp) {
    String name = ttsBase(p) + ttsFxSuffix(fxp) + ".mp3";
    if (sdReady) {
        if (ttsStoreSd(TTS_SAVE_DIR, name, false)) logLine("[VOICERSS] text saved on SD card " + name);
        else ttsSaveFail("Text konnte nicht auf der SD-Karte gespeichert werden", "text could not be saved on SD card");
        return;
    }
    if (!fsReady) {
        ttsSaveFail("Text nicht gespeichert: kein Speicher verf\xC3\xBCgbar", "text not saved: no storage");
        return;
    }
    File src = LittleFS.open(TTS_FILE, FILE_READ);
    if (!src) return;
    size_t size = src.size();
    size_t freeB = LittleFS.totalBytes() - LittleFS.usedBytes();
    if (freeB < size + TTS_FLASH_RESERVE) {
        src.close();
        ttsSaveFail("Text nicht gespeichert: Flash voll (mindestens 64 KB m\xC3\xBCssen frei bleiben)", "text not saved: flash is full (at least 64 KB must stay free)");
        return;
    }
    String fdir = String(MP3_DIR) + "/" + TTS_FLASH_SUB;
    if (!LittleFS.exists(fdir)) LittleFS.mkdir(fdir);
    String path = fdir + "/" + name;
    LittleFS.remove(path);
    File dst = LittleFS.open(path, FILE_WRITE);
    size_t n = 0;
    if (dst) {
        n = ttsCopy(src, dst);
        dst.close();
    }
    src.close();
    if (n == 0) {
        LittleFS.remove(path);
        ttsSaveFail("Text konnte nicht im Flash gespeichert werden", "text could not be saved in flash");
    } else {
        logLine("[VOICERSS] text saved in flash " + name);
    }
}

// Anzahl und Groesse der Dateien im Zwischenspeicher; mit clear werden sie geloescht (Rueckgabe: Anzahl vorher).
// Number and size of the files in the cache; with clear they are deleted (returns the number before).

int ttsCacheInfo(uint32_t& bytes, bool clear) {
    bytes = 0;
    if (!sdReady) return 0;
    if (xSemaphoreTake(sdMutex, pdMS_TO_TICKS(3000)) != pdTRUE) return 0;
    int count = 0;
    std::vector<String> names;
    File d = SD.open(TTS_CACHE_DIR);
    if (d && d.isDirectory()) {
        File e = d.openNextFile();
        while (e) {
            if (!e.isDirectory()) {
                String n = String(e.name());
                names.push_back(n.substring(n.lastIndexOf('/') + 1));
                bytes += (uint32_t)e.size();
                count++;
            }
            e.close();
            esp_task_wdt_reset();
            e = d.openNextFile();
        }
    }
    if (d) d.close();
    if (clear) {
        for (size_t i = 0; i < names.size(); i++) {
            SD.remove((String(TTS_CACHE_DIR) + "/" + names[i]).c_str());
            esp_task_wdt_reset();
        }
    }
    xSemaphoreGive(sdMutex);
    return count;
}

// Holt die Sprachdatei nach TTS_FILE: von lokal gespeicherten Texten oder dem Zwischenspeicher, sonst von VoiceRSS.
// Mit p.save wird der Text danach dauerhaft gespeichert, sonst (Zwischenspeicher an) im Zwischenspeicher abgelegt.
// Fetches the speech file into TTS_FILE: from locally saved texts or the cache, otherwise from VoiceRSS.
// With p.save the text is then saved permanently, otherwise (cache on) stored in the cache.

static bool fetchSpeech(const Pending& p, String& err) {
    TtsLoc loc = ttsLocate(p);
    bool got = loc.kind != 0 && ttsRestore(loc);
    FxParams use = fxGlobalParams();
    if (got && loc.kind <= 2) use = ttsFxParse(loc.suffix);
    if (!got) {
        if (cfg.vkey.isEmpty()) {
            err = "VoiceRSS API key is not set";
            return false;
        }
        if (WiFi.status() != WL_CONNECTED) {
            err = "No WiFi connection";
            return false;
        }
        if (cfg.ttsCache || p.save) logLine("[VOICERSS] not stored locally, fetching from VoiceRSS");
        if (!downloadSpeech(buildSpeechUrl(p), err)) return false;
    }
    if (p.save) {
        // Neu speichern, wenn der Text noch nicht gespeichert ist oder mit anderen Effektwerten gespeichert war; die alte Datei entfaellt.
        // Save again if the text is not saved yet or was saved with other effect values; the old file is removed.

        FxParams cur = ttsFxCurrent(p);
        String curSuffix = ttsFxSuffix(cur);
        bool inPlace = loc.kind != 2 || loc.path.startsWith(String(MP3_DIR) + "/" + TTS_FLASH_SUB + "/");   // Texte im alten Ordner wandern in den Unterordner / texts in the old folder move to the subfolder
        if (!(got && loc.kind <= 2 && loc.suffix == curSuffix && inPlace)) {
            ttsSaveText(p, cur);
            if (got && loc.kind <= 2) {
                if (loc.kind == 1) {
                    if (xSemaphoreTake(sdMutex, pdMS_TO_TICKS(2000)) == pdTRUE) {
                        SD.remove(loc.path.c_str());
                        xSemaphoreGive(sdMutex);
                    }
                } else {
                    LittleFS.remove(loc.path);
                }
            }
        }
        use = cur;
    } else if (!got) {
        ttsCacheStore(p);
    }

    // fx=0: die Ansage laeuft ohne Effekt, auch wenn der Text mit Effekt gespeichert ist.
    // fx=0: the announcement plays without effect, even if the text is saved with an effect.

    if (p.noFx) use = FxParams{0, 0, 0, 0};
    speechFrom = got ? (loc.kind == 1 ? "sd" : (loc.kind == 2 ? "flash" : "cache")) : "voicerss";
    speechSeq++;
    logLine("[VOICERSS] announcement effect: " + String(use.mode ? FX_NAMES[use.mode] : "off") + (use.mode ? " " + String(use.wet) + " %" : "") + (use.bass || use.treble ? ", bass " + String(use.bass) + ", treble " + String(use.treble) : "") + (use.pan ? ", sweep " + String(use.pan) + " " + String(use.panDs / 10.0, 1) + " s" : "") + (p.noFx ? " (fx=0)" : ""));
    annSetParams(use);
    return true;
}

// Mischer: Eine Ansage oder MP3-Datei wird in einem eigenen Task dekodiert und im Audio-Task zum laufenden Webradio addiert.
// Das Radio laeuft ohne Unterbrechung weiter und ist waehrenddessen leiser (Ducking).
// Es gibt zwei Mischspuren: Spur 0 traegt eine Datei der SD-Karte ueber dem Radio, Spur 1 eine Ansage (Flash-MP3 oder Sprechen).
// Kommt eine Ansage, senkt sich Spur 0 ab und spielt danach weiter.
// Mixer: an announcement or MP3 file is decoded in its own task and added to the running web radio in the audio task.
// The radio keeps playing without interruption and is quieter meanwhile (ducking).
// There are two mix tracks: track 0 carries a file of the SD card over the radio, track 1 an announcement (flash MP3 or speech).
// When an announcement comes, track 0 is lowered and continues afterwards.

#define MIX_RING_FRAMES 16384
#define MIX_RING_MASK (MIX_RING_FRAMES - 1)

MixTrack mixT[2];

bool mixAny() {
    return mixT[0].inUse || mixT[1].inUse;
}

// Lautstaerkekurve der Audio-Bibliothek (VOLUME_MAX Stufen, -60 bis 0 dB), damit Ansage und Radio gleich laut klingen.
// Volume curve of the audio library (VOLUME_MAX steps, -60 to 0 dB), so announcement and radio sound equally loud.

int32_t mixGainFor(int vol) {
    if (vol <= 0) return 0;
    float t = (float)vol / (float)VOLUME_MAX;
    if (t > 1.0f) t = 1.0f;
    float dB = -112.0f * t * t * t + 172.0f * t * t - 60.0f;
    if (dB < -60.0f) dB = -60.0f;
    if (dB > 0.0f) dB = 0.0f;
    return (int32_t)(powf(10.0f, dB / 20.0f) * 32768.0f);
}

// Addiert eine Mischspur (umgerechnet auf die Rate des Radios) zu den Samples des Audio-Tasks.
// Adds one mix track (converted to the rate of the radio) to the samples of the audio task.

static void mixAddTrack(MixTrack& m, int32_t* buf, int16_t words) {
    if (!m.active) return;
    m.inHook = true;
    int16_t* ring = m.ring;
    uint32_t srcRate = m.srcRate;
    uint32_t outRate = m.outRate;
    if (!m.active || !ring || srcRate == 0 || outRate == 0) {
        m.inHook = false;
        return;
    }
    uint32_t step = (uint32_t)(((uint64_t)srcRate << 16) / outRate);
    uint32_t rd = m.rd.load(std::memory_order_relaxed);
    uint32_t wr = m.wr.load(std::memory_order_acquire);
    uint32_t phase = m.phase;
    int32_t g = m.gainQ15;

    // Spur 0 liegt vor der Stumm-Verstaerkung im Hauptstrom; die Ansage-Spur bekommt sie hier, wenn sie stumm geschaltet werden darf.
    // Track 0 lies before the mute gain in the main stream; the announcement track gets it here if it may be muted.

    if (&m != &mixT[MIX_LAYER] && m.muteIt) g = (int32_t)(((int64_t)g * muteGainQ15) >> 15);
    int frames = words / 2;
    for (int i = 0; i < frames; i++) {
        if (wr - rd < 2) {
            wr = m.wr.load(std::memory_order_acquire);
            if (wr - rd < 2) {
                if (m.producerDone) m.drained = true;
                else {
                    if (m.underFrames == 0) m.firstUnderAt = millis();
                    m.underFrames = m.underFrames + (uint32_t)(frames - i);
                }
                break;
            }
        }
        const int16_t* a = ring + (rd & MIX_RING_MASK) * 2;
        const int16_t* b = ring + ((rd + 1) & MIX_RING_MASK) * 2;
        int32_t frac = (int32_t)((phase & 0xFFFF) >> 2);
        int32_t l = a[0] + (((int32_t)b[0] - a[0]) * frac >> 14);
        int32_t r = a[1] + (((int32_t)b[1] - a[1]) * frac >> 14);
        int64_t sl = (int64_t)buf[2 * i] + (int64_t)((l * g) << 1);
        int64_t sr = (int64_t)buf[2 * i + 1] + (int64_t)((r * g) << 1);
        if (sl > INT32_MAX) sl = INT32_MAX;
        if (sl < INT32_MIN) sl = INT32_MIN;
        if (sr > INT32_MAX) sr = INT32_MAX;
        if (sr < INT32_MIN) sr = INT32_MIN;
        buf[2 * i] = (int32_t)sl;
        buf[2 * i + 1] = (int32_t)sr;
        phase += step;
        rd += phase >> 16;
        phase &= 0xFFFF;
    }
    m.phase = phase;
    m.rd.store(rd, std::memory_order_release);
    m.inHook = false;
}

// Lautstaerke der Webradios angleichen (AGC): misst den Pegel des Radiotons vor der Lautstaerke, fuehrt die Verstaerkung langsam auf den
// Zielpegel nach (hoch in etwa 5 s, runter in etwa 1 s) und haelt die Spitzen unter -1 dBFS. Nur fuer Webradio; Ansagen und Dateien bleiben unveraendert.
// Level matching of the web radios (AGC): measures the level of the radio sound before the volume, follows the gain slowly to the target
// level (up in about 5 s, down in about 1 s) and keeps the peaks below -1 dBFS. Only for web radio; announcements and files stay unchanged.

#define AGC_MAX_GAIN_DB 12.0f
#define AGC_MIN_GAIN_DB -12.0f

void audio_process_raw_samples(int32_t* buf, int16_t words) {
    static float levelMs = 0.0f, peak = 0.0f, gainDb = 0.0f;
    static uint32_t lastUs = 0;
    if (!agcActive) {
        gainDb = 0.0f;
        return;
    }
    if (agcResetReq) {
        agcResetReq = false;
        levelMs = 0.0f;
        peak = 0.0f;
        gainDb = 0.0f;
        lastUs = 0;
    }
    uint32_t now = micros();
    float dt = lastUs ? (now - lastUs) / 1000000.0f : 0.0f;
    lastUs = now;
    if (dt > 0.25f) dt = 0.25f;
    int n = words / 2;
    if (n <= 0) return;
    int64_t sum = 0;
    int32_t pk = 0;
    for (int i = 0; i < words; i++) {
        int32_t s = buf[i] >> 16;
        sum += (int64_t)s * s;
        int32_t a = s < 0 ? -s : s;
        if (a > pk) pk = a;
    }
    float ms = (float)sum / (float)words / 1073741824.0f;
    float pkf = pk / 32768.0f;
    if (ms > 1.0e-6f) {
        if (levelMs <= 0.0f) levelMs = ms;
        else levelMs += (ms - levelMs) * (dt > 0.0f ? (dt / 3.0f > 1.0f ? 1.0f : dt / 3.0f) : 0.0f);
    }
    peak = pkf > peak ? pkf : peak * (1.0f - (dt / 4.0f > 1.0f ? 1.0f : dt / 4.0f));
    if (levelMs > 0.0f) {
        float target = (float)cfg.agcDb - 10.0f * log10f(levelMs);
        if (target > AGC_MAX_GAIN_DB) target = AGC_MAX_GAIN_DB;
        if (target < AGC_MIN_GAIN_DB) target = AGC_MIN_GAIN_DB;
        if (peak > 0.01f) {
            float lim = -1.0f - 20.0f * log10f(peak);
            if (target > lim) target = lim;
        }
        float tau = target < gainDb ? 1.0f : 5.0f;
        float k = dt / tau;
        if (k > 1.0f) k = 1.0f;
        gainDb += (target - gainDb) * k;
    }
    agcGainShown = gainDb;
    if (fabsf(gainDb) < 0.05f) return;
    int32_t g = (int32_t)(powf(10.0f, gainDb / 20.0f) * 65536.0f);
    for (int i = 0; i < words; i++) {
        int64_t v = ((int64_t)buf[i] * g) >> 16;
        if (v > INT32_MAX) v = INT32_MAX;
        if (v < INT32_MIN) v = INT32_MIN;
        buf[i] = (int32_t)v;
    }
}

// Laeuft in der Hauptschleife: schaltet den Ausgleich nur waehrend eines Webradios ein.
// Runs in the main loop: switches the matching on only while a web radio plays.

void agcWatch() {
    bool on = cfg.radioAgc && nowKind == "radio" && playState == PS_PLAYING;
    if (on != agcActive) {
        agcResetReq = true;
        agcActive = on;
        if (!on) agcGainShown = 0.0f;
    }
}

// Belegung des NVS-Speichers (Eintraege); steht in /api/status, damit ein volles NVS auffaellt.
// Usage of the NVS memory (entries); shown in /api/status so a full NVS gets noticed.

uint32_t nvsUsedEntries() {
    nvs_stats_t st;
    return nvs_get_stats(NULL, &st) == ESP_OK ? st.used_entries : 0;
}

uint32_t nvsFreeEntries() {
    nvs_stats_t st;
    return nvs_get_stats(NULL, &st) == ESP_OK ? st.free_entries : 0;
}

// Stumm schalten: eine Verstaerkung, die sanft auf 0 faellt und wieder auf 1 steigt; die eingestellte Lautstaerke bleibt unveraendert.
// Sie wirkt auf Webradio, Text-Ansagen (Uhrzeit, Mail ...) und Dateien der SD-Karte; MP3 aus dem Flash bleiben hoerbar. Dauer: Lautstaerke-Rampe (mind. 300 ms).
// Mute: a gain that falls gently to 0 and rises to 1 again; the set volume stays unchanged. It acts on web radio, text announcements
// (time, mail ...) and files of the SD card; MP3 from the flash stay audible. Duration: the volume ramp (at least 300 ms).

// Gilt der Hauptstrom gerade als stumm schaltbar? Nur nicht bei MP3 aus dem Flash (nowFile ohne "sd:"); Sprache und Radio schon.
// Does the mute apply to the main stream right now? Only not for MP3 from the flash (nowFile without "sd:"); speech and radio do.

volatile bool muteMain = true;

// Klangeffekte (Hall, Echo, Klangregler): Webradio bleibt immer ohne Effekt. Der Effekt wirkt auf Ansagen (eigene Instanz annFx, mit den Werten der
// Ansage) und auf Dateien, die im Hauptstrom laufen (Instanz fx, allgemeine Werte).
// Sound effects (reverb, echo, tone control): web radio always stays without effect. The effect acts on announcements (own instance annFx, with the values
// of the announcement) and on files playing in the main stream (instance fx, general values).

FxEngine fx;
volatile bool fxFileMain = false;
volatile bool fxSpeechMain = false;
int32_t* fxTmp = nullptr;
#define FX_TMP_WORDS 8192

void fxApplyCfg() {
    fx.mode = FX_OFF;   // Hall und Echo wirken nicht auf Dateien im Hauptstrom / reverb and echo do not act on files in the main stream
    fx.wet = cfg.fxWet;
    fx.bass = cfg.eqBass;
    fx.treble = cfg.eqTreble;
    fx.pan = cfg.panMode;
    fx.panDs = cfg.panDs;
    fx.resetLoad();
}

void muteWatch() {
    bool flash = nowKind == "file" && !nowFile.startsWith("sd:");
    muteMain = !flash;
    fxSpeechMain = nowKind == "speech";
    fxFileMain = nowKind == "file";

    // Solange eine Flash-MP3 laeuft, wird die Verstaerkung nicht mitgefuehrt: sie springt auf den Zielwert, damit es danach nicht erst ein- oder ausblendet.
    // While a flash MP3 plays the gain is not followed: it jumps to the target so nothing fades in or out afterwards.

    if (flash) muteGainQ15 = muted ? 0 : 32768;
}

void muteApply(int32_t* buf, int16_t words) {
    static uint32_t lastUs = 0;
    int32_t cur = muteGainQ15;
    int32_t target = muted ? 0 : 32768;
    if (cur == target) {
        lastUs = 0;
        if (cur == 32768) return;
        for (int i = 0; i < words; i++) buf[i] = 0;
        return;
    }
    uint32_t now = micros();
    float dt = lastUs ? (now - lastUs) / 1000000.0f : 0.02f;
    lastUs = now;
    if (dt > 0.2f) dt = 0.2f;
    float rampS = (cfg.volRampMs < 300 ? 300 : cfg.volRampMs) / 1000.0f;
    int32_t step = (int32_t)(32768.0f * dt / rampS);
    if (step < 1) step = 1;
    int32_t next = cur < target ? (cur + step > target ? target : cur + step) : (cur - step < target ? target : cur - step);
    int frames = words / 2;
    for (int i = 0; i < frames; i++) {
        int32_t g = cur + (int32_t)((int64_t)(next - cur) * i / (frames > 0 ? frames : 1));
        buf[2 * i] = (int32_t)(((int64_t)buf[2 * i] * g) >> 15);
        buf[2 * i + 1] = (int32_t)(((int64_t)buf[2 * i + 1] * g) >> 15);
    }
    muteGainQ15 = next;
}

// Wird im Audio-Task vor jeder I2S-Ausgabe aufgerufen: addiert beide Mischspuren zu den Radio-Samples.
// Called in the audio task before every I2S output: adds both mix tracks to the radio samples.

// Abstaende zwischen den Aufrufen des Audio-Hooks: Luecken ueber 60 ms zeigen, dass die Hauptschleife die Ausgabe nicht rechtzeitig fuellt.
// Intervals between calls of the audio hook: gaps over 60 ms show that the main loop does not fill the output in time.

volatile uint32_t hookGaps = 0;
volatile uint32_t hookGapMax = 0;
volatile uint32_t hookGapAt[8];
volatile uint16_t hookGapLen[8];

void audio_process_i2s(int32_t* buf, int16_t words, bool* continueI2S) {
    static int64_t lastHook = 0;
    int64_t nowHook = esp_timer_get_time();
    if (lastHook != 0) {
        int64_t gap = nowHook - lastHook;
        if (gap > 60000 && gap < 1500000) {
            if (hookGaps < 8) {
                hookGapAt[hookGaps] = millis();
                hookGapLen[hookGaps] = (uint16_t)(gap / 1000);
            }
            hookGaps = hookGaps + 1;
            if ((uint32_t)(gap / 1000) > hookGapMax) hookGapMax = (uint32_t)(gap / 1000);
        }
    }
    lastHook = nowHook;
    int32_t fg = fileGainQ15;
    if (fileGainOn && fg != 32768) {
        for (int i = 0; i < words; i++) {
            int64_t v = ((int64_t)buf[i] * fg) >> 15;
            if (v > INT32_MAX) v = INT32_MAX;
            if (v < INT32_MIN) v = INT32_MIN;
            buf[i] = (int32_t)v;
        }
    }
    uint32_t sr = audio ? audio->getSampleRate() : 0;
    if (sr) {   // wechselt die Hauptdatei die Abtastrate, folgen die Mischspuren / if the main file changes the sample rate the mix tracks follow
        if (mixT[MIX_LAYER].outRate != sr) mixT[MIX_LAYER].outRate = sr;
        if (mixT[MIX_ANN].outRate != sr) mixT[MIX_ANN].outRate = sr;
    }
    mixAddTrack(mixT[MIX_LAYER], buf, words);
    if (muteMain) muteApply(buf, words);

    // Sprache im Hauptstrom bekommt die Ansage-Effekte, eine Datei im Hauptstrom die allgemeinen; Webradio bleibt immer unbearbeitet.
    // Speech in the main stream gets the announcement effects, a file in the main stream the general ones; web radio is never processed.

    if (fxSpeechMain) {
        annFx.process(buf, words, sr);
        return;
    }
    if (fxFileMain) fx.process(buf, words, sr);

    // Gemischte Ansage: eigene Spur, mit den Ansage-Effekten bearbeitet und dann zum Hauptstrom addiert.
    // Mixed announcement: own track, processed with the announcement effects and then added to the main stream.

    if (annFx.active() && mixT[MIX_ANN].active) {
        if (!fxTmp) fxTmp = (int32_t*)heap_caps_malloc(FX_TMP_WORDS * sizeof(int32_t), MALLOC_CAP_SPIRAM | MALLOC_CAP_8BIT);
        if (fxTmp && words <= FX_TMP_WORDS) {
            memset(fxTmp, 0, words * sizeof(int32_t));
            mixAddTrack(mixT[MIX_ANN], fxTmp, words);
            annFx.process(fxTmp, words, sr);
            for (int i = 0; i < words; i++) {
                int64_t v = (int64_t)buf[i] + fxTmp[i];
                buf[i] = v > INT32_MAX ? INT32_MAX : (v < INT32_MIN ? INT32_MIN : (int32_t)v);
            }
            return;
        }
    }
    mixAddTrack(mixT[MIX_ANN], buf, words);
}

// Lese-Task: MP3 aus dem Dateisystem lesen, mit dem Dekoder der Bibliothek in PCM wandeln und in den Ringpuffer schreiben.
// Reader task: read the MP3 from the file system, convert it to PCM with the decoder of the library and write it to the ring buffer.

// Lesen aus der Datei des Mischers; auf der SD-Karte unter dem Sperrzeichen, weil die Weboberflaeche sie zugleich auflisten kann.
// Reading from the file of the mixer; on the SD card under the lock because the web interface may list it at the same time.

int mixRead(bool onSd, File& f, uint8_t* buf, size_t len) {
    if (onSd) xSemaphoreTake(sdMutex, portMAX_DELAY);
    int n = f.read(buf, len);
    if (onSd) xSemaphoreGive(sdMutex);
    return n;
}

void mixSeek(bool onSd, File& f, uint32_t pos) {
    if (onSd) xSemaphoreTake(sdMutex, portMAX_DELAY);
    f.seek(pos);
    if (onSd) xSemaphoreGive(sdMutex);
}

void mixTask(void* arg) {
    MixTrack& m = *(MixTrack*)arg;
    File f = m.onSd ? SD.open(m.path.c_str(), FILE_READ) : LittleFS.open(m.path, FILE_READ);
    uint8_t* in = (uint8_t*)malloc(MIX_IN_BYTES);
    int32_t* out = (int32_t*)malloc(1152 * 2 * sizeof(int32_t));
    MP3Decoder* dec = nullptr;
    if (f && in && out && audio) {
        dec = new MP3Decoder(*audio);
        if (!dec->init()) {
            delete dec;
            dec = nullptr;
        }
    }
    if (dec) {
        uint8_t hdr[10];
        if (mixRead(m.onSd, f, hdr, 10) == 10 && memcmp(hdr, "ID3", 3) == 0) {
            uint32_t sz = ((uint32_t)(hdr[6] & 0x7f) << 21) | ((uint32_t)(hdr[7] & 0x7f) << 14) | ((uint32_t)(hdr[8] & 0x7f) << 7) | (uint32_t)(hdr[9] & 0x7f);
            mixSeek(m.onSd, f, 10 + sz);
        } else {
            mixSeek(m.onSd, f, 0);
        }
        int have = 0;
        bool eof = false;
        bool first = true;
        int errors = 0;
        while (!m.abortFlag) {
            if (have < MIX_REFILL_BELOW && !eof) {
                int64_t rt0 = esp_timer_get_time();
                int n = mixRead(m.onSd, f, in + have, MIX_IN_BYTES - have);
                uint32_t rtu = (uint32_t)(esp_timer_get_time() - rt0);
                if (rtu > m.maxRdUs) m.maxRdUs = rtu;
                if (n <= 0) eof = true;
                else have += n;
            }
            if (have < 4) break;
            int32_t sync = dec->findSyncWord(in, have);
            if (sync < 0) {
                have = 0;
                if (eof) break;
                continue;
            }
            if (sync > 0) {
                memmove(in, in + sync, have - sync);
                have -= sync;
            }
            int32_t left = have;
            int64_t dt0 = esp_timer_get_time();
            int32_t res = dec->decode(in, &left, out);
            uint32_t dtu = (uint32_t)(esp_timer_get_time() - dt0);
            if (dtu > m.maxDecUs) m.maxDecUs = dtu;
            int used = have - left;
            if (res == 0) {
                uint32_t frames = dec->getOutputSamples();
                if (frames > 1152) frames = 1152;
                if (frames > 0) {
                    if (first) {
                        m.srcRate = dec->getSampleRate();
                        first = false;
                    }
                    while (!m.abortFlag && MIX_RING_FRAMES - (m.wr.load(std::memory_order_relaxed) - m.rd.load(std::memory_order_acquire)) < frames + 1) vTaskDelay(3);
                    if (m.abortFlag) break;
                    uint32_t w = m.wr.load(std::memory_order_relaxed);
                    for (uint32_t i = 0; i < frames; i++) {
                        int16_t* d = m.ring + ((w + i) & MIX_RING_MASK) * 2;
                        d[0] = (int16_t)(out[2 * i] >> 16);
                        d[1] = (int16_t)(out[2 * i + 1] >> 16);
                    }
                    m.wr.store(w + frames, std::memory_order_release);
                }
                errors = 0;
            } else if (++errors > 100) {
                break;
            }
            if (used <= 0) used = 1;
            if (used > have) used = have;
            have -= used;
            if (have > 0) memmove(in, in + used, have);
            vTaskDelay(1);
        }
    }
    if (dec) delete dec;
    if (f) f.close();
    free(in);
    free(out);
    m.producerDone = true;
    m.taskRunning = false;
    vTaskDelete(nullptr);
}

// Absenken der Spur 0 (Datei der SD-Karte), solange eine Ansage laeuft: weicher Verlauf ueber die Dauer des Ab- und Aufblendens.
// Lowering of track 0 (file of the SD card) while an announcement runs: smooth ramp over the duration of fading down and up.

struct LayerRamp {
    bool on = false;
    int32_t from = 0;
    int32_t to = 0;
    unsigned long t0 = 0;
    int ms = 0;
};
LayerRamp layRamp;

void layerDuck(bool down) {
    MixTrack& m = mixT[MIX_LAYER];
    if (!m.inUse) return;
    layRamp.from = m.gainQ15;
    layRamp.to = down ? (int32_t)((int64_t)m.baseGainQ15 * cfg.duckPct / 100) : m.baseGainQ15;
    layRamp.t0 = millis();
    layRamp.ms = cfg.fadeMs;
    layRamp.on = true;
}

void layerRampStep() {
    if (!layRamp.on) return;
    MixTrack& m = mixT[MIX_LAYER];
    if (!m.inUse) {
        layRamp.on = false;
        return;
    }
    unsigned long dt = millis() - layRamp.t0;
    int32_t v = layRamp.to;
    if (layRamp.ms > 0 && dt < (unsigned long)layRamp.ms) v = layRamp.from + (int32_t)((int64_t)(layRamp.to - layRamp.from) * (int64_t)dt / layRamp.ms);
    m.gainQ15 = v;
    if (dt >= (unsigned long)layRamp.ms) layRamp.on = false;
}

// Haelt eine Mischspur an: Task beenden, Speicher freigeben; die Radio-Lautstaerke bleibt unveraendert.
// Halts a mix track: end the task, free the memory; the radio volume stays unchanged.

void mixHalt(int t) {
    MixTrack& m = mixT[t];
    if (!m.inUse) return;
    m.active = false;
    m.pending = false;
    m.abortFlag = true;
    for (int i = 0; i < 100 && m.taskRunning; i++) {
        delay(10);
        audioPump();
    }
    m.abortFlag = false;
    for (int i = 0; i < 50 && m.inHook; i++) delay(2);
    delay(5);
    if (m.ring) {
        heap_caps_free(m.ring);
        m.ring = nullptr;
    }
    m.inUse = false;
    if (t == MIX_LAYER) layRamp.on = false;
}

// Beendet eine Mischspur; sind beide frei und wartet nichts, blendet das Radio wieder auf die vorherige Lautstaerke auf.
// Ends a mix track; if both are free and nothing is waiting, the radio fades back up to its previous volume.

void mixStop(int t) {
    bool was = mixT[t].inUse;
    mixHalt(t);
    if (t == MIX_ANN && annCount == 0) layerDuck(false);
    bool radioBack = false;
    if (mixDucked && annCount == 0 && !mixAny()) {
        volRampTo(currentVolume * VOL_FINE, cfg.fadeMs);
        mixDucked = false;
        radioBack = true;
    }
    if (!was) return;
    {
        MixTrack& mm = mixT[t];
        uint32_t ur = mm.outRate ? (uint32_t)((uint64_t)mm.underFrames * 1000 / mm.outRate) : 0;
        logLine("[MIX] track " + String(t) + " ended: dropouts " + String(ur) + " ms, longest decode " + String(mm.maxDecUs / 1000.0, 1) + " ms, longest read " + String(mm.maxRdUs / 1000.0, 1) + " ms" + (mm.firstUnderAt ? ", first dropout " + String((millis() - mm.firstUnderAt) / 1000.0, 1) + " s before the end" : String()) + ", output gaps " + String(hookGaps) + " (longest " + String(hookGapMax) + " ms)");
        {
            String gl;
            for (uint32_t i = 0; i < hookGaps && i < 8; i++) gl += " " + String(hookGapLen[i]) + "ms@-" + String((millis() - hookGapAt[i]) / 1000.0, 1) + "s";
            if (!gl.isEmpty()) logLine("[MIX] gaps (length, time before the end):" + gl);
        }
        hookGaps = 0;
        hookGapMax = 0;
    }
    if (t == MIX_LAYER) logLine(radioBack ? "[MIX] card file over the radio finished, radio back to volume " + String(currentVolume) : String("[MIX] card file over the radio finished"));
    else logLine(annCount > 0 ? String("[MIX] announcement finished, next one waiting, radio stays lowered") : "[MIX] announcement finished, radio back to volume " + String(currentVolume));
}

void mixStopAll() {
    mixStop(MIX_ANN);
    mixStop(MIX_LAYER);
}

// Blendet die laufende Ansage kurz aus (100 ms), bevor eine neue sie ersetzt.
// Fades the running announcement out briefly (100 ms) before a new one replaces it.

void mixQuickFade() {
    MixTrack& m = mixT[MIX_ANN];
    if (!m.inUse || !m.active) return;
    int32_t g0 = m.gainQ15;
    for (int i = 9; i >= 0; i--) {
        m.gainQ15 = (int32_t)((int64_t)g0 * i / 10);
        delay(10);
        audioPump();
        esp_task_wdt_reset();
    }
}

// Startet eine Mischspur fuer eine MP3-Datei; false, wenn Speicher oder Dekoder fehlen (dann gilt der normale Weg ueber Unterbrechen).
// Starts a mix track for an MP3 file; false if memory or decoder is missing (the normal way via interrupting then applies).

bool mixStart(int t, const String& path, int vol, bool sd = false, bool duckLayer = true, bool duckBase = true) {
    MixTrack& m = mixT[t];
    if (t == MIX_ANN) mixQuickFade();
    mixHalt(t);
    if (!audio) return false;
    m.ring = (int16_t*)heap_caps_malloc(MIX_RING_FRAMES * 2 * sizeof(int16_t), MALLOC_CAP_SPIRAM | MALLOC_CAP_8BIT);
    if (!m.ring) return false;
    m.inUse = true;
    m.path = path;
    m.onSd = sd;
    m.vol = vol;

    // Stumm gilt fuer Text-Ansagen und SD-Dateien, nicht fuer MP3 aus dem Flash.
    // Mute applies to text announcements and SD files, not to MP3 from the flash.

    m.muteIt = sd || path == TTS_FILE;
    m.wr = 0;
    m.rd = 0;
    m.phase = 0;
    m.srcRate = 0;
    m.drained = false;
    m.producerDone = false;
    m.abortFlag = false;
    m.underFrames = 0;
    m.maxDecUs = 0;
    m.maxRdUs = 0;
    m.firstUnderAt = 0;
    hookGaps = 0;
    hookGapMax = 0;
    m.outRate = audio->getSampleRate();
    m.baseGainQ15 = mixGainFor(vol);
    m.gainQ15 = m.baseGainQ15;
    m.taskRunning = true;
    // Die Dekodier-Tasks laufen auf Kern 1: auf Kern 0 (WLAN) war die Dekodierzeit bis 207 ms und es gab Aussetzer von zusammen ueber 10 s.
    // The decoder tasks run on core 1: on core 0 (WiFi) the decode time was up to 207 ms and there were dropouts of over 10 s in total.

    if (m.outRate == 0 || xTaskCreatePinnedToCore(mixTask, t == MIX_LAYER ? "mixlay" : "mixann", 12288, &m, 2, nullptr, 1) != pdPASS) {
        m.taskRunning = false;
        mixStop(t);
        return false;
    }
    unsigned long t0 = millis();
    while (millis() - t0 < 1500 && m.taskRunning && (m.wr.load() - m.rd.load()) < MIX_PREFILL_FRAMES) {
        delay(2);
        audioPump();
        esp_task_wdt_reset();
    }
    if (m.wr.load() < 2) {
        mixStop(t);
        return false;
    }
    m.lastRd = 0;
    m.lastProgress = millis();
    int duck = currentVolume * VOL_FINE * cfg.duckPct / 100;

    // War das Radio oder die Datei schon beim Aufruf abgesenkt (Ansage), startet die Ansage ohne weitere Wartezeit.
    // If the radio or file was already lowered when the call came in (announcement), the announcement starts without further delay.

    // Eine zweite Datei ueber einer laufenden Datei (kein Webradio) senkt die erste nicht ab: beide spielen mit ihrer eigenen Lautstaerke weiter.
    // A second file over a running file (no web radio) does not lower the first one: both keep playing at their own volume.

    unsigned long lead = (unsigned long)cfg.fadeMs * 6 / 10;
    unsigned long since = mixDucked ? millis() - mixDuckAt : 0;
    if (duckBase) {
        if (!mixDucked) {
            volRampTo(duck, cfg.fadeMs);
            mixDuckAt = millis();
        }
        mixDucked = true;
    } else {
        lead = 0;
    }
    if (t == MIX_ANN && duckLayer) layerDuck(true);
    m.pending = true;
    m.activateAt = millis() + (since >= lead ? 0 : lead - since);
    logLine("[MIX] " + path + " mixed over the running audio, " + String(t == MIX_LAYER ? "file" : "announcement") + " volume " + String(vol) + ", radio " + String(currentVolume) + " -> " + String(duck / VOL_FINE) + ", source " + String(m.srcRate) + " Hz, output " + String(m.outRate) + " Hz");
    return true;
}

// Kann eine Ansage oder Datei jetzt ueber das laufende Radio oder eine laufende MP3-Datei gemischt werden?
// Can an announcement or file be mixed over the running radio or a running MP3 file now?

bool mixPossible() {
    if (!cfg.mixAnn || !audio || playState != PS_PLAYING || !audio->isRunning()) return false;
    if (streamActive) return nowKind == "radio" && !streamWaitingReady && !fadeInWaiting && !fadeInActive;
    return nowKind == "file";
}

// Darf eine MP3-Datei jetzt zusaetzlich zu einem laufenden Klang gespielt werden? Hoechstens zwei Klaenge (Datei im Hauptstrom, Mischspuren) zugleich;
// das Webradio zaehlt nicht mit. Texte laufen weiter nacheinander.
// May an MP3 file be played now in addition to a running sound? At most two sounds (file in the main stream, mix tracks) at the same time;
// the web radio does not count. Texts still run one after another.

bool fileConcurrentOk(const Pending& p) {
    if (p.type != PEND_FILE || !cfg.mixAnn || voiceBusy || !mixPossible()) return false;
    String l = p.text;
    l.toLowerCase();
    if (!l.endsWith(".mp3")) return false;
    int n = (nowKind == "file" ? 1 : 0) + (mixT[MIX_LAYER].inUse ? 1 : 0) + (mixT[MIX_ANN].inUse ? 1 : 0);
    if (n < 1 || n >= 2) return false;
    return !mixT[MIX_LAYER].inUse || !mixT[MIX_ANN].inUse;
}

// Meldet einen Fehler, ohne das laufende Radio anzutasten.
// Reports an error without touching the running radio.

void announceFail(const String& msg) {
    lastError = msg;
    logLine("[PLAY] " + msg);
    if (annCount == 0) layerDuck(false);
    if (mixDucked && annCount == 0 && !mixAny()) {
        volRampTo(currentVolume * VOL_FINE, cfg.fadeMs);
        mixDucked = false;
    }
    publishStatus(true);
}

// Prueft laufend, ob eine Mischspur zu Ende ist oder haengt.
// Continuously checks whether a mix track has ended or is stuck.

void mixWatch() {
    volRampStep();
    layerRampStep();
    for (int t = 0; t < 2; t++) {
        MixTrack& m = mixT[t];
        if (!m.inUse) continue;
        if (m.pending && millis() >= m.activateAt) {
            m.pending = false;
            m.active = true;
            m.lastProgress = millis();
        }
        uint32_t rd = m.rd.load();
        if (rd != m.lastRd) {
            m.lastRd = rd;
            m.lastProgress = millis();
        }
        bool empty = m.producerDone && (m.wr.load() - rd) < 2;
        bool stuck = m.active && (m.wr.load() - rd) > 0 && millis() - m.lastProgress > 4000;
        if (empty || m.drained || stuck || !audio || playState != PS_PLAYING || !(streamActive || nowKind == "file")) mixStop(t);
    }
}

// Waehrend der Text geladen wird, blockiert die Hauptschleife; ein kleiner Task fuehrt das Absenken in dieser Zeit weiter, damit es sanft bleibt.
// While the text is being loaded the main loop is blocked; a small task keeps the lowering going meanwhile so it stays smooth.

volatile bool duckWorkerRun = false;
volatile bool duckWorkerDone = true;

void duckWorker(void*) {
    while (duckWorkerRun) {
        volRampStep();
        layerRampStep();
        vTaskDelay(pdMS_TO_TICKS(20));
    }
    duckWorkerDone = true;
    vTaskDelete(nullptr);
}

void duckWorkerStart() {
    duckWorkerDone = false;
    duckWorkerRun = true;
    if (xTaskCreate(duckWorker, "duck", 4096, nullptr, 1, nullptr) != pdPASS) {
        duckWorkerRun = false;
        duckWorkerDone = true;
    }
}

void duckWorkerStop() {
    duckWorkerRun = false;
    for (int i = 0; i < 50 && !duckWorkerDone; i++) delay(2);
}

// Ansage ueber das Radio mischen: Text laden, dann mit dem Mischer ueber das laufende Radio legen. false = normaler Weg.
// Mix an announcement over the radio: download the text, then lay it over the running radio with the mixer. false = normal way.

bool speakMixed(const Pending& p) {
    bool cached = ttsLocate(p).kind != 0;
    if (!cached && cfg.vkey.isEmpty()) {
        announceFail("VoiceRSS API key is not set");
        return true;
    }
    if (!cached && WiFi.status() != WL_CONNECTED) {
        announceFail("No WiFi connection");
        return true;
    }
    mixQuickFade();
    mixHalt(MIX_ANN);
    lastError = "";

    // Radio oder Datei sofort absenken, damit die Ansage nach dem Laden gleich zu hoeren ist.
    // Lower the radio or file right away so the announcement is audible as soon as it is loaded.

    if (!mixDucked) {
        volRampTo(currentVolume * VOL_FINE * cfg.duckPct / 100, cfg.fadeMs);
        mixDucked = true;
        mixDuckAt = millis();
    }
    layerDuck(true);
    voiceBusy = true;
    voiceEver = true;
    publishStatus(true);
    String err;
    duckWorkerStart();
    bool ok = fetchSpeech(p, err);
    duckWorkerStop();
    voiceBusy = false;
    voiceLastOk = ok;
    if (!ok) {
        announceFail("VoiceRSS: " + err);
        return true;
    }
    if (!mixPossible()) {
        announceFail("Radio stopped while the announcement was loading");
        return true;
    }
    if (!mixStart(MIX_ANN, TTS_FILE, p.vol >= 0 ? p.vol : cfg.vol)) {
        announceFail("Mixer not available");
        return true;
    }
    publishStatus(true);
    return true;
}

// Datei ueber das Radio mischen; false, wenn die Datei kein Fall fuer den Mischer ist (dann der normale Weg).
// Mix a file over the radio; false if the file is not a case for the mixer (then the normal way).

bool fileMixed(const Pending& p) {
    FileRef r = resolveFile(p.text);
    if (!r.ok) {
        announceFail(String(r.sd && !sdReady ? "SD card not available: " : "File not found: ") + r.path);
        return true;
    }
    lastError = "";

    // Eine Datei der Karte ueber dem Radio liegt auf Spur 0 und wird von einer Ansage abgesenkt; alles andere ist eine Ansage (Spur 1).
    // A file of the card over the radio goes on track 0 and is lowered by an announcement; everything else is an announcement (track 1).

    bool layer = r.sd && streamActive;

    // Laeuft schon ein Klang, bekommt die Datei die freie Spur und beide spielen zugleich (die laufende Datei wird nicht abgesenkt).
    // If a sound is already running, the file gets the free track and both play at the same time (the running file is not lowered).

    bool together = nowKind == "file" || mixT[MIX_LAYER].inUse || mixT[MIX_ANN].inUse;
    if (together) {
        int want = layer ? MIX_LAYER : MIX_ANN;
        if (mixT[want].inUse) layer = want == MIX_ANN;   // die andere Spur nehmen / take the other track
    }

    // Die Effektwerte der Ansagen nur setzen, wenn die Datei auf die Ansagenspur kommt; eine laufende Ansage behaelt sonst ihre Werte.
    // Set the effect values of the announcements only if the file goes on the announcement track; otherwise a running announcement keeps its values.

    if (!layer) annSetParams(fxFileParamsFor(p));
    if (!mixStart(layer ? MIX_LAYER : MIX_ANN, r.path, p.vol >= 0 ? p.vol : cfg.vol, r.sd, !together, !(nowKind == "file" && !streamActive))) return false;

    // Laeuft schon eine Datei, bleibt sie die angezeigte; nur ueber einem Radio steht die gemischte Datei in nowFile.
    // If a file is already playing it stays the one shown; only over a radio the mixed file goes into nowFile.

    if (nowKind != "file") nowFile = r.shown;
    publishStatus(true);
    return true;
}

// Beendet Wiedergabe und Mischer, die gerade von der Karte lesen (vor dem Neu-Einbinden).
// Ends playback and mixer that are reading from the card right now (before mounting again).

void sdStopAll() {
    for (int t = 0; t < 2; t++) {
        if (mixT[t].inUse && mixT[t].onSd) mixStop(t);
    }
    if (nowKind == "file" && playState != PS_IDLE && nowFile.startsWith("sd:")) stopPlayback();
}

// Beendet die Wiedergabe oder den Mischer, wenn die Datei oder eine Datei im Ordner der Karte gerade benutzt wird.
// Ends playback or the mixer if the file, or a file in the folder, on the card is being used right now.
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
void loop() {
    esp_task_wdt_reset();
    static uint32_t winStart = 0, aMax = 0, lMax = 0, bMin = 0xFFFFFFFF;
    uint32_t t0 = micros();

    // Zweimal pro Durchlauf: Bearbeitet ein Webzugriff die Schleife 40 bis 60 ms, fuellt der zweite Aufruf den Ausgabepuffer danach wieder auf.
    // Twice per pass: if a web request holds the loop for 40 to 60 ms, the second call refills the output buffer afterwards.

    if (audio) {
        audio->loop();
        audio->loop();
    }
    uint32_t t1 = micros();
    if (t1 - t0 > aMax) aMax = t1 - t0;
    if (audio) {
        uint32_t bf = audio->inBufferFilled();
        diagBufKb = bf / 1024;
        diagDecErr = audio->getDecodeErrors();
        if (bf < bMin) bMin = bf;
    }
    // Dauert ein Schritt der Schleife ueber 500 ms, steht sein Name im Log (Suche nach Blockaden).
    // If a step of the loop takes over 500 ms, its name goes to the log (hunting for blockades).

    uint32_t tk = t0, tkMax = 0;
    const char* tkName = "";
#define TICK(name) do { uint32_t tn = micros(); if (tn - tk > tkMax) { tkMax = tn - tk; tkName = name; } tk = tn; } while (0)
    TICK("audio");
    audioEventPump(); TICK("audioEventPump");
    titleWatch(); TICK("titleWatch");
    fadeInStep(); TICK("fadeInStep");
    webserver.handleClient(); TICK("webserver");
    dirFeed(); TICK("dirFeed");
    processQueue(); TICK("processQueue");
    processPending(); TICK("processPending");
    playbackWatch(); TICK("playbackWatch");
    radioKeepAlive(); TICK("radioKeepAlive");
    wifiWatch(); TICK("wifiWatch");
    mqttWatch(); TICK("mqttWatch");
    restartWatch(); TICK("restartWatch");
    healthWatch(); TICK("healthWatch");
    ledWatch(); TICK("ledWatch");
    autostartWatch(); TICK("autostartWatch");
    mixWatch(); TICK("mixWatch");
    fileFadeWatch(); TICK("fileFadeWatch");
    loudWatch(); TICK("loudWatch");
    agcWatch(); TICK("agcWatch");
    muteWatch(); TICK("muteWatch");
    pinWatch(); TICK("pinWatch");
    logWatch(); TICK("logWatch");
    ntpWatch(); TICK("ntpWatch");
    resumeStateWatch(); TICK("resumeStateWatch");
#undef TICK
    if (tkMax > 500000UL) logLine("[LOOP] stall " + String(tkMax / 1000) + " ms in " + tkName);
    uint32_t t2 = micros();
    if (t2 - t0 > lMax) lMax = t2 - t0;
    if (millis() - winStart > 5000) {
        winStart = millis();
        diagAudioMs = aMax / 1000;
        diagLoopMs = lMax / 1000;
        diagBufMinKb = (bMin == 0xFFFFFFFF ? 0 : bMin) / 1024;
        aMax = 0;
        lMax = 0;
        bMin = 0xFFFFFFFF;
    }
    delay(2);
}
