holgiw/ESP32-netspeaker/web_ui.h

#pragma once

// Web-Oberflaeche: eine Hub-Seite mit Tabs, Statusleiste, JSON-API, Datei-Upload, Export/Import.
// Web interface: one hub page with tabs, status bar, JSON API, file upload, export/import.

// ---------------------------------------------------------------------------
// Stil, Seitenkopf / style, page head

static const char PAGE_CSS[] PROGMEM = R"css(
:root{--bg:#10151a;--panel:#1a2129;--panel-border:#2a333c;--text:#e8edf2;--muted:#8f9ba7;--accent:#f5a623;--accent-dim:#7a530f;--ok:#3ddc84;--bad:#ff5c5c;--sans:system-ui,-apple-system,"Segoe UI",Roboto,sans-serif;--mono:ui-monospace,"SFMono-Regular",Menlo,Consolas,monospace;}
body{font-family:Arial,Helvetica,sans-serif;text-align:center;margin:0;background:var(--bg);color:var(--text);}
.page{padding:0 8px 40px;}
input,select,button,textarea{margin:10px;padding:10px;width:80%;box-sizing:border-box;background:#0d1216;color:var(--text);border:1px solid var(--panel-border);border-radius:6px;font-family:inherit;}
input[type=checkbox],input[type=radio]{width:auto;}
button,button[type=submit],input[type=submit]{background:var(--accent);color:#1a1200;font-weight:bold;border:none;cursor:pointer;}
button:hover,input[type=submit]:hover{background:#ffb84d;}
h1,h2,h3{color:var(--text);}
hr{border:0;height:1px;background-color:var(--panel-border);margin:20px 0;}
table{margin:auto;border-collapse:collapse;}
th,td{padding:8px 10px;text-align:left;border:1px solid var(--panel-border);}
a{color:var(--accent);}
small{color:var(--muted);}
.topbar{display:flex;flex-wrap:wrap;align-items:center;gap:.6rem 1.2rem;padding:.9rem 1rem;border-bottom:1px solid var(--panel-border);position:sticky;top:0;background:var(--bg);z-index:5;}
.brand{display:flex;align-items:baseline;gap:.5rem;margin-right:auto;}
.brand-mark{font-family:var(--mono);color:var(--accent);font-size:.8rem;letter-spacing:.05em;}
.topbar h1{font-size:1.15rem;margin:0;letter-spacing:.02em;}
h1 a.host-link{color:inherit;text-decoration:none;border-bottom:1px dashed var(--muted);}
h1 a.host-link:hover{color:var(--accent);border-bottom-color:var(--accent);}
.ip-hint{font-family:var(--mono);font-size:.7rem;color:var(--muted);}
.ip-hint a{color:inherit;font-size:inherit;text-decoration:none;border-bottom:1px dashed var(--muted);}
.ip-hint a:hover{color:var(--accent);border-bottom-color:var(--accent);}
.status-strip{display:flex;gap:.9rem;flex-wrap:wrap;}
.status{display:flex;align-items:center;gap:.4rem;font-size:.8rem;color:var(--muted);}
.status[hidden]{display:none;}
.statval{font-family:var(--mono);color:var(--text);}
.dot{width:.55rem;height:.55rem;border-radius:50%;background:var(--bad);box-shadow:0 0 0 3px rgba(255,92,92,.15);}
.dot.ok{background:var(--ok);box-shadow:0 0 0 3px rgba(61,220,132,.18);}
.dot.na,.dot.idle{background:var(--muted);box-shadow:0 0 0 3px rgba(143,155,167,.18);}
.dot.syncing{background:var(--accent);box-shadow:0 0 0 3px rgba(245,166,35,.18);animation:dotBlink 1s ease-in-out infinite;}
.dot.playing{background:var(--ok);box-shadow:0 0 0 3px rgba(61,220,132,.18);animation:dotBlink 1s ease-in-out infinite;}
@keyframes dotBlink{0%,100%{opacity:1;}50%{opacity:.25;}}
@media (prefers-reduced-motion:reduce){.dot.syncing,.dot.playing{animation:none;opacity:.6;}}
.datetime{font-family:var(--mono);font-size:.8rem;color:var(--muted);}
.offline-hint{display:none;color:var(--bad);font-size:.75rem;margin-left:.3rem;}
.offline-hint.show{display:inline;}
.refresh-btn{display:inline-flex;align-items:center;justify-content:center;box-sizing:border-box;background:transparent;border:1px solid var(--panel-border);color:var(--text);border-radius:.4rem;width:2rem;height:2rem;padding:0;margin:0;font-size:1rem;line-height:1;cursor:pointer;text-decoration:none;}
.refresh-btn:hover{background:transparent;border-color:var(--accent);color:var(--accent);}
.refresh-btn:focus-visible{outline:2px solid var(--accent);outline-offset:1px;}
.reset-btn{background:transparent;border:1px solid var(--panel-border);color:var(--bad);border-radius:.4rem;width:2rem;height:2rem;padding:0;margin:0;font-size:1rem;line-height:1;cursor:pointer;}
.reset-btn:hover{background:rgba(255,92,92,.12);border-color:var(--bad);}
.reset-btn:focus-visible{outline:2px solid var(--bad);outline-offset:1px;}
.tabctrl{display:none;}
.tabnav{margin:20px auto;max-width:900px;display:flex;flex-wrap:wrap;justify-content:center;gap:4px;}
.tabnav label{background:var(--panel);border:1px solid var(--panel-border);color:var(--muted);padding:8px 16px;border-radius:8px 8px 0 0;cursor:pointer;font-weight:bold;}
.tabpanel{display:none;}
.card{background:var(--panel);border:1px solid var(--panel-border);border-radius:10px;max-width:500px;margin:15px auto;padding:12px 16px;text-align:left;}
.card h3{margin:.2rem 0 .6rem;text-align:center;}
.card.wide{max-width:700px;}
.sub{border:1px solid var(--panel-border);border-radius:8px;padding:4px 12px 10px;margin:10px 0;}
.sub h4{margin:.5rem 0 .6rem;font-size:.95rem;color:var(--accent);text-align:left;}
.pinrow{justify-content:flex-start;}
.pinlabel{display:inline-block;width:11rem;text-align:right;color:var(--muted);}
select.pinsel.dup{outline:2px solid var(--bad);}
.pinwarn{display:block;color:var(--bad);min-height:1.2em;}
.row{display:flex;gap:6px;align-items:center;flex-wrap:wrap;justify-content:center;}
.row input,.row select,.row button{margin:6px;}
.flash{background:#d4edda;color:#155724;border:1px solid #c3e6cb;border-radius:6px;padding:8px 12px;margin:10px auto;max-width:500px;}
.codewrap{position:relative;}
.copy-btn{position:absolute;top:6px;right:6px;width:auto;margin:0;padding:3px 10px;font-size:.75rem;font-weight:normal;background:var(--panel);border:1px solid var(--panel-border);color:var(--text);border-radius:.4rem;cursor:pointer;}
.copy-btn:hover{background:var(--panel);border-color:var(--accent);color:var(--accent);}
.doc p,.doc li{font-size:.9rem;line-height:1.45;}
.doc table{width:100%;font-size:.85rem;}
.doc td,.doc th{text-align:left;}
.mqtt{font-size:1.05rem;}
.mqtt h3{font-size:1.3rem;}
.mqtt input{font-size:1.05rem;}
.mqtt label{display:block;margin:.6rem 0 .1rem;font-weight:bold;}
.mqtt table{width:100%;margin:12px 0;}
.mqtt th{background:var(--bg);font-size:.95rem;}
.mqtt td{vertical-align:top;padding:9px 10px;font-size:1rem;}
.mqtt code{font-family:var(--mono);font-size:.95rem;color:var(--accent);overflow-wrap:anywhere;word-break:normal;}
.mqtt td:first-child{min-width:310px;}
.mqtt .ex{display:block;margin:2px 0 6px;color:var(--text);}
.mqtt .kind{display:inline-block;padding:1px 8px;border-radius:10px;font-size:.8rem;border:1px solid var(--panel-border);color:var(--muted);}
.mqtt .kind.cmd{color:var(--accent);border-color:var(--accent-dim);}
.mqtt .kind.msg{color:var(--ok);border-color:var(--ok);}
.flash.warn{background:#fff3cd;color:#856404;border-color:#ffeeba;}
.flash.bad{background:#f8d7da;color:#721c24;border-color:#f5c6cb;font-weight:600;}
.res-ok{background:#d4edda;color:#155724;border:1px solid #c3e6cb;border-radius:6px;padding:8px 12px;margin:10px auto;max-width:400px;}
.res-bad{background:#f8d7da;color:#721c24;border:1px solid #f5c6cb;border-radius:6px;padding:8px 12px;margin:10px auto;max-width:400px;}
textarea{height:110px;resize:vertical;}
pre.code{text-align:left;white-space:pre-wrap;word-break:break-all;font-family:var(--mono);font-size:.75rem;color:var(--muted);}
)css";

#include "wiring_svg.h"
#include "wiring_view_svg.h"
#include "lang_en_json.h"

static const char TAB_KEYS[][12] = {"mp3", "ansage", "sd", "radio", "pins", "audio", "mqtt", "wlan", "zeit", "sicherung", "status", "log", "doku"};
static const char* const TAB_LABELS[] = {"MP3 (Flash)", "Ansage", "SD-Karte", "Webradio", "Eing&auml;nge", "Audio", "MQTT", "WLAN", "Zeit", "Sicherung", "Status", "Log", "Doku"};
static const char* const TAB_TIPS[] = {"MP3-Dateien im Ger&auml;t hochladen und abspielen", "Text ansagen, stoppen, Lautst&auml;rke", "Dateien der SD-Karte abspielen, hochladen und verwalten", "Webradio-URL abspielen und bis zu 30 Sender speichern", "Freie Pins mit Pull-up: bei Kontakt nach GND eine Ansage oder MP3-Datei abspielen", "Anschl&uuml;sse (Pins von Verst&auml;rker und SD-Karte), Lautst&auml;rke, &Uuml;berblenden, Start und Sprachausgabe (VoiceRSS)", "MQTT-Broker und Basis-Topic", "Hostname und WLAN-Zugangsdaten", "Zeitserver und Zeitzone", "Einstellungen sichern und wieder einlesen, wahlweise mit WLAN-Zugangsdaten und Dateien im Flash", "Zustand des Ger&auml;ts", "Ereignisprotokoll", "Alle REST- und MQTT-Aufrufe zum Kopieren"};
static const int TAB_COUNT = 13;

// ⓘ-Hinweis mit Erklaerung als Tooltip (title) - der Punkt am Satzende kommt hier dazu; im Text keine einfachen Anfuehrungszeichen.
// ⓘ note with an explanation as tooltip (title) - the full stop at the end is added here; no single quotes in the text.

String infoTip(const String& text) {
    return "<span title='" + text + ".' style='cursor:help;'>&#9432;</span>";
}

String htmlEsc(const String& s) {
    String out;
    for (size_t i = 0; i < s.length(); i++) {
        char c = s[i];
        if (c == '&') out += "&amp;";
        else if (c == '<') out += "&lt;";
        else if (c == '>') out += "&gt;";
        else if (c == '\'') out += "&#39;";
        else if (c == '"') out += "&quot;";
        else out += c;
    }
    return out;
}

// Text fuer Tooltip und aria-label eines Punktes; ohne Umlaute, weil JavaScript keine HTML-Entities aufloest.
// Text for the tooltip and aria-label of a dot; without umlauts because JavaScript does not decode HTML entities.

String dotStatusText(const String& label, const String& state) {
    String t = "Nicht verfuegbar";
    if (state == "ok") t = "OK";
    else if (state == "syncing") t = "Aktiv";
    else if (state == "playing") t = "Spielt";
    else if (state == "idle") t = "Leerlauf";
    else if (state == "bad") t = "Fehler";
    return label + ": " + t;
}

String statusDotHtml(const String& key, const String& label, const String& state, bool gated, bool present) {
    String title = htmlEsc(dotStatusText(label, state));
    String cls = state == "na" ? " na" : (state == "ok" ? " ok" : (state == "syncing" ? " syncing" : (state == "playing" ? " playing" : (state == "idle" ? " idle" : ""))));
    String h = "<span class='status' id='status-" + key + "'" + ((gated && !present) ? " hidden" : "") + ">";
    h += "<i id='dot-" + key + "' class='dot" + cls + "' role='img' title='" + title + "' aria-label='" + title + "'></i>" + label + "</span>";
    return h;
}

String formatNow() {
    if (!timeIsValid()) return "";
    char buf[24];
    time_t now = time(nullptr);
    struct tm timeinfo;
    localtime_r(&now, &timeinfo);
    strftime(buf, sizeof(buf), "%d.%m.%Y %H:%M", &timeinfo);
    return String(buf);
}

bool mqttGatedPresent() {
    return mqttEverConnected;
}

bool voiceGatedPresent() {
    return voiceEver;
}

// Die Punkte hier und in handleTopbarStatus() muessen dieselben Bedingungen nutzen, sonst stimmen Erstansicht und Abfrage nicht ueberein.
// The dots here and in handleTopbarStatus() must use the same conditions, otherwise first paint and poll disagree.

String topbarHtml() {
    String ip = apActive && WiFi.status() != WL_CONNECTED ? WiFi.softAPIP().toString() : WiFi.localIP().toString();
    String h = "<header class='topbar'><div class='brand'><span class='brand-mark'>" PROJECT_TAG "</span>";
    h += "<h1><a class='host-link' href='http://" + cfg.host + ".local/'>" + htmlEsc(cfg.host) + "</a></h1>";
    h += "<span class='ip-hint'><a href='http://" + ip + "/'>" + ip + "</a></span></div>";
    h += "<div class='status-strip'>";
    h += "<span class='status' title='Aktuelle Lautst&auml;rke (0 bis 100)'>Lautst&auml;rke: <span id='value-vol' class='statval'>" + String(cfg.vol) + "/" + String(VOLUME_MAX) + "</span></span>";
    if (cfg.mqttServer.length() > 0) h += statusDotHtml("mqtt", "MQTT", mqttDotState(), true, mqttGatedPresent());
    if (cfg.vkey.length() > 0) h += statusDotHtml("voice", "VoiceRSS", voiceDotState(), true, voiceGatedPresent());
    h += statusDotHtml("audio", "Audio", audioDotState(), false, true);
    h += statusDotHtml("time", "Zeit", timeDotState(), false, true);
    h += "</div><div id='topbar-datetime' class='datetime'>" + formatNow() + "</div>";
    h += "<span id='topbar-offline-hint' class='offline-hint'>&#9888; Verbindung verloren</span>";
    h += "<a class='refresh-btn' id='langBtn' href='#' style='display:none' title='Sprache / Language'></a>";
    h += "<button type='button' class='reset-btn' onclick=\"if(confirm('ESP32 jetzt neu starten?')){fetch('/restart',{method:'POST'});setTimeout(function(){location.reload();},5000);}\" title='Neu starten'>&#9211;</button>";
    h += "</header>";
    return h;
}

static const char TOPBAR_JS[] PROGMEM = R"js(
(function(){
  function setStatusDot(id,state,title){var el=document.getElementById(id);if(!el)return;
    el.classList.toggle('ok',state==='ok');el.classList.toggle('syncing',state==='syncing');el.classList.toggle('playing',state==='playing');el.classList.toggle('idle',state==='idle');el.classList.toggle('na',state==='na');
    if(title){el.title=title;el.setAttribute('aria-label',title);}}
  function setPresent(id,p){var el=document.getElementById(id);if(el)el.hidden=!p;}
  function setValue(id,t){var el=document.getElementById(id);if(el)el.textContent=t;}
  function setOnline(ok){var h=document.getElementById('topbar-offline-hint');if(h)h.classList.toggle('show',!ok);}
  var fails=0;
  function poll(){
    fetch('/api/topbarStatus',{cache:'no-store'}).then(function(r){return r.json();}).then(function(s){
      fails=0;setOnline(true);
      setStatusDot('dot-mqtt',s.mqtt,s.mqttTitle);setPresent('status-mqtt',s.mqttPresent);
      setStatusDot('dot-voice',s.voice,s.voiceTitle);setPresent('status-voice',s.voicePresent);
      setStatusDot('dot-audio',s.audio,s.audioTitle);
      setStatusDot('dot-time',s.time,s.timeTitle);
      setValue('value-vol',s.volValue);
      var dt=document.getElementById('topbar-datetime');if(dt)dt.textContent=s.datetime;
    }).catch(function(){fails++;if(fails>=2)setOnline(false);});
  }
  var timer=null;
  function start(){if(timer)return;poll();timer=setInterval(poll,5000);}
  function stop(){if(!timer)return;clearInterval(timer);timer=null;}
  document.addEventListener('visibilitychange',function(){if(document.hidden)stop();else start();});
  if(!document.hidden)start();
})();
function loadStations(inp){
  var f=inp.files[0];if(!f)return;
  if(!confirm('Die gespeicherte Senderliste wird durch die Datei ersetzt. Fortfahren?')){inp.value='';return;}
  var rd=new FileReader();
  rd.onload=function(){fetch('/importstations',{method:'POST',headers:{'Content-Type':'text/plain'},body:rd.result}).then(function(r){return r.text();}).then(function(t){
    alert(t.indexOf('OK|')===0?t.substring(3):('Fehler: '+t.substring(5)));location.href='/?tab=radio';});};
  rd.readAsText(f);
}
)js";

// ---------------------------------------------------------------------------
// Tabs / tabs

String selectOptions(const char* const* values, const char* const* labels, int count, const String& current) {
    String h;
    for (int i = 0; i < count; i++) {
        h += "<option value='" + String(values[i]) + "'" + (current == values[i] ? " selected" : "") + ">" + labels[i] + "</option>";
    }
    return h;
}

static const char* const LANG_VALUES[] = {"de-de", "en-gb", "en-us", "fr-fr", "es-es", "it-it", "nl-nl", "pt-pt", "pl-pl", "sv-se", "da-dk"};
static const char* const LANG_LABELS[] = {"Deutsch (de-de)", "English UK (en-gb)", "English US (en-us)", "Fran&ccedil;ais (fr-fr)", "Espa&ntilde;ol (es-es)", "Italiano (it-it)", "Nederlands (nl-nl)", "Portugu&ecirc;s (pt-pt)", "Polski (pl-pl)", "Svenska (sv-se)", "Dansk (da-dk)"};
static const int LANG_COUNT = 11;

static const char* const FMT_VALUES[] = {"8khz_16bit_mono", "22khz_16bit_mono", "44khz_16bit_mono", "44khz_16bit_stereo"};
static const char* const FMT_LABELS[] = {"8 kHz mono (klein)", "22 kHz mono (Standard)", "44 kHz mono", "44 kHz stereo"};

// Die Auswahl der Stimmen wird im Browser je nach gewaehlter Sprache gefuellt (VOICES in PAGE_JS); "Andere ..." erlaubt eigene Namen.
// The voice choices are filled in the browser depending on the selected language (VOICES in PAGE_JS); "Andere ..." allows own names.

String nowPlayingRow();

// Lautstaerkeregler ganz oben in den Tabs MP3, Ansage, SD-Karte und Webradio; alle Regler zeigen denselben Wert.
// Volume slider at the very top of the tabs MP3, Ansage, SD-Karte and Webradio; all sliders show the same value.

String volumeRow() {
    return "<div class='row volrow'><label>Lautst&auml;rke <input type='range' class='volrange' min='0' max='" + String(VOLUME_MAX) + "' value='" + String(cfg.vol) + "' style='width:200px' oninput='volShow(this.value)' onchange='setVol(this.value)'> <span class='volshow' style='display:inline-block;min-width:76px'>" + String(cfg.vol) + " / " + String(VOLUME_MAX) + "</span></label><button type='button' class='stopbtn' onclick='stopNow()' style='width:auto;padding:6px 16px;margin:0 4px 0 12px' disabled>&#9632; Stopp</button><button type='button' class='mutebtn' onclick='muteToggle()' style='width:auto;padding:6px 16px;margin:0 8px 0 4px'>Stumm</button> " + infoTip("Lautst&auml;rke 0 bis 100; wird sofort &uuml;bernommen und gespeichert. Stopp: beendet die Wiedergabe sofort, auch ein Webradio, ohne Fortsetzung. Stumm: blendet den Ton sanft aus und wieder ein, die eingestellte Lautst&auml;rke bleibt unver&auml;ndert. Stumm gilt f&uuml;r Webradio, Text-Ansagen (Uhrzeit, Mail ...) und MP3 von der SD-Karte; MP3 aus dem Flash bleiben h&ouml;rbar") + "</div>";
}

String panelSpeak() {
    String h = volumeRow() + nowPlayingRow();
    h += "<div class='card'><h3>Text ansagen</h3>";
    h += "<div class='row'>Text zum Ansagen " + infoTip("Text, der &uuml;ber VoiceRSS angesagt wird (h&ouml;chstens 500 Zeichen)") + "</div>";
    h += "<textarea id='sayText' maxlength='" + String(TTS_MAX_CHARS) + "' placeholder='Text zum Ansagen'></textarea>";
    h += "<div class='row'><select id='sayLang' onchange=\"fillVoiceSel('sayVoice',this.value,false)\" style='width:210px'><option value=''>Standard (" + htmlEsc(cfg.vlang) + ")</option>" + selectOptions(LANG_VALUES, LANG_LABELS, LANG_COUNT, "") + "</select> " + infoTip("Sprache der Ansage; Standard ist die Sprache aus dem Tab Audio") + "";
    h += "<select id='sayVoice' onchange='voiceChosen(this)' style='width:210px'><option value=''>Standard (VoiceRSS)</option></select> " + infoTip("Stimme f&uuml;r diese Ansage; Standard = gespeicherte Stimme bzw. Standardstimme der Sprache") + "</div>";
    h += "<div class='row'><label style='display:flex;align-items:center;gap:8px;cursor:pointer;'><input type='checkbox' id='saySave' style='width:auto;margin:0;'>Text speichern</label> " + infoTip("Speichert die Sprachdatei dieses Textes beim n&auml;chsten Sprechen dauerhaft, bevorzugt auf der SD-Karte (Ordner /ansagen), sonst im Ger&auml;t (Tab MP3 (Flash)). Danach wird der Haken wieder entfernt. Gespeicherte Texte werden bei gleicher Sprache, Stimme und gleichem Tempo gespielt, ohne VoiceRSS zu fragen, auch ohne Internet. Die aktuellen Klangeffekte werden mit gespeichert (im Dateinamen, zum Beispiel _halle40_b3_t-2) und gelten nur f&uuml;r diesen Text, unabh&auml;ngig von den sp&auml;teren Einstellungen") + "</div>";
    h += "<div class='row'><button type='button' onclick='sayNow()' style='width:150px'>Sprechen</button> " + infoTip("Sprechen: sagt den Text jetzt an, ein laufendes Webradio l&auml;uft danach weiter") + "</div>";
    h += "<div id='sayResult'></div><div class='row'><small id='playState'></small></div></div>";
    h += "<div class='card'><h3>Klangeffekte " + infoTip("Hall und Echo wirken auf Ansagen, Klangregler und Wandern auch auf abgespielte Dateien, nie auf Webradio. &Auml;nderungen gelten sofort und bleiben gespeichert. Der Verst&auml;rker spielt in Mono, der Raumeindruck ist deshalb begrenzt") + "</h3>";
    static const char* const FXN[] = {"Aus", "Zimmer", "Halle", "Kirche", "Echo"};
    h += "<div class='row'>Effekt <select id='fxMode' onchange='fxSend()' style='width:150px'>";
    for (int i = 0; i < 5; i++) h += String("<option value='") + i + "'" + (cfg.fxMode == i ? " selected" : "") + ">" + FXN[i] + "</option>";
    h += "</select> " + infoTip("Zimmer, Halle und Kirche sind Hall mit zunehmender Nachhallzeit; Echo wiederholt den Ton nach etwa 0,35 Sekunden. Aus: kein Effekt") + "</div>";
    h += "<div class='row'>Anteil <input type='range' id='fxWet' min='0' max='100' value='" + String(cfg.fxWet) + "' oninput=\"document.getElementById('fxWetV').textContent=this.value\" onchange='fxSend()' style='width:200px'> <span id='fxWetV'>" + String(cfg.fxWet) + "</span> % " + infoTip("Wie stark der Effekt zum Originalton gemischt wird, 0 bis 100 Prozent") + "</div>";
    h += "<div class='row'>B&auml;sse <input type='range' id='eqBass' min='-12' max='12' value='" + String(cfg.eqBass) + "' oninput=\"document.getElementById('eqBassV').textContent=this.value\" onchange='fxSend()' style='width:200px'> <span id='eqBassV'>" + String(cfg.eqBass) + "</span> dB " + infoTip("Tiefen unter etwa 200 Hz anheben oder absenken; 0 = unver&auml;ndert") + "</div>";
    h += "<div class='row'>H&ouml;hen <input type='range' id='eqTreble' min='-12' max='12' value='" + String(cfg.eqTreble) + "' oninput=\"document.getElementById('eqTrebleV').textContent=this.value\" onchange='fxSend()' style='width:200px'> <span id='eqTrebleV'>" + String(cfg.eqTreble) + "</span> dB " + infoTip("H&ouml;hen ab etwa 4 kHz anheben oder absenken; 0 = unver&auml;ndert") + "</div>";
    static const char* const PANN[] = {"Aus", "links &rarr; rechts", "rechts &rarr; links", "hin und her"};
    h += "<div class='row'>Wandern <select id='fxPan' onchange='fxSend()' style='width:170px'>";
    for (int i = 0; i < 4; i++) h += String("<option value='") + i + "'" + (cfg.panMode == i ? " selected" : "") + ">" + PANN[i] + "</option>";
    h += "</select> " + infoTip("Der Ton wandert beim Abspielen zwischen links und rechts. Zu h&ouml;ren nur mit zwei Verst&auml;rkern im Stereo-Aufbau, ein Modul mischt zu Mono. Bei links &rarr; rechts und rechts &rarr; links bleibt der Ton am Ende stehen, bei hin und her l&auml;uft die Bewegung weiter. Wirkt auf Ansagen und abgespielte Dateien, nie auf Webradio") + "</div>";
    h += "<div class='row'>Dauer <input type='range' id='fxPanSec' min='0.5' max='20' step='0.5' value='" + String(cfg.panDs / 10.0, 1) + "' oninput=\"document.getElementById('fxPanSecV').textContent=this.value\" onchange='fxSend()' style='width:200px'> <span id='fxPanSecV'>" + String(cfg.panDs / 10.0, 1) + "</span> s " + infoTip("Dauer eines Durchgangs von einer Seite zur anderen in Sekunden, 0,5 bis 20") + "</div>";
    h += "<div id='fxResult'></div></div>";
    return h;
}

// Zeile mit der Anzeige, was gerade laeuft, und dem Stopp-Knopf; steht oben in jedem Tab, der Wiedergabe startet.
// Row with the display of what is playing right now and the stop button; at the top of every tab that starts playback.

String nowPlayingRow() {
    return "<div class='row' style='min-height:2.4rem'><strong class='nowplaying' style='color:var(--ok)'></strong></div>";
}

// Belegung von LittleFS und SD-Karte: usedBytes() braucht 45 ms bis mehrere Hundert ms und haelt die Schleife (und den Ton) an; deshalb alle 15 s neu lesen oder nach Aenderungen an Dateien.
// Usage of LittleFS and SD card: usedBytes() takes 45 ms up to several hundred ms and holds up the loop (and the sound); so re-read every 15 s or after file changes.

static unsigned long storageRead = 0;
static size_t fsUsedC = 0, fsTotalC = 0;
static uint64_t sdUsedC = 0, sdTotalC = 0;

void storageInvalidate() {
    storageRead = 0;
}

void storageRefresh() {
    if (storageRead != 0 && millis() - storageRead < 15000UL) return;
    if (fsReady) {
        fsUsedC = LittleFS.usedBytes();
        fsTotalC = LittleFS.totalBytes();
    }
    if (sdReady) {
        sdUsedC = SD.usedBytes();
        sdTotalC = SD.totalBytes();
    }
    storageRead = millis();
    if (storageRead == 0) storageRead = 1;
}

String panelRadio() {
    String h = volumeRow() + nowPlayingRow();
    h += "<details id='radioInfoBox' style='display:none;max-width:500px;margin:0 auto 10px;text-align:left'><summary style='cursor:pointer;color:var(--muted)'>Stream-Info</summary><table id='radioInfo' style='width:100%;margin-top:6px'></table></details>";
    h += "<div class='card' id='favCard' style='max-width:900px'><h3>Favoriten " + infoTip("Eigene Liste mit deinen Lieblingssendern, unabh&auml;ngig von der Senderliste (bis zu 40). Sender lassen sich aus der gespeicherten Senderliste und aus jeder fertigen Liste von GitHub &uuml;bernehmen, direkt anh&ouml;ren und wieder entfernen") + "</h3><small id='favInfo'></small><div id='favList'></div>";
    h += "<div class='row' style='justify-content:flex-start;gap:8px'><button type='button' onclick='favToList()' style='width:auto;padding:8px 14px'>Als Senderliste &uuml;bernehmen</button> " + infoTip("Ersetzt die gespeicherte Senderliste durch die Favoriten") + "</div>";
    h += "<div class='row' style='justify-content:flex-start;gap:8px'><button type='button' onclick=\"location.href='/favorites.txt'\" style='width:auto;padding:8px 14px'>Favoriten speichern</button> " + infoTip("Speichert die Favoriten als Textdatei auf deinem Rechner; sie steht auch im Export der Einstellungen") + " ";
    h += "<button type='button' onclick=\"document.getElementById('favFile').click()\" style='width:auto;padding:8px 14px'>Favoriten laden</button><input type='file' id='favFile' accept='.txt' style='display:none' onchange='loadFavorites(this)'> " + infoTip("Ersetzt die Favoriten durch eine zuvor gespeicherte Datei") + "</div>";
    h += "<div id='favResult'></div></div>";
    h += "<div class='card'><h3>Webradio-URL abspielen</h3><div class='row'>";
    h += "<input id='playUrl' placeholder='https://...' style='width:90%'><button type='button' onclick='playUrlNow()' style='width:150px'>URL abspielen</button> " + infoTip("Adresse eines Webradios oder einer MP3-Datei (http:// oder https://); sie wird jetzt abgespielt, aber nicht gespeichert") + "</div><div id='radioResult'></div></div>";

    // Belegte Plaetze plus der erste freie werden angezeigt; nach dem Speichern erscheint der naechste freie.
    // Used slots plus the first free one are shown; after saving the next free one appears.

    int firstEmpty = -1;
    int used = 0;
    for (int i = 0; i < RADIO_SLOTS; i++) {
        if (cfg.radioUrl[i].isEmpty()) {
            if (firstEmpty < 0) firstEmpty = i;
        } else {
            used++;
        }
    }
    h += "<div class='card' style='max-width:900px'><h3>Gespeicherte Webradios / URLs " + infoTip("Pro Platz: Name (beliebig, auch per REST und MQTT abrufbar), URL (Webradio oder MP3; leer lassen und speichern gibt den Platz frei) und Lautst&auml;rke des Senders (0-100, leer = allgemeine Lautst&auml;rke)") + "</h3><small>" + String(used) + " von " + String(RADIO_SLOTS) + " Pl&auml;tzen belegt</small><form method='POST' action='/save'><input type='hidden' name='sect' value='radio'>";
    for (int i = 0; i < RADIO_SLOTS; i++) {
        if (cfg.radioUrl[i].isEmpty() && i != firstEmpty) continue;
        audioPump();
        String n = String(i + 1);
        h += "<div class='row stationrow' data-n='" + n + "' data-url='" + htmlEsc(cfg.radioUrl[i]) + "'><span style='width:1.6rem;text-align:right;color:var(--muted)'>" + n + "</span>";
        h += "<input name='rn" + n + "' maxlength='" + String(RADIO_NAME_MAX) + "' placeholder='Name' value='" + htmlEsc(cfg.radioName[i]) + "' style='width:150px'>";
        h += "<input name='ru" + n + "' maxlength='" + String(RADIO_URL_MAX) + "' placeholder='http://...' value='" + htmlEsc(cfg.radioUrl[i]) + "' style='width:300px'>";
        h += "<input type='number' name='rv" + n + "' min='0' max='" + String(VOLUME_MAX) + "' placeholder='Std' value='" + (cfg.radioVol[i] >= 0 ? String(cfg.radioVol[i]) : String()) + "' style='width:64px'>";
        String off = cfg.radioUrl[i].isEmpty() ? " disabled" : "";
        h += "<button type='button' class='copy-btn' style='position:static;margin:2px' title='Nach oben schieben (speichert sofort)' onclick='moveStation(" + n + ",-1)'" + off + ">&#9650;</button>";
        h += "<button type='button' class='copy-btn' style='position:static;margin:2px' title='Nach unten schieben (speichert sofort)' onclick='moveStation(" + n + ",1)'" + off + ">&#9660;</button>";
        h += "<button type='button' class='copy-btn' style='position:static;margin:2px' title='Zu den Favoriten hinzuf&uuml;gen' onclick='favAddStation(" + n + ")'" + off + ">+</button>";
        h += "<button type='button' class='playbtn' onclick='playStation(" + n + ")' title='Abspielen' style='width:auto;padding:8px 14px'" + off + ">&#9654;</button>";
        h += "<button type='button' class='copy-btn' style='position:static;margin:2px' title='Aufruf per REST und MQTT anzeigen' onclick='stationCall(" + n + ",this)'" + off + ">API</button>";
        h += "<button type='button' class='copy-btn' style='position:static;margin:2px' title='Platz l&ouml;schen (Name und URL); die folgenden Pl&auml;tze r&uuml;cken auf' onclick='delStation(" + n + ")'" + off + ">&#10006;</button></div>";
    }
    h += "<small>Das Feld rechts neben der URL ist die Lautst&auml;rke des Senders (0-100, leer = allgemeine Lautst&auml;rke). Speichern, bevor du &#9654; dr&uuml;ckst. &#9650;&#9660; verschieben den Sender und speichern sofort. Der URL-Knopf kopiert den REST-Aufruf mit Beispielwerten f&uuml;r alle Parameter, zum Beispiel <code>/api/station?n=Platz&amp;vol=60</code>; auch der Name geht (<code>?name=...</code>).</small>";
    h += "<button type='submit'>Speichern</button><div id='stResult'></div></form>";
    h += "<div style='margin-top:18px;padding-top:12px;border-top:1px solid var(--panel-border)'><h3 style='margin:0 0 6px'>Senderlisten</h3>";
    h += "<div class='row' style='justify-content:flex-start;gap:8px'><span style='min-width:110px;text-align:left'>Eigene Liste</span><button type='button' onclick=\"location.href='/stations.txt'\" style='width:auto;padding:8px 14px'>Liste speichern</button> " + infoTip("Speichert die Senderliste (Name, URL, Lautst&auml;rke) als Textdatei auf deinem Rechner") + " ";
    h += "<button type='button' onclick=\"document.getElementById('stFile').click()\" style='width:auto;padding:8px 14px'>Liste laden</button><input type='file' id='stFile' accept='.txt' style='display:none' onchange='loadStations(this)'> " + infoTip("Ersetzt die gespeicherte Senderliste durch eine zuvor gespeicherte Datei") + "</div>";
    h += "<div class='row' style='justify-content:flex-start;gap:8px'><span style='min-width:110px;text-align:left'>Fertige Liste</span><select id='stList' style='width:auto'><option>aac-auswahl</option><option>mp3-auswahl</option><option>rock</option><option>entspannung</option><option>schlager</option><option>country</option><option>folk</option><option>jazz</option><option>klassik</option><option>pop-charts</option><option>jahrzehnte</option><option>dance</option><option>hiphop</option><option>irland</option><option>usa</option><option>australien</option><option>grossbritannien</option><option>frankreich</option></select><button type='button' onclick='listFetch()' style='width:auto;padding:8px 14px'>Von GitHub laden</button> " + infoTip("L&auml;dt eine fertige Senderliste aus dem Ordner stations des Projekts auf GitHub und ersetzt die gespeicherte Liste; das Ger&auml;t braucht dazu Internet") + "</div>";
    h += "<div class='row' style='justify-content:flex-start;gap:8px'><span style='min-width:110px;text-align:left'>Sender meines Landes</span><select id='rbCountry' style='width:auto'></select><select id='rbGenre' style='width:auto'><option value=''>Alle Genres</option><option>pop</option><option>rock</option><option>jazz</option><option>classical</option><option>country</option><option>folk</option><option>electronic</option><option>dance</option><option>hip hop</option><option>oldies</option><option>80s</option><option>90s</option><option>schlager</option><option>lounge</option><option>reggae</option><option>latin</option><option>world</option><option>metal</option><option>blues</option><option>soul</option><option value='christmas'>Weihnachten</option></select><button type='button' onclick='rbLoad()' style='width:auto;padding:8px 14px'>Von radio-browser laden</button> " + infoTip("Holt die beliebtesten Sender des gew&auml;hlten Landes (optional eines Genres) aus dem offenen Verzeichnis radio-browser.info und ersetzt die gespeicherte Senderliste; nur Sender mit MP3 oder AAC, die zuletzt erreichbar waren, h&ouml;chstens 30. Der Browser ruft das Verzeichnis ab, das Ger&auml;t braucht dazu nichts. Die Favoriten stehen danach vorn") + "</div><div id='stListResult'></div></div></div>";
    return h;
}

String panelSd() {
    String h = volumeRow() + nowPlayingRow();
    h += "<div class='card' style='max-width:900px'><h3>SD-Karte</h3><small id='sdInfo'>Lade &hellip;</small><div id='sdMem'></div><div id='sdPath' style='margin:6px 0;color:var(--muted)'></div><div id='sdList'></div>";
    h += "<div class='row'><input type='file' id='sdUpFile' multiple accept='.mp3' style='width:55%'><button type='button' onclick='sdUploadNow()' style='width:auto;padding:8px 14px'>Hochladen</button> " + infoTip("Eine oder mehrere MP3-Dateien w&auml;hlen; sie werden nacheinander in den gezeigten Ordner der Karte hochgeladen") + "</div>";
    h += "<div class='row'><button type='button' onclick='sdLoad(sdCur)' style='width:auto;padding:8px 14px'>Aktualisieren</button><button type='button' onclick='sdMkdir()' style='width:auto;padding:8px 14px'>Neuer Ordner</button><button type='button' onclick='sdRemount()' style='width:auto;padding:8px 14px'>Neu einbinden</button> <label style='display:inline-flex;align-items:center;gap:4px'><input type='checkbox' id='sdLoop'> Endlos</label> " + infoTip("Aktualisieren: liest den gezeigten Ordner neu. Neuer Ordner: legt einen Ordner im gezeigten Ordner an. Neu einbinden: bindet die Karte neu ein, zum Beispiel nach dem Einstecken. Endlos: nach der letzten Datei eines Ordners beginnt eine neue Runde. Zufall (Knopf am Ordner): jede Datei kommt je Sitzung einmal, die Reihenfolge ist jedes Mal eine andere und beginnt nie mit der Datei der letzten Sitzung") + "</div><div id='sdResult'></div></div>";
    return h;
}

String panelPins() {
    String h = "<div class='card' style='max-width:900px'><div style='display:flex;justify-content:space-between;align-items:center;gap:10px'><h3 style='margin:0'>Eing&auml;nge (Pull-up)</h3><button type='button' id='pinSave' style='width:auto;padding:8px 18px'>Speichern</button></div>";
    h += "<p>Alle freien Pins liegen mit Pull-up auf High. Bekommt ein Pin Kontakt nach GND (zum Beispiel durch eine Taste), spielt das Ger&auml;t die gew&auml;hlte Ansage, MP3-Datei oder den gew&auml;hlten Webradio-Sender. Nicht angezeigt werden die Pins von Verst&auml;rker und SD-Karte, die Strapping-Pins und die Status-LED. " + infoTip("Aktion: Ansage = Text, der &uuml;ber VoiceRSS gesprochen wird. MP3-Datei = Dateiname aus dem Tab MP3 (Flash), sd:/Pfad.mp3 oder sd:/Ordner/ von der SD-Karte oder eine URL (http:// oder https://). Webradio = gespeicherter Sender, Name oder Platznummer aus dem Tab Webradio. Radio starten = spielt den zuletzt gespielten Sender (sonst den ersten gespeicherten), Sender vor/zur&uuml;ck = n&auml;chster/vorheriger gespeicherter Sender, Lauter/Leiser = Schrittweite im Feld Lautst&auml;rke (Standard 5), Stumm schaltet um, Stopp beendet die Wiedergabe. Die Lautst&auml;rke ist optional (0-100, leer = allgemeine). Der Pin muss etwa 40 ms auf GND bleiben; ausgel&ouml;st wird einmal je Tastendruck") + "</p>";
    h += "<table id='pinTable' style='width:100%'></table><div id='pinResult'></div></div>";
    return h;
}

String panelMp3() {
    String h = volumeRow() + nowPlayingRow();
    h += "<div class='card' style='max-width:900px'><h3>Dateien im Ger&auml;t</h3><div id='fsMem'></div><div id='fileList'>Lade &hellip;</div><hr>";
    h += "<div class='row'><input type='file' id='upFile' multiple accept='.mp3' style='width:90%'><button type='button' onclick='uploadNow()' style='width:150px'>Hochladen</button> " + infoTip("Eine oder mehrere MP3-Dateien vom Rechner w&auml;hlen; sie werden nacheinander in den Speicher des Ger&auml;ts geladen") + "</div>";
    h += "<div id='upResult'></div></div>";
    return h;
}

// Auswahlfeld fuer einen Pin: alle erlaubten GPIOs des ESP32-S3; ein gespeicherter, nicht erlaubter Wert bleibt sichtbar.
// Select field for a pin: all allowed GPIOs of the ESP32-S3; a stored value that is not allowed stays visible.

String pinSelect(const char* name, int value) {
    String s = String("<select class='pinsel' name='") + name + "' onchange='checkPins()' style='width:130px'>";
    bool found = false;
    for (int p = 0; p <= 48; p++) {
        if (!pinAllowed(p)) continue;
        if (p == value) found = true;
        s += "<option value='" + String(p) + "'" + (p == value ? " selected" : "") + ">GPIO " + String(p) + "</option>";
    }
    if (!found) s += "<option value='" + String(value) + "' selected>GPIO " + String(value) + " (nicht erlaubt)</option>";
    return s + "</select>";
}

String pinRow(const char* label, const char* name, int value, const char* title) {
    return String("<div class='row pinrow'><span class='pinlabel'>") + label + "</span>" + pinSelect(name, value) + " " + infoTip(title) + "</div>";
}

// Der Tab Audio fasst alles zusammen, was Ton und Sprache betrifft, in getrennten Karten; ein Speichern gilt fuer alle.
// The Audio tab gathers everything about sound and speech in separate cards; one save applies to all.

String panelAudio() {
    String h = "<form method='POST' action='/save'><input type='hidden' name='sect' value='audio'>";
    h += "<div class='card wide'><h3>Anschl&uuml;sse</h3>";
    h += "<div class='sub'><h4>Verst&auml;rker (I2S, MAX98357A)</h4>";
    h += pinRow("DIN (Daten)", "din", cfg.din, "GPIO f&uuml;r die Daten (DIN) zum Verst&auml;rker; wirkt nach einem Neustart");
    h += pinRow("BCLK (Bit-Takt)", "bclk", cfg.bclk, "GPIO f&uuml;r den Bit-Takt (BCLK) des Verst&auml;rkers; wirkt nach einem Neustart");
    h += pinRow("LRC (Wort-Takt)", "lrc", cfg.lrc, "GPIO f&uuml;r den Wort-Takt (LRC/WS) des Verst&auml;rkers; wirkt nach einem Neustart");
    h += "<small>&Auml;nderungen an diesen Pins wirken nach einem Neustart.</small></div>";
    h += "<div class='sub'><h4>SD-Karte (SPI)</h4>";
    h += "<div class='row'><label style='display:flex;align-items:center;gap:8px;cursor:pointer;'><input type='checkbox' name='sdon' value='1'" + String(cfg.sdOn ? " checked" : "") + " style='width:auto;margin:0;'>SD-Karte verwenden</label> " + infoTip("SD-Karte im SPI-Modus verwenden; ohne Karte l&auml;uft alles andere weiter") + "</div>";
    h += pinRow("MISO (Daten von der Karte)", "sdmiso", cfg.sdMiso, "Daten von der Karte (MISO/DO); &Auml;nderungen wirken sofort");
    h += pinRow("SCK (Takt)", "sdsck", cfg.sdSck, "Takt (CLK) der SD-Karte; &Auml;nderungen wirken sofort");
    h += pinRow("MOSI (Daten zur Karte)", "sdmosi", cfg.sdMosi, "Daten zur Karte (MOSI/DI); &Auml;nderungen wirken sofort");
    h += pinRow("CS (Chip-Select)", "sdcs", cfg.sdCs, "Chip-Select der SD-Karte; &Auml;nderungen wirken sofort");
    h += "<small>&Auml;nderungen an den SD-Pins wirken sofort, die Karte wird neu eingebunden.</small></div>";
    h += "<small id='pinWarn' class='pinwarn'></small>";
    h += "<small>Erlaubte Pins am ESP32-S3: 1-18, 21, 33-42, 47, 48. Jeder Pin darf nur einmal vergeben sein; sonst werden die Pins nicht gespeichert.</small></div>";
    h += "<div class='card wide'><h3>Lautst&auml;rke</h3>";
    h += "<div class='row'>Standard-Lautst&auml;rke (0-" + String(VOLUME_MAX) + ") " + infoTip("Lautst&auml;rke, die nach dem Start gilt und wenn nichts anderes eingestellt ist") + " <input type='number' name='vol' min='0' max='" + String(VOLUME_MAX) + "' value='" + String(cfg.vol) + "' style='width:90px'></div>";
    h += "<div class='row'>Lautst&auml;rke &auml;ndern (ms) " + infoTip("Dauer, in der eine ge&auml;nderte Lautst&auml;rke (Regler, REST, MQTT) bei laufendem Ton zum neuen Wert wandert; 0 = sofort. Per REST und MQTT l&auml;sst sich die Dauer je Aufruf mit ms angeben") + " <input type='number' name='vramp' min='0' max='" + String(VOLUME_RAMP_MAX_MS) + "' step='100' value='" + String(cfg.volRampMs) + "' style='width:90px'></div>";
    h += "</div>";
    h += "<div class='card wide'><h3>&Uuml;berblenden und Mischen</h3>";
    h += "<div class='sub'><h4>Webradio ein- und ausblenden</h4>";
    h += "<div class='row'>Radio aus-/einblenden (ms) " + infoTip("Dauer, in der ein laufendes Webradio vor einer Ansage oder MP3-Datei auf Lautst&auml;rke 0 ausgeblendet und nach der Fortsetzung wieder eingeblendet wird; auch das Absenken beim Mischen nutzt diese Zeit; 0 = sofort") + " <input type='number' name='fade' min='0' max='" + String(FADE_MAX_MS) + "' step='100' value='" + String(cfg.fadeMs) + "' style='width:90px'></div>";
    h += "<div class='row'>Radio Start/Stopp/Wechsel (ms) " + infoTip("Dauer des Einblendens beim Start eines Webradios, des Ausblendens beim Stopp und beider beim Senderwechsel; 0 = sofort") + " <input type='number' name='swfade' min='0' max='" + String(FADE_MAX_MS) + "' step='100' value='" + String(cfg.switchFadeMs) + "' style='width:90px'></div>";
    h += "</div><div class='sub'><h4>Ansagen &uuml;ber dem Radio</h4>";
    h += "<div class='row'><label style='display:flex;align-items:center;gap:8px;cursor:pointer;'><input type='checkbox' name='mix' value='1'" + String(cfg.mixAnn ? " checked" : "") + " style='width:auto;margin:0;'>Radio unter Ansagen weiterlaufen lassen</label> " + infoTip("Ansagen (und bei Webradio auch MP3-Dateien) werden leise &uuml;ber das laufende Webradio oder eine laufende MP3-Datei gelegt, die ohne Unterbrechung weiterl&auml;uft. Aus: das Radio stoppt f&uuml;r die Ansage und wird danach neu verbunden; eine MP3-Datei stoppt ebenfalls") + " Radio dabei auf <input type='number' name='duck' min='0' max='100' value='" + String(cfg.duckPct) + "' style='width:64px'> % " + infoTip("Lautst&auml;rke des Radios w&auml;hrend der Ansage in Prozent der eingestellten Lautst&auml;rke") + "</div>";
    h += "<div class='row'><label style='display:flex;align-items:center;gap:8px;cursor:pointer;'><input type='checkbox' name='loud' value='1'" + String(cfg.loudNorm ? " checked" : "") + " style='width:auto;margin:0;'>MP3-Lautst&auml;rke angleichen</label> " + infoTip("Beim ersten Abspielen einer MP3-Datei misst das Ger&auml;t im Hintergrund ihre Lautst&auml;rke und gleicht sie auf einen einheitlichen Pegel an; der Ausgleich wird gespeichert, die Datei selbst bleibt unver&auml;ndert. W&auml;hrend der Messung (einige Sekunden bis eine Minute) l&auml;uft die Datei noch unver&auml;ndert und wird dann sanft angepasst. Ansagen und Radio bleiben unver&auml;ndert") + "</div>";
    h += "<div class='row'><label style='display:flex;align-items:center;gap:8px;cursor:pointer;'><input type='checkbox' name='agc' value='1'" + String(cfg.radioAgc ? " checked" : "") + " style='width:auto;margin:0;'>Webradio-Lautst&auml;rke angleichen</label> " + infoTip("Misst laufend den Pegel des Webradios und f&uuml;hrt die Verst&auml;rkung langsam auf den Zielpegel nach (hoch in etwa 5 s, runter in etwa 1 s, h&ouml;chstens 12 dB), so klingen laute und leise Sender &auml;hnlich; Spitzen bleiben unter -1 dBFS. Wirkt nur auf Webradio, nicht auf Ansagen und Dateien. Die Lautst&auml;rke je Sender in der Senderliste bleibt zus&auml;tzlich wirksam") + "</div>";
    h += "<div class='row'>Zielpegel Webradio (dBFS) " + infoTip("Mittlerer Pegel, auf den die Angleichung zielt: -30 (leise) bis -10 (laut); -18 ist ein guter Anfang. Gilt nur mit dem Haken oben") + " <input type='number' name='agcdb' min='-30' max='-10' value='" + String(cfg.agcDb) + "' style='width:70px'></div>";
    h += "<div class='row'>Vorpuffer Webradio (Sekunden) " + infoTip("Das Radio beginnt erst zu spielen, wenn so viele Sekunden Ton im Puffer liegen. Ein gr&ouml;&szlig;erer Wert &uuml;berbr&uuml;ckt kurze Aussetzer des Streams (Meldung slow stream), der Ton kommt nach dem Start eines Senders aber entsprechend später. 0 bis 30, Standard 5") + " <input type='number' name='prebuf' min='0' max='30' value='" + String(cfg.prebufSec) + "' style='width:70px'></div>";
    h += "</div><div class='sub'><h4>Titelregel</h4>";
    h += "<div class='row'>Titelregel: Titel enth&auml;lt " + infoTip("Stichworte der Titelregel:&#10;&#8226; Mehrere Stichworte mit Komma oder Semikolon trennen.&#10;&#8226; Gro&szlig;-/Kleinschreibung ist egal; es gen&uuml;gt, wenn der Titel das Stichwort enth&auml;lt.&#10;&#8226; Mit =Wert (0-100) bekommt ein Stichwort eine eigene Lautst&auml;rke, zum Beispiel: Cambodia=90, Thunder&#10;&#8226; Leer = Regel aus") + " <input name='tmatch' maxlength='120' value='" + htmlEsc(cfg.titleMatch) + "' placeholder='z. B. Cambodia, Thunder=90' style='width:280px'> Lautst&auml;rke <input type='number' name='tvol' min='0' max='" + String(VOLUME_MAX) + "' value='" + String(cfg.titleVol) + "' style='width:64px'> " + infoTip("Lautst&auml;rke (0-100) f&uuml;r Stichworte ohne eigenen Wert; sie gilt, solange der Titel l&auml;uft, danach wieder die vorherige") + " h&ouml;chstens <input type='number' name='tmax' min='0' max='3600' value='" + String(cfg.titleMaxS) + "' style='width:70px'> s " + infoTip("Ein Sender meldet das Ende eines Titels nicht. Mit einem Wert gr&ouml;&szlig;er als 0 endet die Titelregel nach so vielen Sekunden (zum Beispiel 210 f&uuml;r einen Titel von 3:30), damit Werbung nach dem Titel nicht laut bleibt; 0 = bis zum n&auml;chsten Titel") + "</div>";
    h += "</div></div>";
    h += "<div class='card wide'><h3>Start</h3>";
    h += "<div class='row'><label style='display:flex;align-items:center;gap:8px;cursor:pointer;'><input type='checkbox' name='autostart' value='1'" + String(cfg.autoStart ? " checked" : "") + " style='width:auto;margin:0;'>Beim Start Sender 1 abspielen</label> " + infoTip("Spielt nach dem Start nach einigen Sekunden Sender 1 der Liste ab, sobald das WLAN steht und der Stream antwortet. Ausgeschaltet bleibt das Ger&auml;t nach dem Start stumm") + "</div>";
    h += "<div class='row'><label style='display:flex;align-items:center;gap:8px;cursor:pointer;'><input type='checkbox' name='btone' value='1'" + String(cfg.bootTone ? " checked" : "") + " style='width:auto;margin:0;'>Kurzer Ton beim Start</label> " + infoTip("Beim Einschalten und nach einem Neustart &uuml;ber die Weboberfl&auml;che spielt das Ger&auml;t einen kurzen Ton (&bdquo;buub&ldquo;) immer mit Lautst&auml;rke 50, unabh&auml;ngig von der allgemeinen Lautst&auml;rke. Nach einem Neustart per MQTT, nach einem Absturz und im abgesicherten Modus bleibt er aus") + "</div>";
    h += "<small>Aus (Standard): Das Ger&auml;t startet stumm. An: Nach dem Start spielt es nach einigen Sekunden Sender 1 der Liste im Tab Webradio, sobald der Stream antwortet (bis zu 10 Versuche im Abstand von 6 s).</small><br>";
    h += "<div class='row'><label style='display:flex;align-items:center;gap:8px;cursor:pointer;'><input type='checkbox' name='resume' value='1'" + String(cfg.resumeLast ? " checked" : "") + " style='width:auto;margin:0;'>Zuletzt gespielten Sender nach einem Neustart fortsetzen</label> " + infoTip("Merkt sich den laufenden Sender mit seiner Lautst&auml;rke und spielt ihn nach einem Neustart oder Stromausfall wieder ab; ein Stopp l&ouml;scht den Merker") + "</div>";
    h += "<small>Das Ger&auml;t merkt sich Sender und Lautst&auml;rke (erst wenn die Lautst&auml;rke 3 s unver&auml;ndert ist). Nach einem Neustart spielt es ihn wieder ab, mit derselben Lautst&auml;rke; ein Stopp l&ouml;scht den Merker, dann startet das Ger&auml;t stumm. Hat dieser Haken Vorrang vor &bdquo;Beim Start Sender 1 abspielen&ldquo;.</small>";
    h += "</div>";
    h += "<div class='card wide'><h3>Sprachausgabe (VoiceRSS)</h3>";
    h += "<div class='row'><input type='text' name='vkey' maxlength='64' placeholder='API-Schl&uuml;ssel' value='" + htmlEsc(cfg.vkey) + "' autocomplete='off' style='width:260px'> " + infoTip("API-Schl&uuml;ssel von voicerss.org; ein leeres Feld l&ouml;scht ihn") + "</div>";
    h += "<small>Der Schl&uuml;ssel wird angezeigt; ein leeres Feld l&ouml;scht ihn. Er steht verschl&uuml;sselt im Export der Einstellungen (nur aus dem lokalen Netz) und kommt mit dem Import auf ein neues Ger&auml;t. Kostenloser Schl&uuml;ssel: voicerss.org</small>";
    h += "<div class='row'><select name='vlang' id='cfgLang' onchange=\"fillVoiceSel('cfgVoice',this.value,false)\" style='width:260px'>" + selectOptions(LANG_VALUES, LANG_LABELS, LANG_COUNT, cfg.vlang) + "</select> " + infoTip("Standardsprache f&uuml;r Ansagen") + "</div>";
    h += "<div class='row'><select name='vvoice' id='cfgVoice' onchange='voiceChosen(this)' style='width:260px'><option value=''>Standard (VoiceRSS)</option>" + (cfg.vvoice.length() > 0 ? "<option value='" + htmlEsc(cfg.vvoice) + "' selected>" + htmlEsc(cfg.vvoice) + "</option>" : String()) + "</select> " + infoTip("Standardstimme f&uuml;r Ansagen; Standard = Standardstimme der Sprache") + "</div>";
    h += "<div class='row'>Tempo (-10 bis 10): " + infoTip("Sprechtempo: -10 = sehr langsam, 0 = normal, 10 = sehr schnell") + " <input type='number' name='vrate' min='-10' max='10' value='" + String(cfg.vrate) + "' style='width:90px'></div>";
    h += "<div class='row'><select name='vfmt' style='width:260px'>" + selectOptions(FMT_VALUES, FMT_LABELS, 4, cfg.vfmt) + "</select> " + infoTip("Audioformat der Sprachdatei: kleiner = schneller geladen, gr&ouml;&szlig;er = bessere Qualit&auml;t") + "</div>";
    h += "<div class='row'><label style='display:flex;align-items:center;gap:8px;cursor:pointer;'><input type='checkbox' name='ttsc' value='1'" + String(cfg.ttsCache ? " checked" : "") + " style='width:auto;margin:0;'>Ansagen auf der SD-Karte zwischenspeichern</label> " + infoTip("Ein einmal von VoiceRSS geholter Text wird als MP3 im Ordner /tts der SD-Karte abgelegt; der Dateiname beginnt mit einem Hinweis auf den Text, zum Beispiel Achtung_auf_Gleis_3_3fa9c2e1.mp3. Derselbe Text mit gleicher Sprache, Stimme, Tempo und gleichem Format wird danach von der Karte gespielt, ohne Internet und ohne VoiceRSS-Anfrage. Es bleiben h&ouml;chstens 500 Dateien, die &auml;ltesten werden gel&ouml;scht. Ohne Karte l&auml;uft alles wie bisher") + "</div>";
    h += "<div class='row'><button type='button' onclick='ttsClear()' style='width:auto;padding:8px 14px'>Zwischenspeicher leeren</button> <span id='ttsInfo'></span> <span id='ttsResult'></span> " + infoTip("L&ouml;scht alle zwischengespeicherten Ansagen von der SD-Karte (Ordner /tts); sie werden bei Bedarf neu von VoiceRSS geholt") + "</div>";
    h += "<div class='row'><button type='button' onclick='voiceTest()' style='width:auto;padding:8px 14px'>Stimme testen</button> " + infoTip("Spricht einen kurzen Beispielsatz in der gew&auml;hlten Sprache, Stimme und mit dem eingestellten Tempo, auch ohne vorher zu speichern. Der API-Schl&uuml;ssel und das Audioformat m&uuml;ssen dazu gespeichert sein") + "</div><div id='voiceTestResult'></div>";
    h += "</div>";
    h += "<div style='text-align:center'><button type='submit'>Speichern</button></div></form>";
    return h;
}

// Eine Zeile der Topic-Tabelle: Topic mit Kopierknopf, Art (Befehl = senden, Meldung = lesen), Nutzlast, Beispiele.
// One row of the topic table: topic with copy button, kind (command = send, message = read), payload, examples.

String mqttRow(const String& base, const char* suffix, bool command, const char* payloadText, const char* const* examples, int exampleCount) {
    String topic = base + suffix;
    String h = "<tr><td><code>" + htmlEsc(topic) + "</code><br><button type='button' class='copy-btn' style='position:static;margin:4px 0 0' data-copy='" + htmlEsc(topic) + "' onclick='copyText(this.getAttribute(\"data-copy\"),this)' title='Topic kopieren'>Kopieren</button></td>";
    h += String("<td><span class='kind ") + (command ? "cmd'>senden" : "msg'>lesen") + "</span></td><td>" + payloadText + "</td><td>";
    for (int i = 0; i < exampleCount; i++) h += "<code class='ex'>" + htmlEsc(examples[i]) + "</code>";
    return h + "</td></tr>";
}

String panelMqtt() {
    String base = mqttBaseTopic();
    String h = "<div class='card mqtt' style='max-width:1000px'><h3>MQTT</h3><form method='POST' action='/save'><input type='hidden' name='sect' value='mqtt'>";
    h += "<div class='row' style='justify-content:flex-start;gap:6px 18px'>";
    h += "<span style='display:inline-flex;align-items:center;gap:6px'><label for='mq_srv' style='white-space:nowrap'>Broker " + infoTip("Adresse des MQTT-Brokers; leer = MQTT aus") + "</label><input id='mq_srv' name='mq_srv' placeholder='z. B. 192.168.0.70 (leer = MQTT aus)' value='" + htmlEsc(cfg.mqttServer) + "' style='width:min(100%,300px);margin:4px 0'></span>";
    h += "<span style='display:inline-flex;align-items:center;gap:6px'><label for='mq_port' style='white-space:nowrap'>Port " + infoTip("Port des Brokers, meist 1883") + "</label><input id='mq_port' type='number' name='mq_port' min='1' max='65535' value='" + String(cfg.mqttPort) + "' style='width:100px;margin:4px 0'></span></div>";
    h += "<div class='row' style='justify-content:flex-start;gap:6px 18px'>";
    h += "<span style='display:inline-flex;align-items:center;gap:6px'><label for='mq_user' style='white-space:nowrap'>Benutzer " + infoTip("Benutzername f&uuml;r den MQTT-Broker (optional); leer = ohne Anmeldung") + "</label><input id='mq_user' name='mq_user' autocomplete='off' placeholder='optional' value='" + htmlEsc(cfg.mqttUser) + "' style='width:min(100%,200px);margin:4px 0'></span>";
    h += "<span style='display:inline-flex;align-items:center;gap:6px'><label for='mq_pass' style='white-space:nowrap'>Passwort " + infoTip("Passwort f&uuml;r den MQTT-Broker (optional); es wird nicht angezeigt, steht aber verschl&uuml;sselt in der Sicherung. Leer lassen, um das gespeicherte zu behalten; ohne Benutzer wird es gel&ouml;scht") + "</label><input id='mq_pass' name='mq_pass' type='password' autocomplete='new-password' placeholder='" + String(cfg.mqttPass.length() > 0 ? "gespeichert (leer lassen = behalten)" : "optional") + "' value='' style='width:min(100%,260px);margin:4px 0'></span></div>";
    h += "<div class='row' style='justify-content:flex-start'><span style='display:inline-flex;align-items:center;gap:6px;flex-wrap:wrap'><label for='mq_base' style='white-space:nowrap'>Basis-Topic " + infoTip("Basis-Topic; darunter liegen say, play, url, file, station, stop, volume, restart, status") + "</label><input id='mq_base' name='mq_base' placeholder='" + htmlEsc(String(PROJECT_NAME) + "/" + cfg.host) + "' value='" + htmlEsc(cfg.mqttBase) + "' style='width:min(100%,420px);margin:4px 0'></span></div>";
    h += "<div class='row'><label style='display:flex;align-items:center;gap:8px;cursor:pointer;'><input type='checkbox' name='mq_ha' value='1'" + String(cfg.haDisc ? " checked" : "") + " style='width:auto;margin:0;'>Home Assistant Discovery</label> " + infoTip("Meldet das Ger&auml;t bei Home Assistant an (MQTT Discovery): Status, Titel, Lautst&auml;rke, Ansage, Stopp und Senderauswahl erscheinen dort von selbst. Nur n&ouml;tig, wenn du Home Assistant benutzt") + "</div>";
    int grpVisible = 1;
    for (int i = 0; i < 5; i++) {
        if (!cfg.mqttGroup[i].isEmpty()) grpVisible = i + 2;
    }
    if (grpVisible > 5) grpVisible = 5;
    for (int i = 1; i <= 5; i++) {
        String n = String(i);
        h += "<div id='grpRow" + n + "' class='row' style='justify-content:flex-start;" + String(i > grpVisible ? "display:none" : "") + "'><span style='display:inline-flex;align-items:center;gap:6px;flex-wrap:wrap'><label for='mq_g" + n + "' style='white-space:nowrap'>Gruppen-Topic " + n + " " + infoTip("Zus&auml;tzliches Abo, um mehrere Ger&auml;te mit einem Befehl anzusprechen: Das Ger&auml;t nimmt unter diesem Topic dieselben Befehle an wie unter dem Basis-Topic (say, play, url, file, station, list, stop, volume, restart), zum Beispiel netspeaker/all/stop. Bis zu 5, leere Felder werden &uuml;bersprungen") + "</label><input id='mq_g" + n + "' name='mq_g" + n + "' placeholder='z. B. netspeaker/all' value='" + htmlEsc(cfg.mqttGroup[i - 1]) + "' oninput='grpGrow(" + n + ")' style='width:min(100%,420px);margin:4px 0'></span></div>";
    }
    h += "<p><small style='font-size:.9rem'>Leer = <code>netspeaker/&lt;Hostname&gt;</code>. Bereits gespeicherte Topics folgen einem neuen Hostnamen nicht automatisch. Status: <strong>" + String(mqttClient.connected() ? "verbunden" : (cfg.mqttServer.isEmpty() ? "aus" : "nicht verbunden")) + "</strong>.</small></p>";
    h += "<button type='submit' style='width:auto;padding:10px 28px'>Speichern</button></form>";
    h += "<h3 style='margin-top:1.4rem'>Topics</h3><p>Befehle sendest du an die Topics mit <span class='kind cmd'>senden</span>, Meldungen liest du von denen mit <span class='kind msg'>lesen</span> (die meisten sind <em>retained</em>, du bekommst den letzten Stand sofort beim Abonnieren). Als Nutzlast geht Text oder JSON.</p>";
    h += "<table><tr><th>Topic</th><th>Art</th><th>Nutzlast</th><th>Beispiele</th></tr>";
    static const char* const exSay[] = {"Das Abendessen ist fertig", "{\"text\":\"Es klingelt an der T\xC3\xBCr\",\"lang\":\"de-de\",\"voice\":\"Hanna\",\"vol\":15}"};
    static const char* const exPlay[] = {"https://dispatcher.rndfnk.com/br/br3/live/mp3/mid", "klingel.mp3", "{\"file\":\"klingel.mp3\",\"vol\":18}"};
    static const char* const exUrl[] = {"https://dispatcher.rndfnk.com/br/br3/live/mp3/mid"};
    static const char* const exFile[] = {"klingel.mp3"};
    static const char* const exStation[] = {"2", "BR3", "{\"name\":\"BR3\",\"vol\":8}"};
    static const char* const exStop[] = {"(leer)"};
    static const char* const exVol[] = {"50", "{\"v\":60,\"ms\":3000}"};
    static const char* const exList[] = {"(leer)"};
    static const char* const exRestart[] = {"(leer)"};
    static const char* const exStatus[] = {"idle", "playing", "error: File not found: /mp3/klingel.mp3"};
    static const char* const exNow[] = {"BR3 - K\xC3\xBCnstler - Titel", "klingel.mp3", "Ansage"};
    static const char* const exStations[] = {"{\"stations\":[{\"n\":1,\"name\":\"BR3\",\"url\":\"https://...\",\"vol\":null}]}"};
    static const char* const exFavorites[] = {"{\"max\":40,\"favorites\":[{\"n\":1,\"name\":\"BR3\",\"url\":\"https://...\"}]}"};
    static const char* const exVolState[] = {"12"};
    static const char* const exAvail[] = {"online", "offline"};
    h += mqttRow(base, "/say", true, "Text, der angesagt wird. Oder JSON mit <code>text</code> und optional <code>lang</code>, <code>voice</code>, <code>rate</code>, <code>vol</code>, <code>save</code>, <code>fx</code> (0 = ohne Klangeffekt).", exSay, 2);
    h += mqttRow(base, "/play", true, "URL (Webradio, MP3) <em>oder</em> Dateiname aus dem Tab MP3 (Flash) oder <code>sd:/Pfad.mp3</code> von der SD-Karte. Das Ger&auml;t erkennt selbst, was es ist. JSON: <code>url</code> oder <code>file</code>, optional <code>vol</code>; bei einem Ordner (<code>sd:/Pfad/</code>) auch <code>shuffle</code> (zuf&auml;llige Reihenfolge) und <code>loop</code> (endlos), z. B. <code>{&quot;file&quot;:&quot;sd:/Musik/&quot;,&quot;shuffle&quot;:1,&quot;loop&quot;:1}</code>.", exPlay, 3);
    h += mqttRow(base, "/url", true, "URL (http:// oder https://). JSON: <code>url</code>, optional <code>vol</code>.", exUrl, 1);
    h += mqttRow(base, "/file", true, "Dateiname einer hochgeladenen Datei, <code>sd:/Pfad.mp3</code> oder ein Ordner <code>sd:/Ordner/</code>. JSON: <code>file</code>, optional <code>vol</code>, <code>shuffle</code> und <code>loop</code>. Stereo-Position (nur im Stereo-Aufbau h&ouml;rbar): optional <code>pan</code> (<code>off</code>, <code>left</code> links, <code>right</code> rechts, <code>lr</code> links nach rechts, <code>rl</code> rechts nach links, <code>pp</code> hin und her) und <code>pansec</code> (Dauer eines Durchgangs in Sekunden); gilt auch f&uuml;r <code>/play</code> und <code>/api/file</code>. Ohne Angabe gilt die Einstellung im Tab Ansage.", exFile, 1);
    h += mqttRow(base, "/station", true, "Gespeicherter Sender: Platznummer 1-30 oder Name. JSON: <code>n</code> oder <code>name</code>, optional <code>vol</code>.", exStation, 3);
    h += mqttRow(base, "/stop", true, "Keine Nutzlast: beendet die Wiedergabe, auch ein Webradio.", exStop, 1);
    h += mqttRow(base, "/volume", true, "Allgemeine Lautst&auml;rke 0 bis 100 (wird gespeichert); sie wandert sanft zum neuen Wert. Als JSON l&auml;sst sich die Dauer je Aufruf in Millisekunden angeben: <code>{\"v\":60,\"ms\":3000}</code>.", exVol, 2);
    h += mqttRow(base, "/list", true, "Keine Nutzlast: sendet Senderliste und Favoriten erneut.", exList, 1);
    h += mqttRow(base, "/restart", true, "Keine Nutzlast: startet das Ger&auml;t neu. <strong>Nicht retained senden</strong>, sonst wird ein gespeicherter Befehl nach dem Verbinden ignoriert.", exRestart, 1);
    h += mqttRow(base, "/status", false, "Zustand: <code>idle</code>, <code>loading</code>, <code>playing</code> oder <code>error: ...</code>.", exStatus, 3);
    h += mqttRow(base, "/now", false, "Was gerade l&auml;uft: Sendername und Titel, Dateiname oder &quot;Ansage&quot;; leer, wenn nichts l&auml;uft.", exNow, 3);
    h += mqttRow(base, "/stations", false, "Liste der gespeicherten Sender als JSON; wird nach jeder &Auml;nderung neu gesendet.", exStations, 1);
    h += mqttRow(base, "/favorites", false, "Liste der Favoriten als JSON (bis zu 40); wird nach jeder &Auml;nderung neu gesendet. Ein Favorit l&auml;sst sich mit seiner URL auf <code>/play</code> abspielen.", exFavorites, 1);
    h += mqttRow(base, "/volume/state", false, "Gerade wirkende Lautst&auml;rke (kann die eines Senders sein).", exVolState, 1);
    h += mqttRow(base, "/volume/general", false, "Allgemeine Lautst&auml;rke.", exVolState, 1);
    h += mqttRow(base, "/availability", false, "Ger&auml;t erreichbar (<code>online</code>) oder weg (<code>offline</code>, kommt vom Broker).", exAvail, 2);
    h += "</table><p><small style='font-size:.9rem'>Fertige <code>mosquitto_pub</code>-Aufrufe zum Kopieren stehen im Tab <strong>Doku</strong>.</small></p></div>";
    return h;
}
// Text fuer ein JavaScript-Zeichenfolge in einem HTML-Attribut (confirm-Rueckfrage): \ ' " als Escape, dann HTML-sicher.
// Text for a JavaScript string inside an HTML attribute (confirm prompt): \ ' " escaped, then HTML-safe.

String jsAttrEsc(String s) {
    s.replace("\\", "\\\\");
    s.replace("'", "\\x27");
    s.replace("\"", "\\x22");
    return htmlEsc(s);
}

// Tab WLAN wie bei der Uhr: Status, Hostname, Neu scannen, Netz-Plaetze (belegte plus ein leerer), Speichern.
// WiFi tab as on the clock: status, hostname, rescan, network slots (used ones plus one empty), save.

String panelWlan() {
    String h = "<div class='card' style='text-align:center'>";
    if (apActive && WiFi.status() != WL_CONNECTED) {
        h += "<div class='flash warn'>Noch kein WLAN eingerichtet oder das zuletzt bekannte Netz ist nicht erreichbar - das Ger&auml;t hat ein eigenes WLAN aufgemacht. Zugangsdaten des Heim-WLANs unten eintragen und speichern, dann verbindet sich das Ger&auml;t.</div>";
    }
    if (WiFi.status() == WL_CONNECTED) {
        h += "<div style='margin:10px auto'>Verbunden mit: <strong>" + htmlEsc(WiFi.SSID()) + "</strong></div>";
    } else if (!apActive) {
        h += "<div style='margin:10px auto;color:#856404'>Nicht verbunden</div>";
    }
    h += "<form method='POST' action='/sethostname'><div style='display:flex;justify-content:center;align-items:center;gap:12px;flex-wrap:wrap'>";
    h += "<label>Hostname:</label> " + infoTip("Das Ger&auml;t ist auch unter http://Hostname.local erreichbar statt &uuml;ber die IP-Adresse (auch f&uuml;r OTA und die MQTT-Standardtopics). Nach einer &Auml;nderung ist ein Neustart n&ouml;tig. Nicht jeder Router l&ouml;st Hostnamen auf. Erlaubt: a-z, 0-9, Bindestrich");
    h += "<input name='host' maxlength='30' value='" + htmlEsc(cfg.host) + "' style='width:170px'>";
    h += "<button type='submit' style='width:140px'>Speichern</button></div></form><br>";
    h += "<div style='display:flex;justify-content:center;align-items:center;gap:12px;flex-wrap:wrap'>";
    h += "<button id='rescanBtn' type='button' onclick='rescanWifi()' style='width:200px'>Netzwerke neu scannen</button> " + infoTip("Sucht die WLAN-Netze in der N&auml;he erneut und f&uuml;llt die Auswahllisten unten neu") + "</div><br>";
    int saved = 0;
    for (int i = 0; i < 3; i++) {
        if (cfg.ssid[i].length() > 0) saved++;
    }
    h += "<form method='POST' action='/save'><input type='hidden' name='sect' value='wlan'>";
    for (int i = 0; i < 3; i++) {
        String n = String(i + 1);
        h += "<hr><h3 style='display:flex;align-items:center;justify-content:center;gap:6px'>SSID" + n;
        if (i == 0) h += " " + infoTip("Bis zu 3 WLAN-Netze k&ouml;nnen gespeichert werden; sie werden in dieser Reihenfolge probiert");
        h += "</h3><div style='display:flex;gap:6px;align-items:center;flex-wrap:wrap;justify-content:center'>";
        h += "<select id='ssid_select" + n + "' onchange=\"document.getElementById('ssid" + n + "').value=this.value\" style='max-width:180px'></select>";
        h += "<input name='ssid" + n + "' id='ssid" + n + "' placeholder='SSID" + n + "' value='" + htmlEsc(cfg.ssid[i]) + "' style='width:110px'>";
        h += "<input name='pass" + n + "' type='password' placeholder='Password' value='' style='width:110px'>";
        if (cfg.ssid[i].length() > 0) {
            String q = jsAttrEsc(cfg.ssid[i]);
            if (saved > 1) h += " <a href='/api/connectWifi?index=" + String(i) + "' onclick=\"return confirm('Verbinden " + q + "?')\">Verbinden</a>";
            h += " <a href='/deletewifi?index=" + String(i) + "' onclick=\"return confirm('L&ouml;schen " + q + "?')\">L&ouml;schen</a>";
        }
        h += "</div><small>Sie k&ouml;nnen auch eine SSID manuell eingeben.";
        if (cfg.ssid[i].length() > 0) h += " Das Passwort ist ausgeblendet. Lassen Sie das Feld leer, um das aktuelle Passwort beizubehalten.";
        h += "</small>";
        if (cfg.ssid[i].isEmpty()) break;
    }
    h += "<br><br><button type='submit'>WLAN Einstellungen speichern</button></form><hr></div>";
    return h;
}

String panelTime() {
    static const char* const tzValues[] = {"CET-1CEST,M3.5.0,M10.5.0/3", "CEST-2", "CET-1", "GMT0BST,M3.5.0/1,M10.5.0", "UTC0", "EST5EDT,M3.2.0,M11.1.0", "EET-2EEST,M3.5.0/3,M10.5.0/4"};
    static const char* const tzLabels[] = {"Mitteleuropa (DST auto)", "Mitteleuropa (feste Sommerzeit)", "Mitteleuropa (feste Winterzeit)", "Gro&szlig;britannien (DST auto)", "UTC", "US Ost (DST auto)", "Osteuropa (DST auto)"};
    String h = "<div class='card'><h3>Zeit</h3><form method='POST' action='/save'><input type='hidden' name='sect' value='time'>";
    int ntpVisible = 1;
    for (int i = 0; i < 5; i++) {
        if (!cfg.ntp[i].isEmpty()) ntpVisible = i + 2;
    }
    if (ntpVisible > 5) ntpVisible = 5;
    for (int i = 1; i <= 5; i++) {
        String n = String(i);
        h += "<div id='ntpRow" + n + "'" + (i > ntpVisible ? " style='display:none'" : "") + "><div class='row'>NTP Server" + n + " " + infoTip("Zeitserver (NTP), zum Beispiel pool.ntp.org") + " : <input type='text' id='ntpServerInput" + n + "' name='ntp" + n + "' value='" + htmlEsc(cfg.ntp[i - 1]) + "' oninput='ntpGrow(" + n + ")' style='width:180px'>";
        h += "<button type='button' onclick='testNtp(" + n + ")' style='width:100px'>Test</button> " + infoTip("Fragt diesen Server ab und zeigt die empfangene UTC-Zeit") + "</div><div id='ntpTestResult" + n + "'></div></div>";
    }
    h += "<small>Bis zu 5 Server, leere Felder werden &uuml;bersprungen. Das Ger&auml;t fragt die ersten drei; kommt innerhalb von 45 s keine Zeit an, probiert es die weiteren.</small>";
    h += "<div class='row'><select id='tz_select' style='width:300px' onchange=\"document.getElementById('tz_input').value=this.value\">";
    for (int i = 0; i < 7; i++) {
        h += "<option value='" + String(tzValues[i]) + "'" + (cfg.tz == tzValues[i] ? " selected" : "") + ">" + tzLabels[i] + " (" + tzValues[i] + ")</option>";
    }
    h += "</select> " + infoTip("Zeitzone aus der Liste w&auml;hlen; der Wert wird in das Feld darunter &uuml;bernommen") + "</div><div class='row'><input type='text' id='tz_input' name='tz' value='" + htmlEsc(cfg.tz) + "' style='width:300px'> " + infoTip("Zeitzone als POSIX-Text, zum Beispiel CET-1CEST,M3.5.0,M10.5.0/3") + "</div>";
    h += "<small>F&uuml;r eigene Zeitzonen eine Vorgabe w&auml;hlen oder den Wert oben selbst eintragen.</small><br>";
    h += "<button type='submit'>Speichern</button></form></div>";
    return h;
}

String statusRow(const String& label, const String& value) {
    return "<tr><td>" + label + "</td><td>" + htmlEsc(value) + "</td></tr>";
}

String panelStatus() {
    char up[32];
    unsigned long s = millis() / 1000;
    snprintf(up, sizeof(up), "%lud %02lu:%02lu:%02lu", s / 86400, (s / 3600) % 24, (s / 60) % 60, s % 60);
    String h = "<div class='card'><h3>Status</h3><table>";
    h += statusRow("Chip", String(ESP.getChipModel()));
    h += statusRow("Chip Revision", String(ESP.getChipRevision()));
    h += "<tr><td>Release</td><td><a href='https://github.com/holgiw/ESP32-netspeaker/releases/tag/v" PROJECT_VERSION "' target='_blank' rel='noopener noreferrer'>v" PROJECT_VERSION "</a></td></tr>";
    h += statusRow("Firmware", String(FIRMWARE_MARKER + FIRMWARE_MARKER_PREFIX_LEN));
    h += statusRow("Uptime", String(up));
    h += statusRow("Free Heap", String(ESP.getFreeHeap()) + " bytes (minimum since boot " + String(ESP.getMinFreeHeap()) + ")");
    h += statusRow("Reset Reason", resetReasonName());
    h += statusRow("Crashes in a Row", String(bootCrashes));
    h += statusRow("Safe Mode", safeMode ? String("ON (no MQTT, no radio reconnect)") : String("off"));
    h += statusRow("WiFi Reconnects", String(wifiReconnects));
    h += statusRow("MQTT Reconnects", String(mqttReconnects));
    h += statusRow("PSRAM", String(ESP.getPsramSize()) + " bytes (free " + String(ESP.getFreePsram()) + ")");
    h += statusRow("Flash Size", String(ESP.getFlashChipSize()) + " bytes");
    storageRefresh();
    h += statusRow("LittleFS", fsReady ? String(fsUsedC) + " / " + String(fsTotalC) + " bytes" : String("not mounted"));
    h += statusRow("SD Card", sdState);
    if (sdReady) {
        unsigned long sdTotal = (unsigned long)(sdTotalC / 1048576ULL);
        unsigned long sdUsed = (unsigned long)(sdUsedC / 1048576ULL);
        unsigned long sdFree = sdTotal > sdUsed ? sdTotal - sdUsed : 0;
        h += statusRow("SD Size", String(sdTotal) + " MB (card " + String((unsigned long)(SD.cardSize() / 1048576ULL)) + " MB)");
        h += statusRow("SD Used", String(sdUsed) + " MB" + (sdTotal > 0 ? " (" + String(sdUsed * 100UL / sdTotal) + " %)" : String()));
        h += statusRow("SD Free", String(sdFree) + " MB");
    }
    h += statusRow("SD Enabled", cfg.sdOn ? String("yes") : String("no"));
    h += statusRow("SD CS GPIO", String(cfg.sdCs));
    h += statusRow("SD SCK GPIO", String(cfg.sdSck));
    h += statusRow("SD MOSI GPIO", String(cfg.sdMosi));
    h += statusRow("SD MISO GPIO", String(cfg.sdMiso));
    h += statusRow("WiFi SSID", WiFi.status() == WL_CONNECTED ? WiFi.SSID() : String("not connected"));
    h += statusRow("WiFi RSSI", WiFi.status() == WL_CONNECTED ? String(WiFi.RSSI()) + " dBm" : String("-"));
    h += statusRow("IP Address", WiFi.localIP().toString());
    h += statusRow("MAC Address", WiFi.macAddress());
    h += statusRow("Audio DIN GPIO", String(cfg.din));
    h += statusRow("Audio BCLK GPIO", String(cfg.bclk));
    h += statusRow("Audio LRC GPIO", String(cfg.lrc));
    h += statusRow("Audio State", playStateName());
    h += statusRow("Audio Last Error", lastError.length() > 0 ? lastError : String("-"));
    h += statusRow("VoiceRSS Key", cfg.vkey.length() > 0 ? String("set") : String("not set"));
    h += statusRow("MQTT Status", cfg.mqttServer.isEmpty() ? String("disabled") : (mqttClient.connected() ? String("connected") : String("disconnected")));
    h += "</table></div>";
    h += "<div class='card'><h3>Sprache / Language</h3><p>Die englische &Uuml;bersetzung ist in die Firmware eingebaut. Mit der Schaltfl&auml;che in der Statuszeile wechselst du zwischen DE und EN.</p></div>";
    return h;
}

String panelBackup() {
    String h = "<div class='card' style='max-width:900px'><h3>Sicherung erstellen</h3>";
    h += "<p>Speichert die Einstellungen (mit Favoriten und Senderliste) als Datei auf deinem Computer. Mit Dateien im Flash entsteht eine ZIP-Datei.</p>";
    h += "<div class='row'><label style='display:flex;align-items:center;gap:8px;cursor:pointer;'><input type='checkbox' id='bkWifi' style='width:auto;margin:0;'>WLAN-Zugangsdaten einschlie&szlig;en</label> " + infoTip("Nimmt die WLAN-Passw&ouml;rter verschl&uuml;sselt in die Sicherung auf, sie stehen nicht im Klartext in der Datei. Der Schl&uuml;ssel steckt in der Firmware; die Datei trotzdem gut aufbewahren. Ohne den Haken enth&auml;lt die Sicherung nur die Namen der Netze. Nur aus dem lokalen Netz m&ouml;glich") + "</div>";
    h += "<div class='row'><label style='display:flex;align-items:center;gap:8px;cursor:pointer;'><input type='checkbox' id='bkFiles' style='width:auto;margin:0;'>Dateien im Flash einschlie&szlig;en</label> <small id='bkFilesInfo'></small> " + infoTip("Nimmt die MP3-Dateien aus dem Speicher des Ger&auml;ts (Tab MP3 (Flash), auch gespeicherte Texte) in eine ZIP-Datei auf. Die Dateien der SD-Karte sind nie dabei") + "</div>";
    h += "<div class='row'><button type='button' onclick='bkCreate()' style='width:auto;padding:8px 14px'>Sicherung erstellen</button></div><div id='bkResult'></div></div>";
    h += "<div class='card' style='max-width:900px'><h3>Sicherung einlesen</h3>";
    h += "<p>Liest eine Sicherung wieder ein, entweder die Textdatei mit den Einstellungen oder die ZIP-Datei mit Dateien. Bestehende Einstellungen werden &uuml;berschrieben.</p>";
    h += "<div class='row'><input type='file' id='bkFile' accept='.txt,.zip' onchange='bkPick()'></div><div id='bkInfo'></div>";
    h += "<div class='row'><label style='display:flex;align-items:center;gap:8px;cursor:pointer;'><input type='checkbox' id='bkImpWifi' disabled style='width:auto;margin:0;'>WLAN-Zugangsdaten &uuml;bernehmen</label> " + infoTip("&Uuml;bernimmt die Netze und Passw&ouml;rter aus der Sicherung. Ohne den Haken bleiben die WLAN-Einstellungen des Ger&auml;ts unver&auml;ndert. Achtung: Passt das Netz nicht, ist das Ger&auml;t danach nicht mehr erreichbar. Nur aus dem lokalen Netz m&ouml;glich") + "</div>";
    h += "<div class='row'><label style='display:flex;align-items:center;gap:8px;cursor:pointer;'><input type='checkbox' id='bkImpFiles' disabled style='width:auto;margin:0;'>Dateien im Flash &uuml;bernehmen</label> " + infoTip("Spielt die MP3-Dateien aus der ZIP-Datei in den Speicher des Ger&auml;ts ein; Dateien gleichen Namens werden ersetzt") + "</div>";
    h += "<div class='row'><button type='button' id='bkRestoreBtn' onclick='bkRestore()' disabled style='width:auto;padding:8px 14px'>Einlesen</button></div><div id='bkRestoreResult'></div></div>";
    return h;
}

String panelLog() {
    String h = "<div class='card' style='max-width:900px'><form method='POST' action='/save'><input type='hidden' name='sect' value='log'>";
    h += "<div class='row'><label style='display:flex;align-items:center;gap:6px;cursor:pointer;'><input type='checkbox' name='log' value='1'" + String(cfg.logEnabled ? " checked" : "") + " style='width:auto;margin:0;'>Log in Datei schreiben (Standard: aus)</label> " + infoTip("Schreibt Ereignisse in eine Datei im Flash (nur zur Fehlersuche; Standard: aus)") + " automatisch aus nach <input type='number' name='logmin' min='0' max='1440' value='" + String(cfg.logAutoMin) + "' style='width:70px'> min " + infoTip("Schaltet das Schreiben des Logs in die Datei nach so vielen Minuten von selbst aus, damit der Flash geschont wird; 0 = nie. Die Zeit l&auml;uft ab dem Einschalten oder ab dem Start des Ger&auml;ts") + "";
    h += "<button type='submit' style='width:auto;padding:8px 16px;margin:6px;'>Speichern</button>";
    h += "<button type='button' onclick='clearLog()' style='width:auto;padding:8px 16px;margin:6px;background:var(--panel);border:1px solid var(--panel-border);color:var(--text);font-weight:normal;'>Log leeren</button></div>";
    h += "<small>Ausgeschaltet wird nichts in den Flash geschrieben; die serielle Ausgabe l&auml;uft immer.</small><div id='logResult'></div></form></div>";
    h += "<div class='card' style='max-width:900px'>";

    // Karte so breit wie das Log-Feld darunter (max-width:900px); beide Werte gehoeren zusammen.
    // Card as wide as the log box below (max-width:900px); both values belong together.

    h += "<div style='display:flex;align-items:center;gap:14px;flex-wrap:wrap;'>";
    h += "<label style='display:flex;align-items:center;gap:6px;white-space:nowrap;cursor:pointer;'><input type='checkbox' id='logAutoRefresh' style='width:auto;margin:0;'>Auto-Aktualisierung (10 s)</label> " + infoTip("Holt das Log alle 10 Sekunden neu") + "";
    h += "<button type='button' id='logRefreshNow' style='background:var(--panel);border:1px solid var(--panel-border);color:var(--text);border-radius:.4rem;padding:4px 12px;font-size:.8rem;cursor:pointer;width:auto;margin:0;font-weight:normal;'>Jetzt aktualisieren</button>";
    h += "<span id='logErrorHint' class='offline-hint'>&#9888; Aktualisierung fehlgeschlagen - letzter Stand wird angezeigt</span></div>";
    h += "<pre id='logContent' style='background:var(--panel);border:1px solid var(--panel-border);border-radius:10px;max-width:900px;height:400px;overflow-y:auto;margin:15px auto;padding:12px 16px;text-align:left;white-space:pre-wrap;word-break:break-word;font-family:monospace;font-size:.85rem;'>Lade &hellip;</pre></div>";
    return h;
}

// Doku-Tab: Aufrufe von REST-API und MQTT; @HOST@ ersetzt das Skript durch die Adresse, unter der die Seite gerade geoeffnet ist.
// Docs tab: calls of the REST API and MQTT; the script replaces @HOST@ with the address the page is currently opened under.

String docCode(const String& code, bool withHost = true) {
    return "<div class='codewrap'><button type='button' class='copy-btn' onclick='copyPre(this)'>Kopieren</button><pre class='code" + String(withHost ? " codehost" : "") + "'>" + htmlEsc(code) + "</pre></div>";
}

String docCard(const String& title, const String& text, const String& code, bool withHost = true) {
    String h = "<div class='card doc' style='max-width:900px'><h3>" + title + "</h3>";
    if (text.length() > 0) h += "<p>" + text + "</p>";
    if (code.length() > 0) h += docCode(code, withHost);
    return h + "</div>";
}

String panelDoc() {
    String base = mqttBaseTopic();
    String h = docCard("Allgemein",
        "Alle Aufrufe gehen an <code>http://" + htmlEsc(cfg.host) + ".local/</code> oder an die IP-Adresse. Parameter k&ouml;nnen als Formular (<code>-d</code>), als Query (<code>?text=...</code>) oder als flaches JSON im Body kommen; Aufrufe per GET sind erlaubt, zum Beispiel f&uuml;r Home-Automation. "
        "Antwort: <code>{\"ok\":true,\"msg\":\"...\"}</code> oder bei einem Fehler HTTP 400 mit <code>{\"ok\":false,\"error\":\"...\"}</code>. Texte kommen in eine Warteschlange (bis zu 8) und laufen nacheinander. Eine MP3-Datei startet sofort, auch wenn schon eine andere l&auml;uft: bis zu zwei Dateien spielen &uuml;bereinander (zum Beispiel Vogelgezwitscher mit einer Glocke dar&uuml;ber), eine dritte wartet. Ein Sender-Befehl wirkt sofort, ein Stopp leert die Warteschlange.", "");
    {
        // Verkabelungsbild: die GPIO-Nummern im Bild sind die eingestellten Pins.
        // Wiring picture: the GPIO numbers in the picture are the configured pins.

        String svg = FPSTR(WIRING_SVG);
        svg.replace("GPIO 3 (BCLK)", "GPIO " + String(cfg.bclk) + " (BCLK)");
        svg.replace("GPIO 4 (LRC)", "GPIO " + String(cfg.lrc) + " (LRC)");
        svg.replace("GPIO 2 (DIN)", "GPIO " + String(cfg.din) + " (DIN)");
        svg.replace("GPIO 10 (MISO)", "GPIO " + String(cfg.sdMiso) + " (MISO)");
        svg.replace("GPIO 11 (CLK)", "GPIO " + String(cfg.sdSck) + " (CLK)");
        svg.replace("GPIO 12 (MOSI)", "GPIO " + String(cfg.sdMosi) + " (MOSI)");
        svg.replace("GPIO 13 (CS)", "GPIO " + String(cfg.sdCs) + " (CS)");
        h += "<div class='card doc' style='max-width:900px'><h3>Verkabelung</h3><p>Anschl&uuml;sse von ESP32-S3, MAX98357A-Verst&auml;rker und SD-Kartenleser (optional). Die GPIO-Nummern im Bild sind die im Tab Audio eingestellten Pins.</p>";
        h += "<div style='background:#fff;border-radius:8px;padding:6px;overflow-x:auto'>" + svg + "</div></div>";

        // Hier wird die Ansicht (WIRING_VIEW_SVG) eingefuegt; sie wird direkt aus dem Flash gesendet, nicht in einen String kopiert.
        // The view (WIRING_VIEW_SVG) is inserted here; it is sent straight from flash, not copied into a string.

        h += "<!--WIRING_VIEW-->";
    }
    h += docCard("Text ansagen (VoiceRSS)",
        "<code>text</code> (Pflicht, h&ouml;chstens 500 Zeichen), optional <code>save</code> (1 = Text dauerhaft speichern, bevorzugt auf der SD-Karte, sonst im Flash), <code>fx</code> (0 = ohne Klangeffekt, Standard 1), <code>lang</code> (z. B. de-de, en-gb), <code>voice</code> (z. B. Hanna), <code>rate</code> (-10 bis 10), <code>vol</code> (0-100). Ohne Angabe gelten die Werte aus dem Tab VoiceRSS. Der API-Schl&uuml;ssel muss gespeichert sein.",
        R"d(curl -d "text=Hallo Welt" http://@HOST@/api/say
curl "http://@HOST@/api/say?text=Hallo%20Welt&lang=en-gb&voice=Alice&vol=10"
curl -H "Content-Type: application/json" -d '{"text":"Hallo Welt","lang":"de-de","voice":"Hanna","rate":0,"vol":12}' http://@HOST@/api/say)d");
    h += docCard("Webradio oder MP3 per URL",
        "<code>url</code> muss mit http:// oder https:// beginnen. <code>/api/play</code> nimmt <code>url</code> oder <code>file</code>, <code>/api/url</code> nur eine URL. Optional <code>vol</code>. Webradio &uuml;ber https braucht viel RAM, http-Streams sind unkritisch. L&auml;uft ein Webradio und kommt eine Ansage oder eine MP3-Datei, wird das Radio daf&uuml;r ausgeblendet und gestoppt (also stumm), die Ansage gespielt und das Radio danach mit der alten Lautst&auml;rke neu verbunden; vorher wird es sanft ausgeblendet und beim Fortsetzen wieder eingeblendet (Dauer im Tab Audio, Standard 700 ms). Ein Webradio wird beim Start (aus dem Leerlauf) langsam eingeblendet, beim Stopp langsam ausgeblendet, und bei einem Senderwechsel wird der alte langsam aus- und der neue langsam eingeblendet (Tab Audio, Standard 1500 ms). Wird derselbe Sender noch einmal gew&auml;hlt, spielt er einfach weiter; ein Live-Stream geht live weiter, nicht an derselben Stelle. <code>/api/stop</code> beendet das Radio ohne Fortsetzung, ein neuer URL-Befehl ersetzt es.",
        R"d(curl -d "url=http://stream.example.com/radio.mp3" http://@HOST@/api/play
curl -d "url=http://stream.example.com/radio.mp3" http://@HOST@/api/url
curl "http://@HOST@/api/url?url=http://stream.example.com/radio.mp3&vol=10")d");
    h += docCard("SD-Karte",
        "Dateien der SD-Karte (FAT32, nur MP3) werden mit dem Namen <code>sd:/Ordner/Datei.mp3</code> angesprochen, in <code>file</code> von <code>/api/play</code> und <code>/api/file</code> und ebenso per MQTT (<code>/file</code>, <code>/play</code>). Endet der Name mit <code>/</code>, spielt das Ger&auml;t alle MP3-Dateien des Ordners nacheinander (nach Name sortiert); sie kommen einzeln in die Warteschlange, Ansagen dazwischen kommen zuerst. Mit <code>shuffle=1</code> ist die Reihenfolge je Sitzung zuf&auml;llig und jede Datei kommt einmal vor, die erste ist nie die der letzten Sitzung dieses Ordners; mit <code>loop=1</code> beginnt nach der letzten Datei eine neue Runde (bei shuffle neu gemischt, die erste Datei ist nie die zuletzt gespielte). Ein neuer Sender oder Stopp beendet die Sitzung. <code>/api/sd?dir=/Ordner</code> listet einen Ordner, <code>/api/sdmount</code> bindet die Karte neu ein. Dateimanager: Hochladen mit <code>/upload?target=sd&amp;dir=/Ordner</code>, <code>/api/sdmkdir</code> (dir, name), <code>/api/sdrename</code> (path, to), <code>/api/sddelete</code> (path; ein Ordner wird samt Inhalt gel&ouml;scht) und <code>/api/sdfile?path=...</code> zum Herunterladen. Namen werden bereinigt (Umlaute umgeschrieben, Leerzeichen zu Unterstrichen). Ansagen k&ouml;nnen auf der Karte zwischengespeichert werden (Tab Audio, Sprachausgabe): <code>GET /api/ttscache</code> liefert <code>enabled</code>, <code>files</code> und <code>bytes</code>, <code>POST /api/ttscache</code> mit <code>clear=1</code> l&ouml;scht den Zwischenspeicher (Ordner <code>/tts</code>, Dateinamen wie <code>Achtung_auf_Gleis_3_3fa9c2e1.mp3</code>, h&ouml;chstens 500).",
        R"d(curl -d "file=sd:/Musik/lied.mp3" http://@HOST@/api/play
curl -d "file=sd:/Musik/Album/" http://@HOST@/api/play
curl -d "file=sd:/Musik/&shuffle=1&loop=1" http://@HOST@/api/play
curl "http://@HOST@/api/file?file=sd:/Musik/lied.mp3&pan=lr&pansec=5"
curl "http://@HOST@/api/sd?dir=/Musik"
curl -F "file=@lied.mp3" "http://@HOST@/upload?target=sd&dir=/Musik"
curl -d "dir=/Musik&name=Neu" http://@HOST@/api/sdmkdir
curl -d "path=/Musik/lied.mp3&to=neu.mp3" http://@HOST@/api/sdrename
curl -d "path=/Musik/lied.mp3" http://@HOST@/api/sddelete
curl -o lied.mp3 "http://@HOST@/api/sdfile?path=/Musik/lied.mp3"
curl -X POST http://@HOST@/api/sdmount
curl http://@HOST@/api/ttscache
curl -d "clear=1" http://@HOST@/api/ttscache)d");
    h += docCard("Gespeicherte Webradios / URLs",
        "Im Tab Webradio lassen sich 30 Pl&auml;tze mit Name, URL und eigener Lautst&auml;rke speichern (leer = allgemeine Lautst&auml;rke; ein <code>vol</code> im Aufruf hat Vorrang). <code>n</code> ist die Platznummer (1-30), alternativ <code>name</code> (Gro&szlig;-/Kleinschreibung egal). <code>/api/stations</code> liefert die belegten Pl&auml;tze (JSON mit n, name, url, vol), <code>/api/stationdelete</code> l&ouml;scht einen Platz (Name und URL), die folgenden Pl&auml;tze r&uuml;cken nach oben. <code>/stations.txt</code> l&auml;dt die Liste als Textdatei, <code>POST /importstations</code> ersetzt sie durch eine solche Datei (im Tab Webradio: Liste speichern / Liste laden). <code>POST /api/stationlist</code> mit <code>list=aac-auswahl</code> l&auml;dt eine fertige Liste von GitHub.",
        R"d(curl -d "n=3" http://@HOST@/api/station
curl "http://@HOST@/api/station?name=Radio%20Eins&vol=10"
curl http://@HOST@/api/stations
curl http://@HOST@/stations.txt -o stations.txt
curl --data-binary @stations.txt -H "Content-Type: text/plain" http://@HOST@/importstations
curl -d "n=3" http://@HOST@/api/stationdelete)d");
    h += docCard("Hochgeladene MP3-Datei abspielen",
        "<code>file</code> ist der Dateiname aus dem Tab MP3 (Flash). Dort gibt es f&uuml;r jede Datei Kn&ouml;pfe, die den fertigen Aufruf kopieren. Mit <code>/api/files</code> kommt die Liste, mit <code>/api/delete</code> wird eine Datei gel&ouml;scht. Hochladen geht per <code>/upload</code> (Formular, Feld <code>file</code>). <code>/api/flash?dir=</code> zeigt einen Ordner wie bei der SD-Karte (leer = MP3-Ordner, <code>ansagen</code> = gespeicherte Texte), <code>/api/fileget?file=</code> l&auml;dt eine Datei herunter. Ein Name wie <code>ansagen/Text.mp3</code> liegt im Unterordner; endet der Name mit <code>/</code> (<code>ansagen/</code> oder <code>/</code> f&uuml;r den MP3-Ordner), spielt das Ger&auml;t alle Dateien des Ordners (mit <code>shuffle=1</code> zuf&auml;llig). Ein Name ohne <code>sd:</code> wird zuerst im Flash und dann auf der SD-Karte gesucht (<code>sd:/Pfad.mp3</code> nur auf der Karte).",
        R"d(curl -d "file=glocke.mp3" http://@HOST@/api/file
curl "http://@HOST@/api/file?file=glocke.mp3&vol=15"
curl http://@HOST@/api/files
curl -d "file=glocke.mp3" http://@HOST@/api/delete
curl -d "file=glocke.mp3&to=gong.mp3" http://@HOST@/api/rename
curl -F "file=@glocke.mp3" http://@HOST@/upload)d");
    h += docCard("Stopp, Lautst&auml;rke, Status",
        "<code>v</code> ist 0-100 und wird gespeichert; die Lautst&auml;rke wandert sanft zum neuen Wert, die Dauer in Millisekunden steht im Tab Audio und l&auml;sst sich je Aufruf mit <code>ms</code> &uuml;berschreiben. Ohne <code>v</code> meldet <code>/api/volume</code> nur: <code>volume</code> (allgemein) und <code>playVolume</code> (gerade wirkend). <code>/api/status</code> liefert <code>state</code> (idle, loading, playing), <code>error</code>, <code>queue</code> (wartende Ansagen und Dateien), <code>volume</code> (allgemein), <code>playVolume</code> (die gerade wirkende Lautst&auml;rke), den freien Speicher und was gerade l&auml;uft: <code>source</code> (radio, file, speech), <code>name</code> (Sendername oder Dateiname), <code>title</code> (aktueller Titel, wenn der Sender ihn meldet) und <code>url</code>. Bei einer laufenden Datei kommen <code>pos</code> und <code>dur</code> (Sekunden), <code>pm</code> (Fortschritt in Promille) und <code>rate</code> (Promille je Sekunde) dazu, bei einem Webradio <code>genre</code>, <code>desc</code>, <code>web</code>, <code>logo</code>, <code>host</code>, <code>bitrate</code>, <code>codec</code>, <code>rate</code> (Abtastrate in Hz), <code>ch</code> und <code>bits</code>, und mit der Lautst&auml;rke-Angleichung <code>gainDb</code>.",
        R"d(curl -X POST http://@HOST@/api/stop
curl -d "toggle=1" http://@HOST@/api/mute
curl -d "on=1" http://@HOST@/api/mute
curl -d "on=0" http://@HOST@/api/mute
curl http://@HOST@/api/mute
curl -d "v=50" http://@HOST@/api/volume
curl -d "v=60&ms=3000" http://@HOST@/api/volume
curl http://@HOST@/api/volume
curl http://@HOST@/api/status)d");
    h += docCard("Log",
        "<code>enable</code> schaltet das Log in die Datei ein (1) oder aus (0), Standard ist aus. <code>clear=1</code> leert die Datei. Ohne Parameter liefert GET den Zustand. <code>/log</code> gibt den Inhalt als Text zur&uuml;ck.",
        R"d(curl http://@HOST@/api/log
curl -d "enable=1" http://@HOST@/api/log
curl -d "clear=1" http://@HOST@/api/log
curl http://@HOST@/log)d");
    h += docCard("MQTT-Broker per API setzen",
        "Setzt nur Broker und Port (optional auch <code>user</code> und <code>pass</code>), alles andere bleibt unver&auml;ndert. GET liefert Broker, Port, <code>user</code> und <code>connected</code>; das Passwort wird nie ausgegeben. Mit <code>group1</code> bis <code>group5</code> lassen sich die Gruppen-Topics setzen (leer = entfernt); GET liefert sie als <code>groups</code>. <code>ha=1</code> schaltet die Home-Assistant-Discovery ein, <code>ha=0</code> aus.",
        R"d(curl -d "broker=192.168.0.70&port=1883" http://@HOST@/api/mqtt
curl -d "group1=netspeaker/all&group2=netspeaker/haus" http://@HOST@/api/mqtt
curl -d "ha=1" http://@HOST@/api/mqtt
curl http://@HOST@/api/mqtt)d");
    h += docCard("Eing&auml;nge (Pins)",
        "<code>GET /api/pins</code> liefert die freien Pins: <code>p</code> (Nummer), <code>l</code> (Zustand, 1 = High, 0 = Low), <code>t</code> (Aktion), <code>x</code> (Text) und <code>v</code> (Lautst&auml;rke, -1 = allgemeine). <code>POST /api/pins</code> mit <code>pin</code>, <code>type</code> (<code>say</code>, <code>file</code>, <code>station</code>, <code>radio</code>, <code>next</code>, <code>prev</code>, <code>volup</code>, <code>voldown</code>, <code>mute</code>, <code>stop</code> oder leer = keine Aktion; die letzten sieben brauchen keinen Text, bei <code>volup</code>/<code>voldown</code> gilt <code>vol</code> als Schrittweite, Standard 5), <code>text</code> (Ansage, Dateiname, <code>sd:</code>-Pfad, URL oder Sender) und optional <code>vol</code> (0-100) speichert die Aktion eines Pins. Sie l&ouml;st aus, sobald der Pin etwa 40 ms Kontakt nach GND hat.",
        R"d(curl http://@HOST@/api/pins
curl -d "pin=5&type=say&text=Die Tür ist offen" http://@HOST@/api/pins
curl -d "pin=6&type=file&text=gong.mp3&vol=60" http://@HOST@/api/pins
curl -d "pin=7&type=station&text=RSA" http://@HOST@/api/pins
curl -d "pin=5&type=" http://@HOST@/api/pins)d");
    h += docCard("Sprachen",
        "Die englische &Uuml;bersetzung ist in die Firmware eingebaut. <code>/lang.json?l=en</code> liefert sie, <code>GET /api/lang</code> listet die Sprachen.",
        R"d(curl http://@HOST@/api/lang
curl "http://@HOST@/lang.json?l=en")d");
    h += docCard("Klangeffekte",
        "<code>GET /api/effect</code> liefert <code>mode</code> (off, room, hall, church, echo), <code>wet</code> (0-100), <code>bass</code>, <code>treble</code> (dB), <code>pan</code> (off, lr = links&rarr;rechts, rl = rechts&rarr;links, pp = hin und her), <code>pansec</code> (Dauer eines Durchgangs, 0,5-20 s) und <code>load</code> (Rechenlast des Effekts in Prozent). <code>POST /api/effect</code> setzt die angegebenen Werte; <code>mode</code> auch als Zahl 0-4 oder auf Deutsch (aus, zimmer, halle, kirche, echo), <code>bass</code> und <code>treble</code> -12 bis 12 dB. Hall und Echo wirken nur auf Ansagen, Klangregler und Wandern auch auf abgespielte Dateien, nie auf Webradio. Die Werte bleiben gespeichert; im Tab Ansage einstellbar. Mit <code>fx=0</code> bei <code>/api/say</code> l&auml;uft eine einzelne Ansage ohne Effekt.",
        R"d(curl http://@HOST@/api/effect
curl -d "mode=hall&wet=35" http://@HOST@/api/effect
curl -d "bass=4&treble=-2" http://@HOST@/api/effect
curl -d "mode=off" http://@HOST@/api/effect)d");
    h += docCard("Sicherung",
        "Im Tab Sicherung entsteht die Sicherung im Browser: <code>GET /export</code> liefert die Einstellungen als Textdatei, mit <code>wifi=1</code> auch die WLAN-Passw&ouml;rter, verschl&uuml;sselt (nur aus dem lokalen Netz). <code>GET /api/files</code> listet die MP3-Dateien im Flash, <code>GET /api/fileget?file=name.mp3</code> l&auml;dt eine herunter. Mit Dateien packt der Browser alles in eine ZIP-Datei (<code>settings.txt</code> und <code>mp3/&lt;Name&gt;</code>). Zum Einlesen sendet er <code>POST /import</code> (Text) und <code>POST /upload</code> je Datei. Die Dateien der SD-Karte sind nie Teil der Sicherung.",
        R"d(curl -o netspeaker-settings.txt "http://@HOST@/export?wifi=1"
curl -o glocke.mp3 "http://@HOST@/api/fileget?file=glocke.mp3"
curl --data-binary @netspeaker-settings.txt -H "Content-Type: text/plain" http://@HOST@/import)d");
    h += docCard("Weitere Aufrufe",
        "<code>/api/scan</code> (WLAN-Suche), <code>/api/scanwifi</code> (Suche im Hintergrund mit Signalst&auml;rke, Ergebnis aus dem Zwischenspeicher) und <code>/api/rescanwifi</code> (POST, neu suchen),<code>/api/testNtp?server=...</code> (NTP-Test, nur im Tab Zeit n&ouml;tig), <code>/api/topbarStatus</code> (Statusleiste), <code>/api/version</code> (Firmware-Stand), <code>/export</code> und <code>/import</code> (Einstellungen; WLAN-Passw&ouml;rter nur verschl&uuml;sselt und nur mit <code>/export?wifi=1</code>, der VoiceRSS-Schl&uuml;ssel und das MQTT-Passwort immer verschl&uuml;sselt, siehe Karte Sicherung), <code>/restart</code> (POST, Neustart).",
        R"d(curl http://@HOST@/api/version
curl -o netspeaker-settings.txt http://@HOST@/export
curl -X POST http://@HOST@/restart)d");
    h += docCard("MQTT",
        "Basis-Topic <code>" + htmlEsc(base) + "</code> (im Tab MQTT &auml;nderbar). Nutzlast als Text oder als JSON. <code>/say</code>: Text oder <code>{\"text\":\"...\",\"lang\":\"..\",\"voice\":\"..\",\"rate\":0,\"vol\":60,\"fx\":0}</code>. <code>/play</code>: URL oder Dateiname, auch <code>{\"url\":\"...\"}</code> oder <code>{\"file\":\"...\"}</code>. <code>/url</code> nur URL, <code>/file</code> nur Dateiname, <code>/station</code> Platz 1-30 oder Name (auch JSON <code>{\"n\":3}</code> oder <code>{\"name\":\"..\"}</code>). <code>/stop</code> ohne Nutzlast. <code>/volume</code> 0-100. <code>/restart</code> ohne Nutzlast startet das Ger&auml;t neu (nicht retained senden; eine Nachricht in den ersten 3 s nach dem Verbinden wird ignoriert). "
        "Zur&uuml;ck kommen <code>/status</code> (idle, loading, playing, error: ...), <code>/now</code> (was gerade l&auml;uft, zum Beispiel &quot;Sendername - Titel&quot;) und <code>/availability</code> (online, offline). <code>/volume/state</code> (gerade wirkende Lautst&auml;rke) und <code>/volume/general</code> (allgemeine) werden bei jeder &Auml;nderung gesendet. <code>/stations</code> enth&auml;lt die Senderliste (retained, wird nach jeder &Auml;nderung neu gesendet); ein Aufruf von <code>/list</code> sendet sie erneut; ein ung&uuml;ltiger Befehl erscheint in <code>/status</code> als Fehler. Zus&auml;tzliche Gruppen-Topics (bis zu 5, im Tab MQTT) nehmen dieselben Befehle an, zum Beispiel <code>netspeaker/all/stop</code> f&uuml;r alle Ger&auml;te; Standard ist <code>netspeaker/all</code>.",
        "mosquitto_pub -h <broker> -t " + base + "/say -m \"Hallo Welt\"\n"
        "mosquitto_pub -h <broker> -t " + base + "/say -m '{\"text\":\"Hallo\",\"lang\":\"en-gb\",\"vol\":10}'\n"
        "mosquitto_pub -h <broker> -t " + base + "/play -m \"http://stream.example.com/radio.mp3\"\n"
        "mosquitto_pub -h <broker> -t " + base + "/file -m \"glocke.mp3\"\n"
        "mosquitto_pub -h <broker> -t " + base + "/station -m 3\n"
        "mosquitto_pub -h <broker> -t " + base + "/station -m \"Radio Eins\"\n"
        "mosquitto_pub -h <broker> -t " + base + "/stop -n\n"
        "mosquitto_pub -h <broker> -t " + base + "/volume -m 50\n"
        "mosquitto_pub -h <broker> -t " + base + "/list -n\n"
        "mosquitto_pub -h <broker> -t " + base + "/restart -n\n"
        "mosquitto_sub -h <broker> -t " + base + "/stations -C 1\n"
        "mosquitto_sub -h <broker> -t \"" + base + "/#\" -v", false);
    h += docCard("Kontakt", "E-Mail: <a href='mailto:carleaner@gmx.de'>carleaner@gmx.de</a><br>GitHub: <a href='https://github.com/holgiw/ESP32-netspeaker' target='_blank' rel='noopener'>github.com/holgiw/ESP32-netspeaker</a>", "");
    return h;
}
static const char PINS_JS[] PROGMEM = R"js(
(function(){
  var picks=[],spicks=[],fl=[],sdl=[],stl=[],rows=[];
  function el(n,c){var e=document.createElement(n);if(c)e.className=c;return e;}
  function fillPick(p){
    p.textContent='';var o=el('option');o.value='';o.textContent='Datei w\u00e4hlen \u2026';p.appendChild(o);
    if(fl.length){var g=el('optgroup');g.label='Flash';fl.forEach(function(f){var x=el('option');x.value=f;x.textContent=f;g.appendChild(x);});p.appendChild(g);}
    if(sdl.length){var g2=el('optgroup');g2.label='SD-Karte';sdl.forEach(function(s){var x=el('option');x.value=s[0];x.textContent=s[1];g2.appendChild(x);});p.appendChild(g2);}
  }
  function fillSta(p){p.textContent='';var o=el('option');o.value='';o.textContent='Sender w\u00e4hlen \u2026';p.appendChild(o);stl.forEach(function(s){var x=el('option');x.value=s[0];x.textContent=s[1];p.appendChild(x);});}
  function lists(cb){
    Promise.all([
      fetch('/api/files',{cache:'no-store'}).then(function(r){return r.json();}).catch(function(){return {};}),
      fetch('/api/sd?dir=/',{cache:'no-store'}).then(function(r){return r.json();}).catch(function(){return {};}),
      fetch('/api/stations',{cache:'no-store'}).then(function(r){return r.json();}).catch(function(){return {};})
    ]).then(function(a){
      stl=((a[2]&&a[2].stations)||[]).map(function(s){return [s.name||String(s.n),s.n+': '+(s.name||s.url)];});
      fl=(a[0].files||[]).map(function(f){return f.name;});
      sdl=[];var s=a[1];
      if(s&&s.mounted){sdl.push(['sd:/','\uD83D\uDCC1 / (Hauptverzeichnis)']);(s.entries||[]).forEach(function(e){sdl.push(e.d?['sd:/'+e.n+'/','\uD83D\uDCC1 '+e.n]:['sd:/'+e.n,e.n]);});}
      picks.forEach(fillPick);spicks.forEach(fillSta);if(cb)cb();
    });
  }
  var LV={};
  function build(list){
    var tb=document.getElementById('pinTable');if(!tb)return;tb.textContent='';picks=[];spicks=[];rows=[];LV={};
    list.forEach(function(j){LV[j.p]=j.l;});
    var h=el('tr');['GPIO','Zustand','Aktion','Text oder Datei','Lautst\u00e4rke'].forEach(function(t){var c=el('th');c.textContent=t;h.appendChild(c);});tb.appendChild(h);
    function addRow(j,free){
      var tr=el('tr'),c1=el('td'),c2=el('td'),c3=el('td'),c4=el('td'),c5=el('td'),gp=null;
      if(free){gp=el('select');gp.style.cssText='width:auto;margin:2px';free.forEach(function(q){var o=el('option');o.value=q.p;o.textContent='GPIO '+q.p;gp.appendChild(o);});c1.appendChild(gp);}
      else c1.textContent='GPIO '+j.p;
      c1.style.whiteSpace='nowrap';c2.style.whiteSpace='nowrap';
      var st=el('span');c2.appendChild(st);
      var sel=el('select');sel.style.cssText='width:auto;margin:2px';[['','Keine Aktion'],['say','Ansage (VoiceRSS)'],['file','MP3-Datei / URL'],['station','Webradio'],['radio','Radio starten'],['next','Sender vor'],['prev','Sender zur\u00fcck'],['volup','Lauter'],['voldown','Leiser'],['mute','Stumm (umschalten)'],['stop','Stopp']].forEach(function(o){var op=el('option');op.value=o[0];op.textContent=o[1];sel.appendChild(op);});sel.value=j.t||'';c3.appendChild(sel);
      var tx=el('input');tx.type='text';tx.maxLength=300;tx.value=j.x||'';tx.placeholder='z. B. Die T\u00fcr ist offen / gong.mp3';tx.style.cssText='width:95%;margin:2px';c4.appendChild(tx);
      var pk=el('select');pk.style.cssText='width:95%;margin:2px';fillPick(pk);picks.push(pk);c4.appendChild(pk);
      pk.onchange=function(){if(pk.value){tx.value=pk.value;pk.value='';}};
      var ps=el('select');ps.style.cssText='width:95%;margin:2px';fillSta(ps);spicks.push(ps);c4.appendChild(ps);
      ps.onchange=function(){if(ps.value){tx.value=ps.value;ps.value='';}};
      function vis(){var v=sel.value,ctl=['radio','next','prev','mute','stop','volup','voldown'].indexOf(v)>=0,stp=v==='volup'||v==='voldown';pk.style.display=v==='file'?'':'none';ps.style.display=v==='station'?'':'none';tx.style.display=(ctl||v==='')?'none':'';if(vo){vo.style.display=(v===''||v==='mute'||v==='stop')?'none':'';vo.placeholder=stp?'Schritt 5':'Std';if(stp){if(vo.value===''){vo.value='5';vo.dataset.auto='1';}}else if(vo.dataset.auto==='1'){if(vo.value==='5')vo.value='';vo.dataset.auto='';}}if(tip)tip.style.display=stp?'':'none';}
      sel.onchange=vis;
      var vo=el('input');vo.type='number';vo.min=0;vo.max=100;vo.value=j.v>=0?j.v:'';vo.style.cssText='width:64px;margin:2px';c5.appendChild(vo);
      var tip=el('span');tip.textContent='\u24d8';tip.style.cssText='cursor:help;margin-left:4px';tip.title='Schrittweite: Um wie viele Lautst\u00e4rke-Stufen (0-100) sich die Lautst\u00e4rke mit jedem Tastendruck \u00e4ndert. Standard 5.';c5.appendChild(tip);
      vis();
      var row={sel:sel,tx:tx,vo:vo};
      row.pin=function(){return gp?gp.value:String(j.p);};
      row.cur=function(){return JSON.stringify([sel.value,tx.value,vo.value]);};
      row.orig=row.cur();
      row.dirty=function(){return gp?sel.value!=='':row.cur()!==row.orig;};
      row.upd=function(){var l=LV[row.pin()];st.textContent=l?'High':'Low (GND)';st.style.color=l?'var(--muted)':'var(--ok)';st.style.fontWeight=l?'normal':'bold';};
      if(gp)gp.onchange=row.upd;
      rows.push(row);row.upd();
      [c1,c2,c3,c4,c5].forEach(function(c){tr.appendChild(c);});tb.appendChild(tr);
    }
    var used=list.filter(function(j){return j.t;}),free=list.filter(function(j){return !j.t;});
    used.forEach(function(j){addRow(j,null);});
    if(free.length)addRow({t:'',x:'',v:-1},free);
    else if(!used.length){var r=el('tr'),c=el('td');c.textContent='Keine freien Pins';r.appendChild(c);tb.appendChild(r);}
  }
  function saveAll(){
    var todo=rows.filter(function(r){return r.dirty();}),n=0,bad='';
    if(!todo.length){showRes('pinResult',{ok:true,msg:'Keine \u00c4nderungen'});return;}
    todo.reduce(function(pr,r){return pr.then(function(){return fetch('/api/pins',{method:'POST',body:new URLSearchParams({pin:r.pin(),type:r.sel.value,text:r.tx.value,vol:r.vo.value})}).then(function(x){return x.json();}).then(function(j){if(j.ok)n++;else bad=bad||(j.error||'Fehler');}).catch(function(){bad=bad||'Keine Antwort vom Ger\u00e4t';});});},Promise.resolve())
    .then(function(){showRes('pinResult',bad?{ok:false,error:bad}:{ok:true,msg:n+(n===1?' Pin gespeichert':' Pins gespeichert')});if(n>0)load(true);});
  }
  function load(first){fetch('/api/pins',{cache:'no-store'}).then(function(r){return r.json();}).then(function(j){var l=j.pins||[];if(first)build(l);else{l.forEach(function(q){LV[q.p]=q.l;});rows.forEach(function(r){r.upd();});}}).catch(function(){});}
  var ready=false;
  window.pinsInit=function(){var sv=document.getElementById('pinSave');if(sv)sv.onclick=saveAll;ready=true;lists(function(){load(true);});};
  var tab=document.getElementById('tab-pins');if(tab)tab.addEventListener('change',function(){if(tab.checked&&ready)lists();});
  setInterval(function(){var t=document.getElementById('tab-pins');if(document.hidden||!t||!t.checked)return;load(false);},1000);
})();
)js";
static const char LANG_JS[] PROGMEM = R"js(
(function(){
  var code='';try{code=localStorage.getItem('uilang')||'';}catch(e){}
  var T=null,R=[],mo=null,SKIP=/^(SCRIPT|STYLE|CODE|PRE|TEXTAREA|SVG)$/,INL=/^(CODE|EM|STRONG|B|KBD)$/,ATTR=['title','placeholder','aria-label','label'];
  function norm(s){return s.replace(/\s+/g,' ').trim();}
  function look(k){var kk=UI_HOST?k.split(UI_HOST).join('{host}'):k,v=T[kk];
    if(v===undefined){for(var i=0;i<R.length;i++){if(R[i][0].test(kk)){v=kk.replace(R[i][0],R[i][1]);break;}}}
    return v===undefined?undefined:(UI_HOST?v.split('{host}').join(UI_HOST):v);}
  function trText(s){var k=norm(s);if(!k)return s;var v=look(k);if(v===undefined)return s;return s.match(/^\s*/)[0]+v+s.match(/\s*$/)[0];}
  function safe(v){var tp=document.createElement('template');tp.innerHTML=v;[].forEach.call(tp.content.querySelectorAll('*'),function(e){if(!INL.test(e.nodeName.toUpperCase())){e.remove();return;}while(e.attributes.length)e.removeAttribute(e.attributes[0].name);});return tp.innerHTML;}
  function trAttrs(n){ATTR.forEach(function(a){if(n.hasAttribute&&n.hasAttribute(a)){var v=n.getAttribute(a),t=trText(v);if(t!==v)n.setAttribute(a,t);}});}
  function inlineMixed(e){var el=0,tx=0;for(var c=e.firstChild;c;c=c.nextSibling){if(c.nodeType===1){if(!INL.test(c.nodeName.toUpperCase())||c.id||c.querySelector('[id]'))return 0;el=1;}else if(c.nodeType===3){if(/[A-Za-zÄÖÜäöüß]/.test(c.nodeValue))tx=1;}else if(c.nodeType!==8)return 0;}return el&&tx;}
  function walk(n){
    if(n.nodeType===3){var p=n.parentNode;if(p&&SKIP.test(p.nodeName.toUpperCase()))return;var t=trText(n.nodeValue);if(t!==n.nodeValue)n.nodeValue=t;return;}
    if(n.nodeType!==1||SKIP.test(n.nodeName.toUpperCase()))return;
    trAttrs(n);
    if(inlineMixed(n)){var v=look(norm(n.innerHTML));if(v!==undefined){n.innerHTML=safe(v);return;}}
    for(var c=n.firstChild;c;c=c.nextSibling)walk(c);
  }
  function watch(){mo.observe(document.body,{childList:true,subtree:true,characterData:true,attributes:true,attributeFilter:ATTR});}
  function onMut(ms){mo.disconnect();ms.forEach(function(m){if(m.type==='childList')m.addedNodes.forEach(walk);else if(m.type==='characterData')walk(m.target);else trAttrs(m.target);});watch();}
  function dialogs(){['confirm','prompt','alert'].forEach(function(n){var o=window[n];window[n]=function(m,d){return o.call(window,typeof m==='string'?trText(m):m,d);};});}
  function langList(){var b=document.getElementById('langBtn');
    if(b){b.style.display='';b.textContent=code?'DE':'EN';b.onclick=function(){try{if(code)localStorage.removeItem('uilang');else localStorage.setItem('uilang','en');}catch(e){}location.reload();return false;};}
    if(mo&&T&&b){mo.disconnect();walk(b);watch();}}
  window.langList=langList;
  if(code){
    fetch('/lang.json?l='+encodeURIComponent(code),{cache:'no-cache'}).then(function(r){return r.json();}).then(function(j){
      T=j.t||{};R=(j.r||[]).map(function(x){return [new RegExp(x[0]),x[1]];});
      dialogs();mo=new MutationObserver(onMut);walk(document.body);document.title=trText(document.title);document.documentElement.lang=code;watch();langList();
    }).catch(function(){langList();});
  }else langList();
})();
)js";
static const char PAGE_JS[] PROGMEM = R"js(
function showRes(id,r){var el=document.getElementById(id);if(!el)return;
  el.className=r.ok?'res-ok':'res-bad';el.innerHTML=(r.ok?'&#10004; ':'&#10008; ')+(r.ok?(r.msg||'OK'):(r.error||'Fehler'));}
function postApi(path,params,resId){
  return fetch(path,{method:'POST',body:new URLSearchParams(params)}).then(function(r){return r.json();}).then(function(j){showRes(resId,j);return j;})
    .catch(function(){showRes(resId,{ok:false,error:'Keine Antwort vom Ger&auml;t'});});
}
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
