holgiw/ESP32-netspeaker/(commit log)

2026-10-28 NetSpeaker: ESP32-S3 network speaker with web radio, VoiceRSS announcements, MP3/SD playback, MQTT and web UI
2026-10-28 NetSpeaker 1.0.0: preset station in slot 1, new changelog
2026-10-29 NetSpeaker 1.1.0: shuffle and loop for SD folders, no fading of announcements
    - Folders of the SD card can play in random order (shuffle=1), every file once
    per session, never starting with the file the last session started with;
    loop=1 starts a reshuffled round. Folders are fed one file at a time.
    - Announcements and files are no longer faded in or out; the radio still is.
    - README: SD note updated after the first test with a real card.
    [netspeaker.ino, web_ui.h]
2026-10-29 NetSpeaker 1.2.0: announcements over playing files, progress bar, loudness matching, stream info
    - An announcement is mixed quietly over a running MP3 file instead of stopping it.
    - Progress bar under the name, byte-based and interpolated in the browser; random and
    folder buttons also in the root of the SD card.
    - MP3 files fade in and out; announcements never do.
    - Volume of MP3 files is matched: measured once in the background, stored in /loudness.bin.
    - Collapsible stream info in the web radio tab; contact card in the documentation.
2026-10-29 NetSpeaker 1.2.1: delayed title display, title rule time limit, start tone, stream info
    - Radio titles are shown (and passed to the title rule) delayed by the buffered sound.
    - Title rule: optional time limit in seconds, so ads after a title do not stay loud.
    - Short start tone ("buub"); off after a restart via MQTT, after own restarts, after a crash
    and in safe mode.
    - Stream info shows codec, sample rate and channels.
    - Tab MP3 renamed to MP3 (Flash); brand in the status bar is now SPEAKER.
    [config.h, netspeaker.ino, web_ui.h]
2026-10-30 NetSpeaker 1.3.0: language files, input pins with actions, pull-ups, SD status
    - Web interface languages as files in the device storage, applied in the browser;
    lang/en.json for English, lang/README.md and lang/untranslated.js.
    - New tab Eingaenge: free pins with pull-up; contact to GND plays an announcement,
    an MP3 file, a folder of the SD card or a URL; file chooser for flash and SD card.
    - Pins that are not configured (no strapping pins, no status LED) get a pull-up.
    - Status tab shows size, used, free and the pins of the SD card.
    - Value next to the volume slider; progress bar hidden for web radio.
2026-10-30 NetSpeaker 1.3.1: log auto-off, MQTT login, web radio on inputs, docs
    - Writing the log to the file switches itself off after an adjustable time (default 60 min).
    - Optional MQTT user and password; the password is neither shown nor exported.
    - Inputs tab: web radio station as an action, file chooser for flash and SD card, GPIO 33-37
    as free pins on quad PSRAM, no wrapping of the pin cell.
    - MQTT tab more compact; docs completed (pins, languages, status fields, volume 0-100).
2026-10-30 NetSpeaker 1.3.3: flashAll asks for the WiFi, README on WiFi setup while flashing
    - flashAll.bat now also asks for the WiFi after flashing a device on USB (switch -AskWifi
    of voicesetup.ps1); with -Yes the question is skipped.
    - README describes setting up the WiFi while flashing (German and English).
2026-10-30 Flash tools in build_netspeaker like the clock: download of the firmware from the release
    - flashESP.bat and voicesetup.ps1 moved to build_netspeaker/; without a local build they download
    netspeaker-esp32s3.zip from the newest release and check the SHA-256 sum.
    - publish_builds.ps1 creates the packages (firmware zip, checksum, tools zip with esptool.exe)
    and uploads them to a release with -Upload.
    - README: section on flashing the finished firmware; esptool in the license table.
2026-10-30 Firmware 1.3.5 in build_netspeaker/esp32s3: repository ZIP contains the .bin files, README hint adjusted
2026-10-30 Repository renamed to ESP32-netspeaker: addresses in code, scripts and docs, firmware rebuilt
2026-10-30 NetSpeaker 1.3.7: 30 station slots, save/load station list, flash MP3 over SD file, speech lowers at once, file lookup flash then SD, group topics via REST
2026-10-30 NetSpeaker 1.3.8: playback priority (flash MP3, speech, SD MP3, web radio), crash fix for the first name lookup after boot
    [netspeaker.ino]
2026-10-30 NetSpeaker 1.3.9: Opus decoder removed, second mix track, tabs in playback priority order
2026-10-31 NetSpeaker 1.4.2: RSA always at slot 1 when a list is loaded, clearer station list section, -O2 and double audio loop against stuttering AAC
2026-11-01 NetSpeaker 1.4.4: web radio level matching, favorites (file storage, export, API buttons), RSA delete rule, start tone at volume 50, long list selection
2026-11-04 NetSpeaker 1.4.5: mute button and API, stop and mute behind the volume slider, favorites reported via MQTT
2026-11-04 Changelog 1.4.5: position of the stop and mute buttons
2026-11-04 NetSpeaker 1.4.7: rename MP3 files in the device, mute only for web radio and SD files
2026-11-04 NetSpeaker 1.4.8: stations of your own country from radio-browser, protected favorite deleting, mute fixes, RSA favorite fix
    [netspeaker.ino, web_ui.h]
2026-11-04 NetSpeaker 1.4.9: test button for the VoiceRSS voice
2026-11-06 NetSpeaker 1.4.13: pin actions for radio control, new pin table with one save button
2026-11-11 NetSpeaker 1.5.0: web radio prebuffer, no sound stalls from web requests, new WiFi tab, mute for text announcements, wiring view
    [netspeaker.ino, web_ui.h]
2026-11-11 NetSpeaker 1.5.1: SD reader pin order in wiring view corrected
2026-11-11 NetSpeaker 1.5.2: English translation repaired and completed, umlaut fixes
    [web_ui.h]
2026-11-13 Wiring pictures: correct notes on the SD pin of the amplifier (voltage table, module dependent)
2026-11-13 Wiring pictures and README: note on stereo with a second MAX98357A module
2026-11-13 NetSpeaker 1.6.3: web radio always without effect, fx parameter for announcements, stereo and SD pin notes
2026-11-14 NetSpeaker 1.6.7: a new file can take over the main track while the second one plays on without a gap
2026-11-14 Docs: new screenshots of the current web interface (Ansage, Sicherung, English view)
